chanelleblan/SumobotSkripsie/Tests/Edge detection test/No_brake_Run3.jpeg

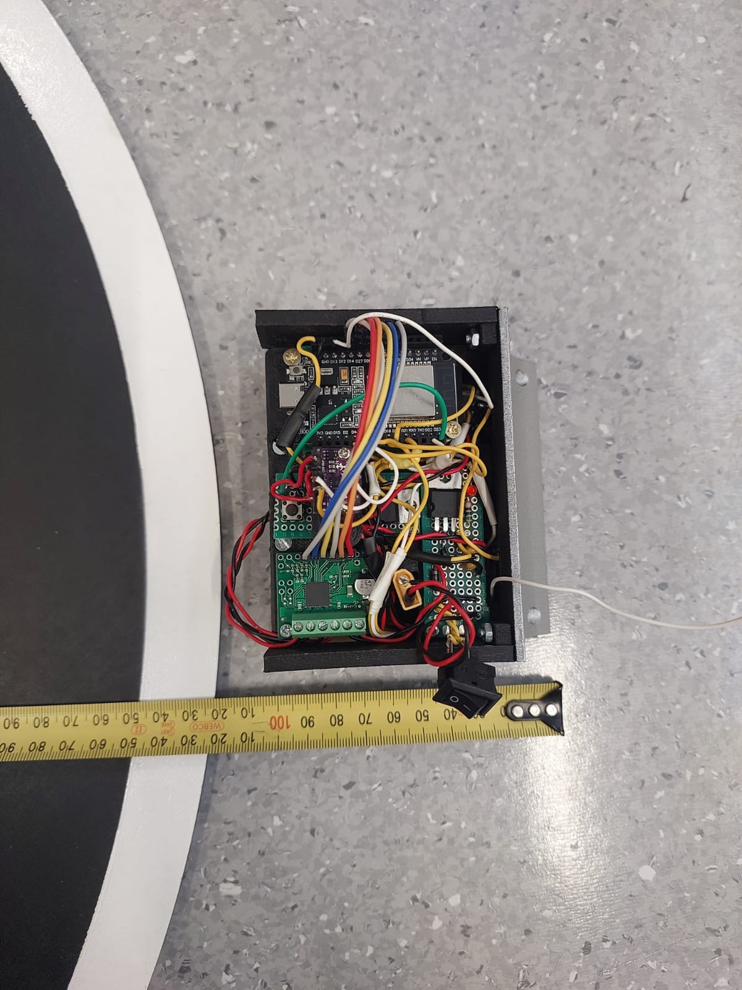
Tests/Edge detection test/No_brake_Run3.jpeg
