chanelleblan/SumobotSkripsie/KiCAD/report.txt

Plotted to 'C:\Users\chane\OneDrive\Documents\Uni files\4th year\Skripsie\sumobot\sumobot.pdf'.

Info: Done.
Info: Done.
