chanelleblan/SumobotSkripsie/FEA/Wedge.ipt Stress Analysis Report 2026_10_19.html

Image Width (pixels):

# Stress Analysis Report

Analyzed File: | Wedge.ipt
Autodesk Inventor Version: | 2026.2 (Build 302298000, 298)
Creation Date: | 2026/10/19, 21:41
Study Author: | CHANELLE BLANCHè
Summary:

## Static Analysis:1

General objective and settings:

Design Objective | Single Point
Study Type | Static Analysis
Last Modification Date | 2026/10/19, 19:17
Model State | [Primary]
Detect and Eliminate Rigid Body Modes | No

### iProperties

#### Summary

Title | side panel v41
Author | AdminForWorker

#### Project

Part Number | side panel
Designer | AdminForWorker
Estimated Cost | R0,00
Creation Date | 2026/10/14

#### Status

Design State | WorkInProgress

#### Physical

Material | Generic
Density | 1 g/cm^3
Mass | 0,0205233 kg
Area | 16021,5 mm^2
Volume | 20523,3 mm^3
Center of Gravity | x=37,5145 mm y=50,9986 mm z=26,8545 mm

Note: Physical values could be different from Physical values used by FEA reported below.

Mesh settings:

Avg. Element Size (fraction of model diameter) | 0.1
Min. Element Size (fraction of avg. size) | 0.2
Grading Factor | 1.5
Max. Turn Angle | 60 deg
Create Curved Mesh Elements | Yes

### Material(s)

Name | PC/ABS Plastic
General | Mass Density | 1,1 g/cm^3
| Yield Strength | 54,4 MPa
| Ultimate Tensile Strength | 54,4 MPa
Stress | Young's Modulus | 2,78 GPa
| Poisson's Ratio | 0,4 ul
| Shear Modulus | 0,992857 GPa
Part Name(s) | Wedge.ipt

### Operating conditions

#### Force:1

Load Type | Force
Magnitude | 5,000 N
Vector X | 0,000 N
Vector Y | -5,000 N
Vector Z | 0,000 N

##### Selected Face(s)

#### Fixed Constraint:2

Constraint Type | Fixed Constraint

##### Selected Face(s)

#### Fixed Constraint:1

Constraint Type | Fixed Constraint

##### Selected Face(s)

### Results

#### Reaction Force and Moment on Constraints

Constraint Name | Reaction Force | | Reaction Moment
| Magnitude | Component (X,Y,Z) | Magnitude | Component (X,Y,Z)
Fixed Constraint:2 | 4,11963 N | 3,51413 N | 0,0198766 N m | 0 N m
| | 0 N | | 0,0198746 N m
| | -2,14994 N | | 0,000278104 N m
Fixed Constraint:1 | 4,16256 N | 0,976093 N | 0,020159 N m | 0 N m
| | 0 N | | -0,020159 N m
| | 4,0465 N | | 0 N m

#### Result Summary

Name | Minimum | Maximum
Volume | 20530,3 mm^3
Mass | 0,0225833 kg
Von Mises Stress | 0,000803823 MPa | 0,859331 MPa
1st Principal Stress | -0,357025 MPa | 0,981189 MPa
3rd Principal Stress | -1,10224 MPa | 0,118242 MPa
Displacement | 0 mm | 0,00662632 mm
Safety Factor | 15 ul | 15 ul
Stress XX | -0,853356 MPa | 0,41657 MPa
Stress XY | -0,171282 MPa | 0,195491 MPa
Stress XZ | -0,159535 MPa | 0,392589 MPa
Stress YY | -0,568904 MPa | 0,206678 MPa
Stress YZ | -0,0829777 MPa | 0,0870701 MPa
Stress ZZ | -0,568904 MPa | 0,80384 MPa
X Displacement | -0,00582415 mm | 0,000840057 mm
Y Displacement | -0,00127097 mm | 0,00127517 mm
Z Displacement | -0,00329077 mm | 0,00118159 mm
Equivalent Strain | 0,000000275279 ul | 0,000291659 ul
1st Principal Strain | -0,000000308708 ul | 0,000312628 ul
3rd Principal Strain | -0,000278707 ul | -0,000000143047 ul
Strain XX | -0,00022606 ul | 0,000065817 ul
Strain XY | -0,0000862569 ul | 0,0000984489 ul
Strain XZ | -0,0000803412 ul | 0,000197707 ul
Strain YY | -0,000160855 ul | 0,0000867544 ul
Strain YZ | -0,0000417873 ul | 0,0000438483 ul
Strain ZZ | -0,0000261425 ul | 0,000223316 ul

#### Figures

##### Von Mises Stress

##### 1st Principal Stress

##### 3rd Principal Stress

##### Displacement

##### Safety Factor

##### Stress XX

##### Stress XY

##### Stress XZ

##### Stress YY

##### Stress YZ

##### Stress ZZ

##### X Displacement

##### Y Displacement

##### Z Displacement

##### Equivalent Strain

##### 1st Principal Strain

##### 3rd Principal Strain

##### Strain XX

##### Strain XY

##### Strain XZ

##### Strain YY

##### Strain YZ

##### Strain ZZ

C:\Users\chane\OneDrive\Documents\Uni files\4th year\Skripsie\Final Drawings\Wedge.ipt

Image Width (pixels):
