chanelleblan/SumobotSkripsie/Planning/SPECS AND TPMS.docx

Table 1: Functional Requirements for the Sumo Robot

FR ID | Description | Primary / Derived
FR_01 | The robot must detect the opponent/ opposing robot. | Primary
FR_02 | The robot must detect the edge of the dohyo. | Primary
FR_03 | The robot must move within the dohyo. | Primary
FR_04 | The robot must apply sufficient force to push the opponent out of the dohyo. | Derived
FR_05 | The robot must respond in real-time to the opponent. | Derived
FR_06 | The robot must operate autonomously. | Primary
FR_07 | The robot should remain within the size and weight limits on the competition class. | Primary
FR_08 | The robot must be self-contained. | Primary
FR_09 | The robot must avoid the dohyo edge and prioritise avoiding the dohyo edge over attacking the opponent. | Derived
FR_10 | The robot must begin operation only after the required competition start delay. | Primary
FR_11 | The robot must not damage the dohyo, the opponent robot or itself during normal operation. | Primary

Table 2: Technical Performance Measures

TPM ID | Related FR | Description | Target | Range
TPM_01 | FR_06 | Start time after initial power-on. | 5 s | 3 – 10 s
TPM_02 | FR_01 | Detection of opponent. | 50 ms | 0 – 100 ms
TPM_03 | FR_07 | Size constraints. | 10 cm x 10 cm | -
TPM_04 | FR_07 | Weight constraint. | 500 g | < 500 g
TPM_05 | FR_07 | Height. | 4 cm | < 10 cm
TPM_06 | FR_02 | Edge sensor response. | - | 0 – 100 ms
TPM_07 | FR_03 | Forward movement speed of the robot. | 0.3 m/s | 0.1 m/s – 0.77 m/s
TPM_08 | FR_04 | Pushing force of the robot. | 1.5 kg | 0.5 – 1.5 kg
TPM_09 | FR_08 | Power supply | 6 V | 3 – 12 V
TPM_10 | FR_05 | Sensor response time. | - | 0 – 100 ms
TPM_11 | FR_05 | Robot response time. | - | 0 – 200 ms
TPM_12 | FR_03 | Turning radius (tank turn) | 5 cm | -
TPM_13 | FR_01 | Accurate opponent detection range. | - | 0 – 77 mm
TPM_14 | FR_01 | Opponent detection angle. | ≥ 60° | 40 – 180°
TPM_15 | FR_02 | Edge detection distance from dohyo boundary | - | 0 – 5 mm
TPM_16 | FR_02 | Edge avoidance reaction time | < 100 ms | 0 – 200 ms
TPM_17 | FR_03 | Acceleration time to operating speed | < 1 s | 0.5 – 2 s
TPM_18 | FR_04 | Wheel traction / ability to avoid wheel slip | No slip during push | -
TPM_19 | FR_04 | Push duration before motor stall | ≥ 5 s | 2 – 10 s
TPM_20 | FR_05 | Decision-making/control loop update rate | ≥ 20 Hz | 10 – 100 Hz
TPM_21 | FR_06 | Number of successful autonomous runs. | ≥ 8/10 runs | -
TPM_22 | FR_08 | Battery voltage under load | ≥ 5 V | 4.8 – 6 V
TPM_23 | FR_08 | Battery operating time under active driving | ≥ 12 min | 3 – 24 min
