chanelleblan/SumobotSkripsie/Presentations/Final_present.pptx

## SUMO ROBOT CHANELLE BLANCHE

Photo by Stefan Els

## Introduction

- What is a Sumo Robot?

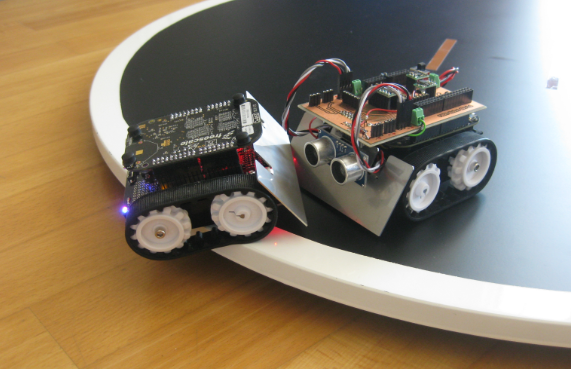
[picture p3: figure]
Mini Sumo Robot Competition running with FRDM-KL25Z | MCU on Eclipse

(Erich Styger, 2013)

- Detects and engages an opponent
- Pushes the opponent outside the circular arena
- Operates without human intervention once the match begins
- Fully autonomous robot

## Competition Rules & Constraints

- Mini Autonomous Sumobot Class

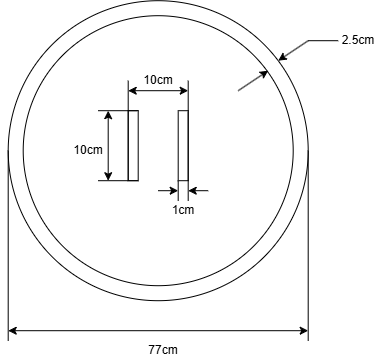
[picture p4: figure]

Constraint | Value
Size | 100 mm x 100 mm
Weight | 500 g
Arena | 770 mm diameter

## Main Strategy

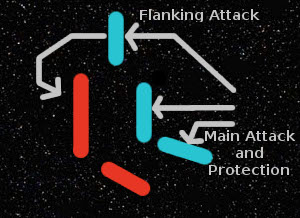
[picture p5: figure]
Master of Tactics' and Making Strategy Games More Strategic | GamingOnLinux

(GamingOnLinux, 2026)

- Most Sumobot hobbyists utilize a DIP switch
- Heavily depends on decision made beforehand
- Fully autonomous
- Gather opponent data
- Focus on out-manoeuvring

## Concept Design

- Overview

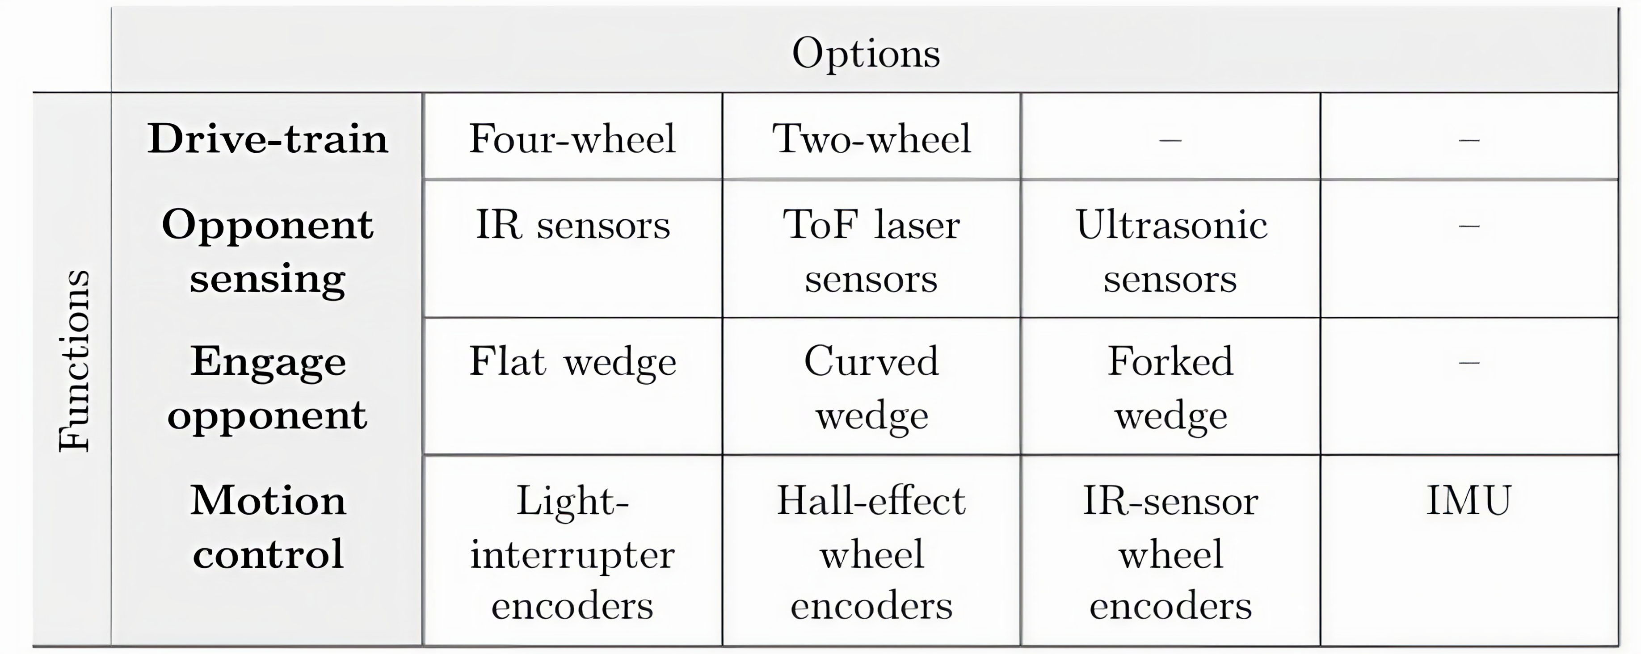
[picture p6: figure]

## Concept Design

- Two-wheel Drive

- Differential drive
- Manoeuvrability
- Space

VL53L0x ToF

- Odd geometry
- Less interference
- Reliable

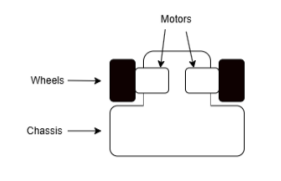
[picture p7: figure]
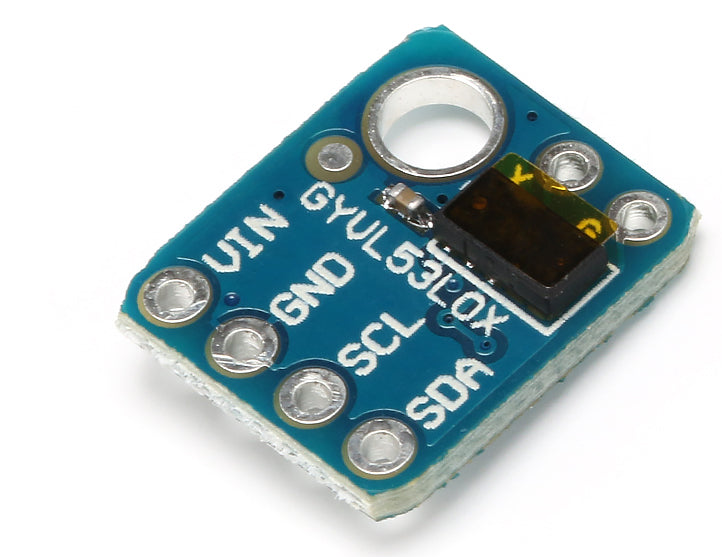
[picture p8: figure]
VL53L0X Time of Flight Sensor (2m Precision Distance Measurements ) – Future Electronics Egypt

(Microrobotics, 2026)

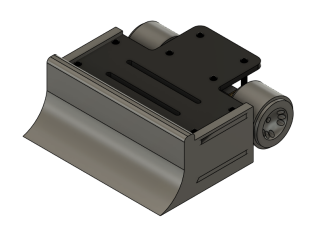
[picture p9: figure]

Curved wedge

- Divert opponent
- Protect sensors

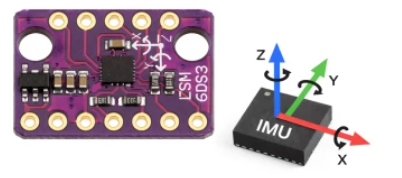
[picture p10: figure]

(Microrobotics, 2026)

LSM6DS3 IMU

- PID and heading control
- Traction control

## Design Refinement

- Opponent Detection Sensors

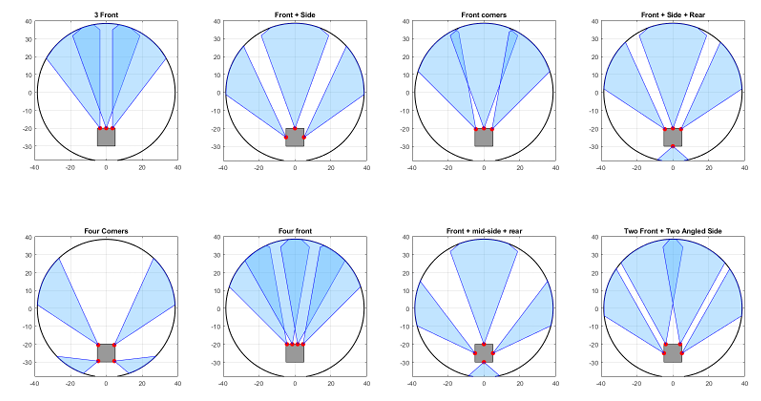
[picture p11: figure]

- Tested to determine placement
- 20 – 30 degrees FOV
- Two front, two angled side chosen

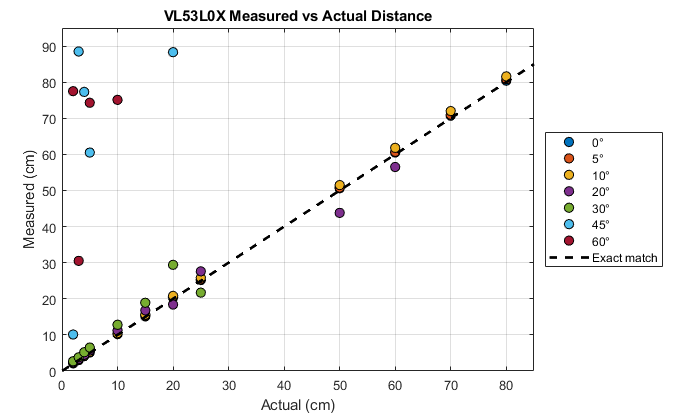
[picture p12: figure]

## Slide 8

Design Refinement

- Main body

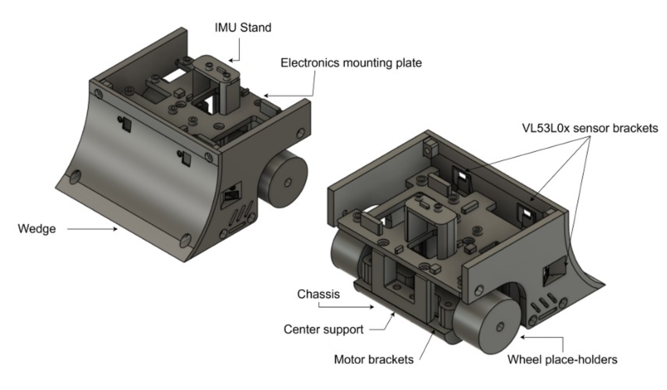
[picture p13: figure]

- PETG
- 300 RPM N20 motors
- 12 V LiPo
- Linear voltage regulators
- QRE1113 IR edge detection
- IMU on driveline
- Casing for extra weights
- ESP32 used to control the system

## Design Refinement

- Wheels

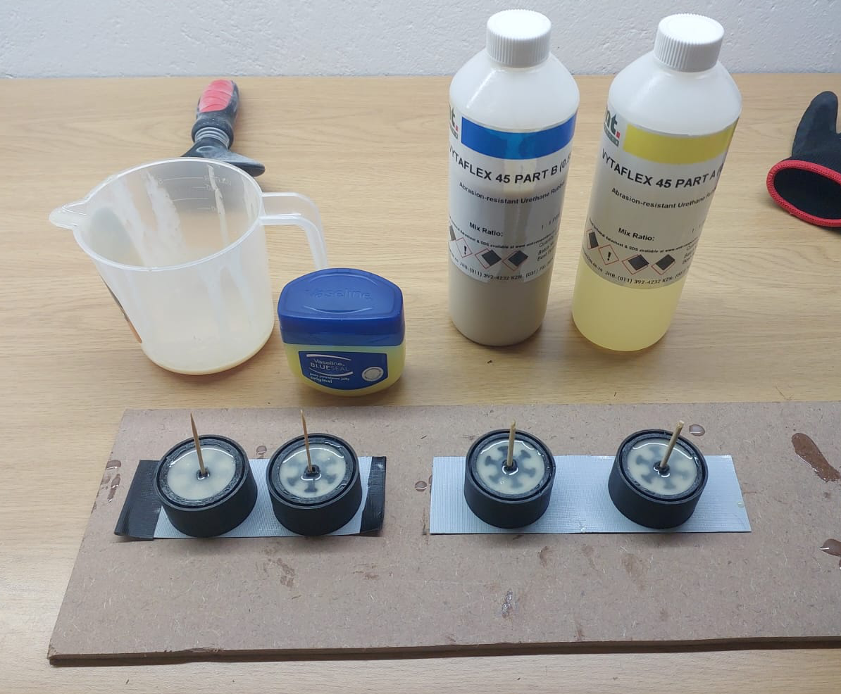
[picture p14: figure]

- Custom-cast polyurethane (VytaFlex) wheels
- High coefficient of friction for increased traction
- Roughly 2.48 compared to 0.36
- Cast directly onto 3D-printed hubs

## Finite State Machine

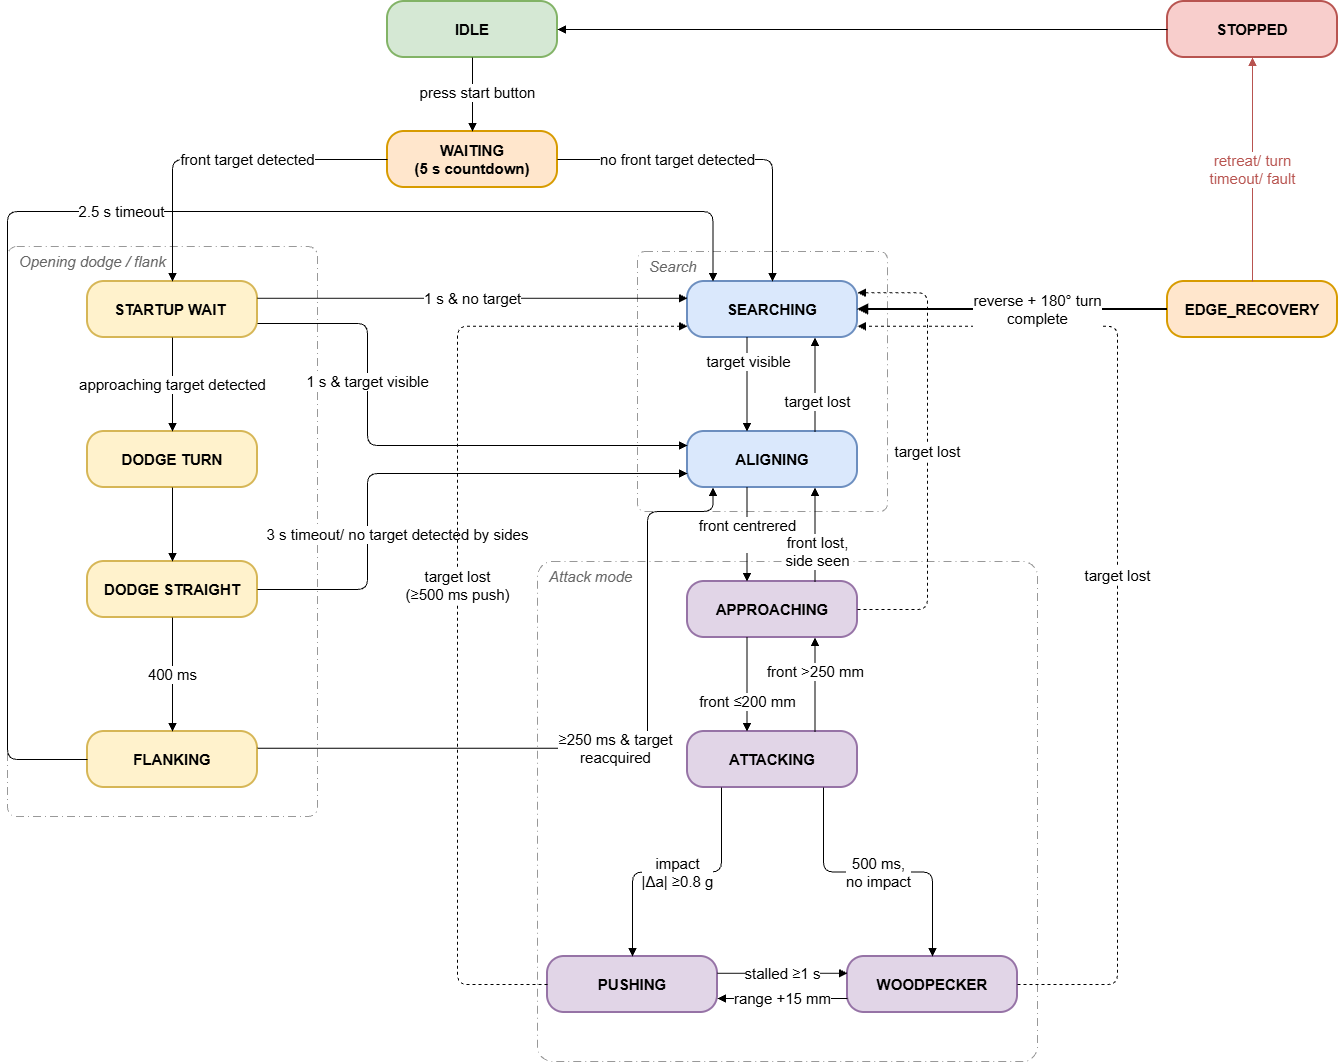
[picture p15: figure]

- Idle state system checks
- Press button
- Searching either detects or waits
- Fast approaching
- Dodge
- Align between front sensors
- Approach starts slow, increases speed
- Engage, override PID, push
- Woodpecker if push lasts for too long
- Edge recovery overrides all states

## Control System

- LSM6DS3 feedback

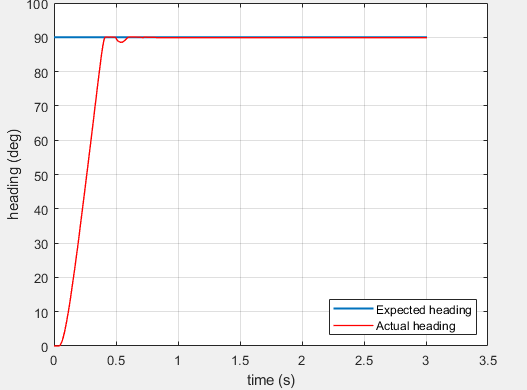
[picture p16: figure]
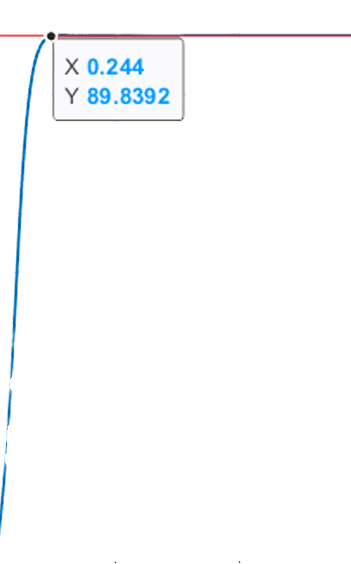
[picture p17: figure]

- PD control
- Similar to simulated response
- Built-in MATLAB functions for differential drive
- I caused sluggish reactions

- Gyroscope and accelerometer
- Used in drones and balancing bots
- PID control
- Impact detection

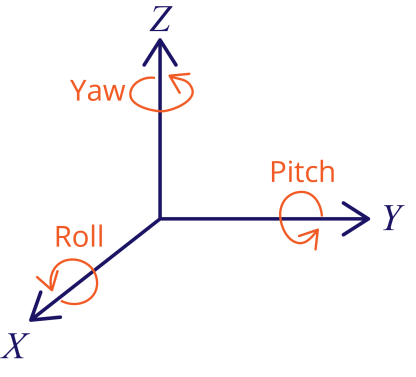
[picture p18: figure]
Arduino Guide for MPU-6050 Accelerometer and Gyroscope | Random Nerd Tutorials

(Sara Santos , 2021)

## Final System Tests

- Speed and edge detection

Opponent detection

- Sensors met TPM for opponent detection distance
- Readings outside of arena
- Threshold implemented
- Speed of search adjusted to allow readings

Autonomous runs

- Edge detection overrides other states
- Braking and edge pivot prevents sliding over the edge
- Speed increases as approaches

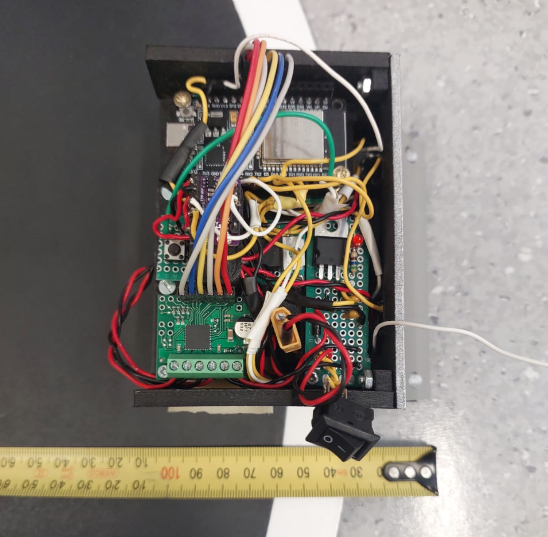
[picture p19: figure]
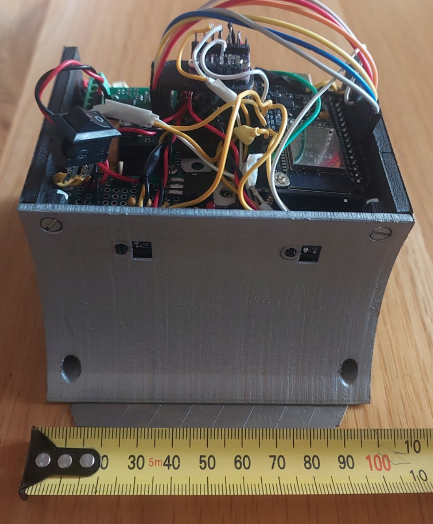
[picture p20: figure]

- 450 g, 10 cm x 10 cm
- Multiple successful runs using stationary weights
- Won 2/3 opponents

## Safety and Risk Mitigation

Risk | Mitigation
Motor stall | Back-off, nFAULT pin
Power supply protection | Linear regulators
Reverse voltage protection | Diodes
Current protection | Fuses
LiPo battery damage | Consistently monitor voltage levels and charge/ handle safely
Component availability low | Back-ups/ alternatives planned
Overall system safety | Modular design, idle state, system stop

## Budget

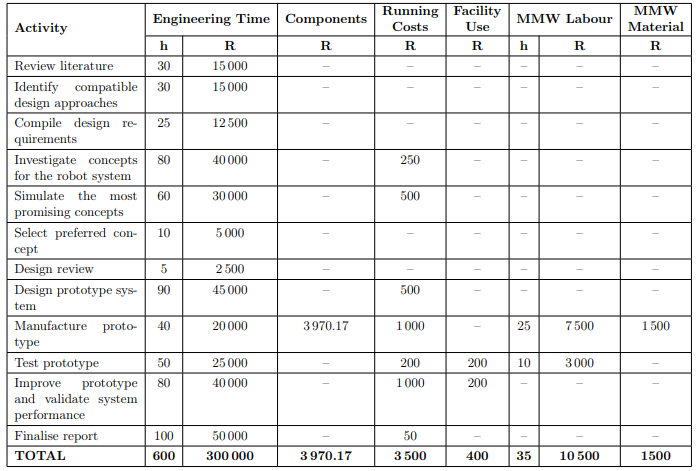
[picture p21: figure]

- Under budget regarding component procurement
- Over the initial planned budget due to prototyping and reprints

## Project Plan

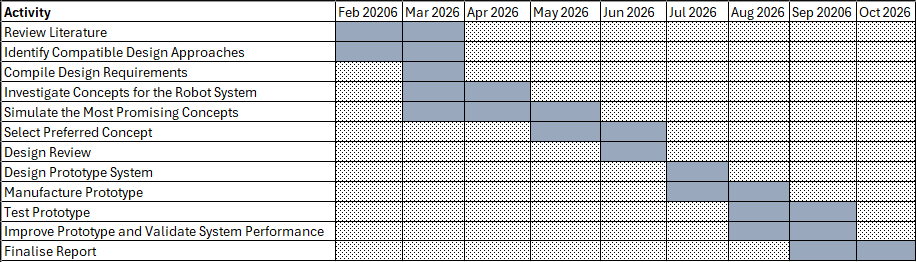
[picture p22: figure]

- Initial plan excluded some categories
- Plan revised in July 2026
- More activities in parallel
- Remained on schedule after revised plan

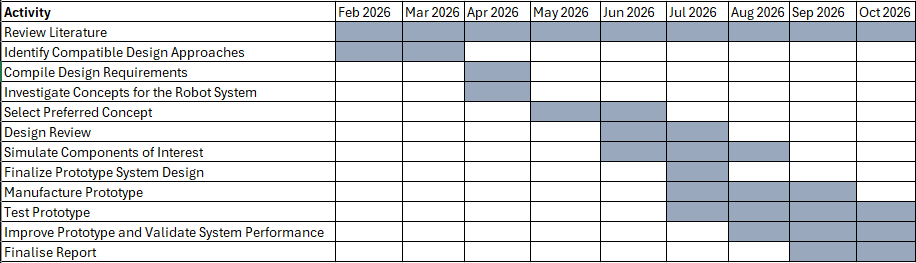
[picture p23: figure]

## Future Work

- Successful sensor array and autonomous runs
- Base framework set in place
- Brushless motors
- Additional states added to FSM
- PCB to organize and optimize electronics
- Manufactured parts

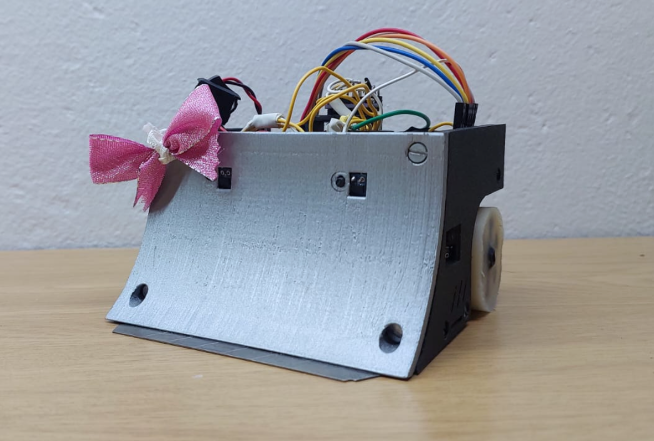
[picture p24: figure]

## Slide 17

Thank you
Enkosi
Dankie

Photo by Stefan Els

## Microcontroller

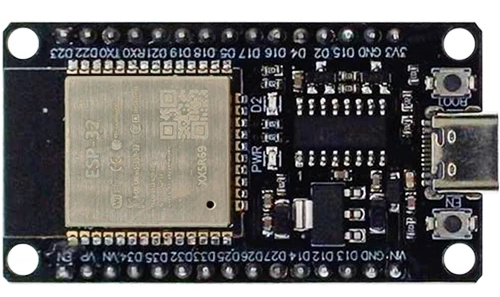
[picture p25: figure]

(Microrobotics, 2026)

- ESP32 DEVKit V1
- Noisy ADCs
- Considered STM32 Black Pill
- 3.3V Logic
- Higher clock speed, more flash

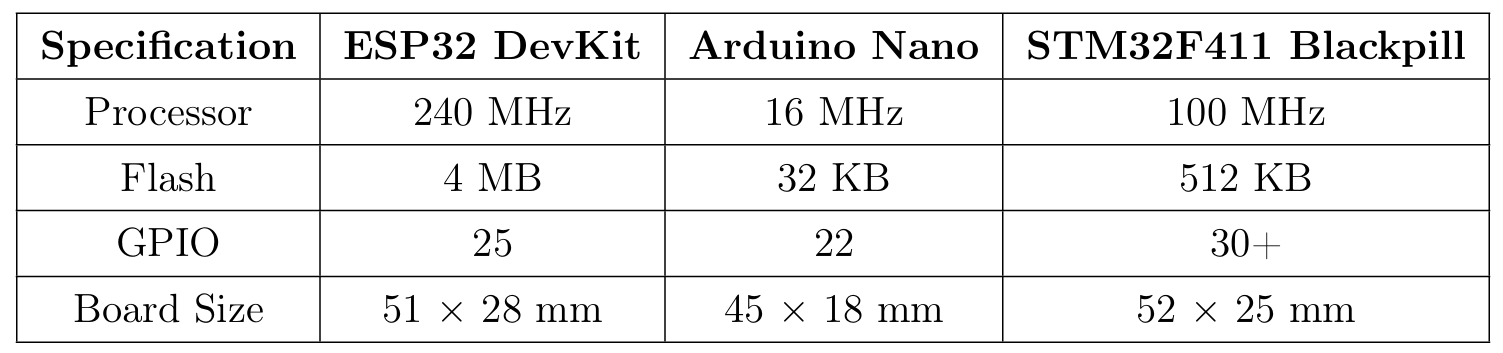
[picture p26: figure]

## Slide 19

VL53L0X Testing

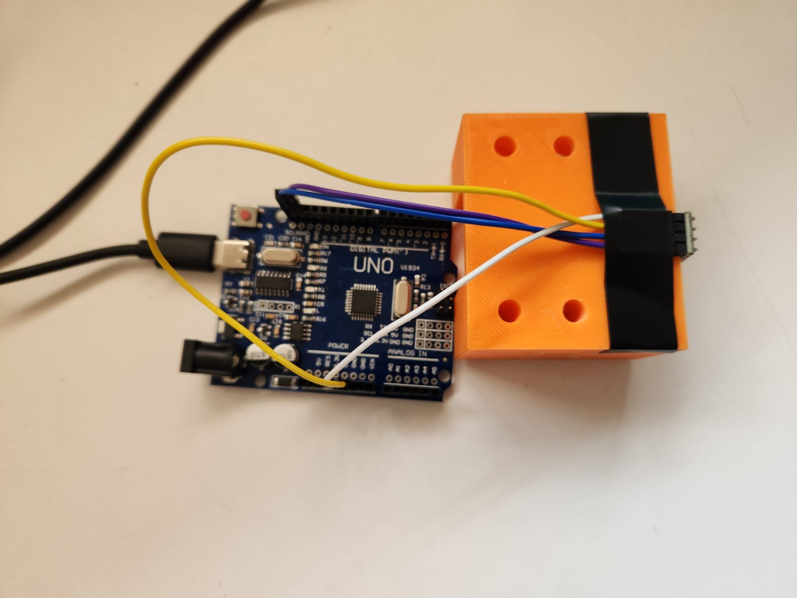
[picture p27: figure]
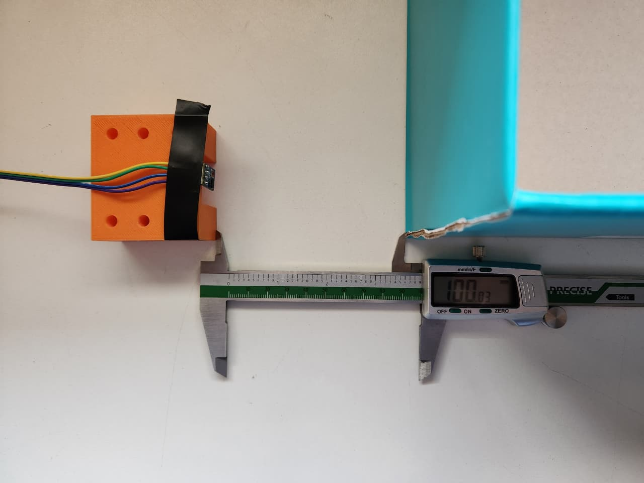
[picture p28: figure]
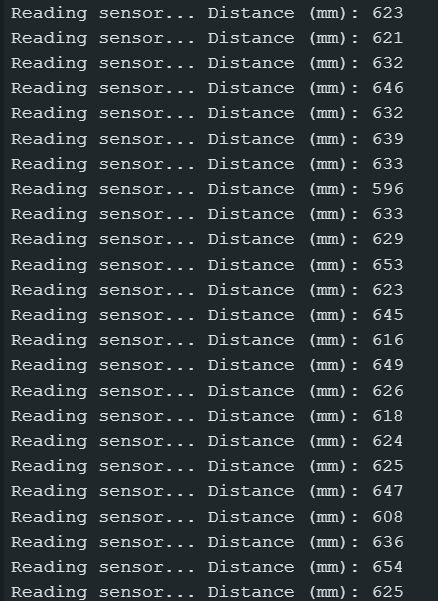
[picture p29: figure]
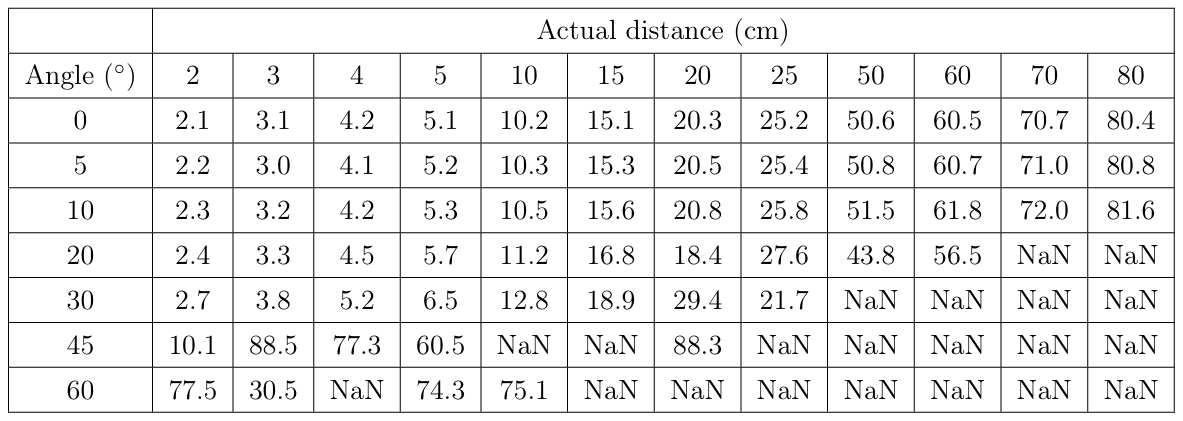
[picture p30: figure]

## Slide 20

Electrical Summary

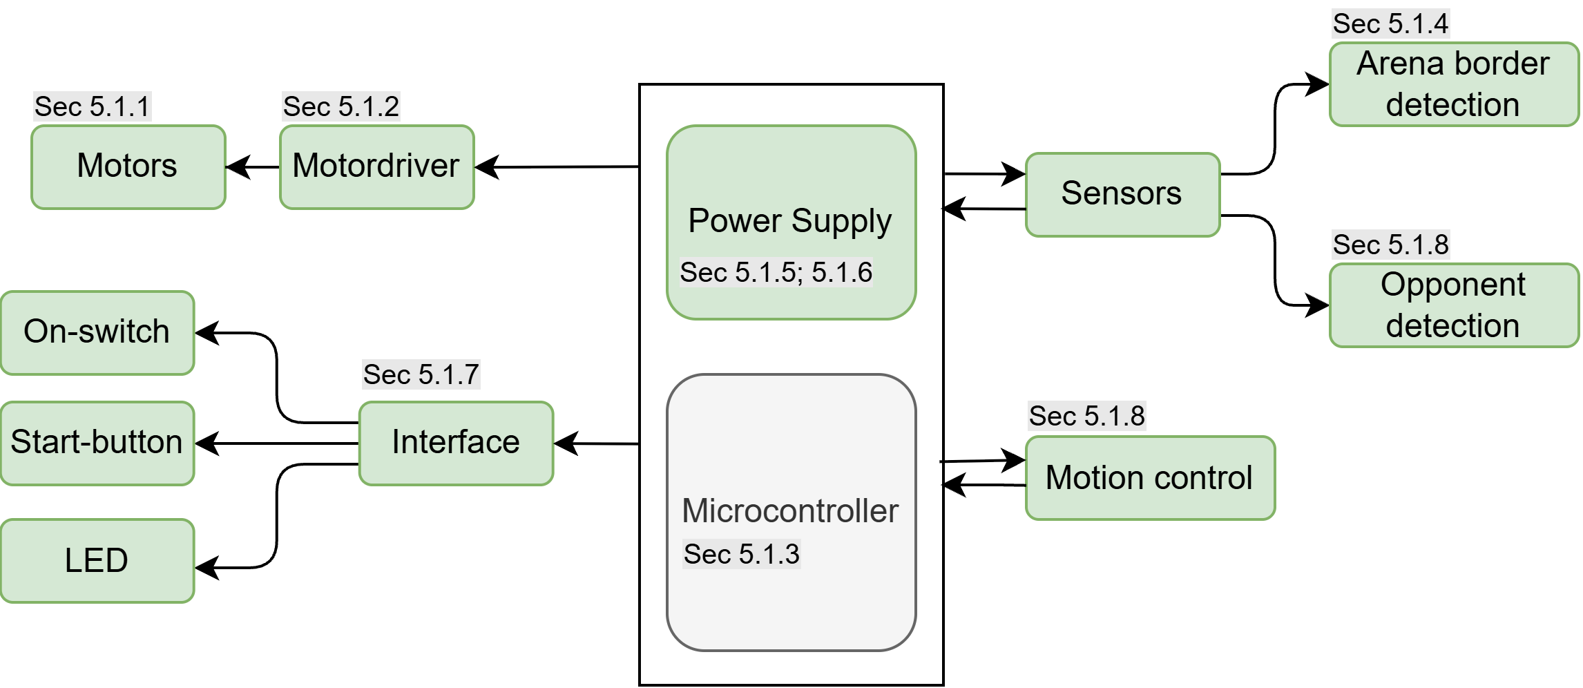
[picture p31: figure]

## Slide 21

Wheel Design

- 2 degree draft angle, lowered from original 5 degree
- Mold release agent
- Molded directly to hub

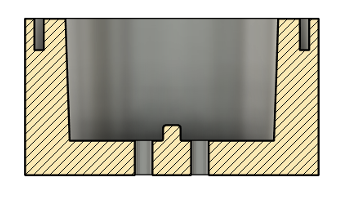
[picture p32: figure]
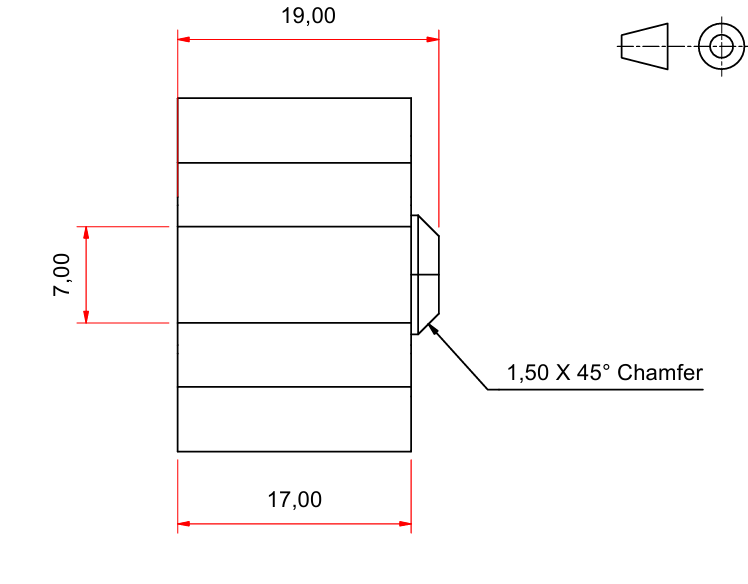
[picture p33: figure]

- Release on round edge of D-slot
- Slides onto D-shaft
- Brackets for extra grip onto polyurethane

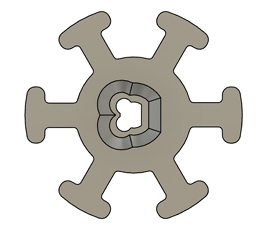
[picture p34: figure]

## Slide 22

PETG Safety Test

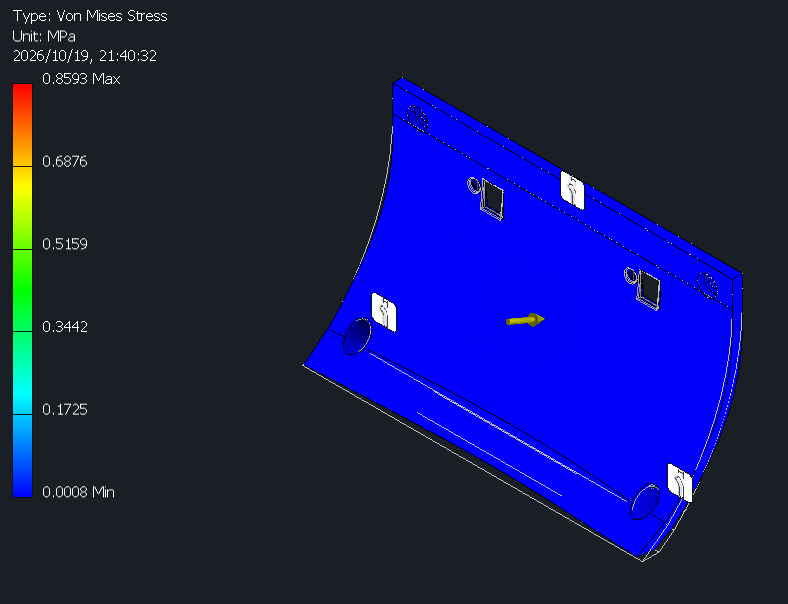
[picture p35: figure]

- Estimated force based on own design
- Doubled the force to account for stronger motors
- SF of 15
- Displacement along the lower front edge, no displacement near sensors

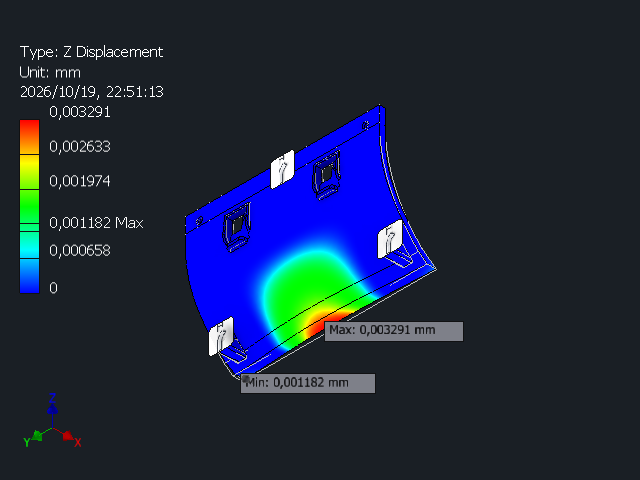
[picture p36: figure]

## Full Schematic Plan

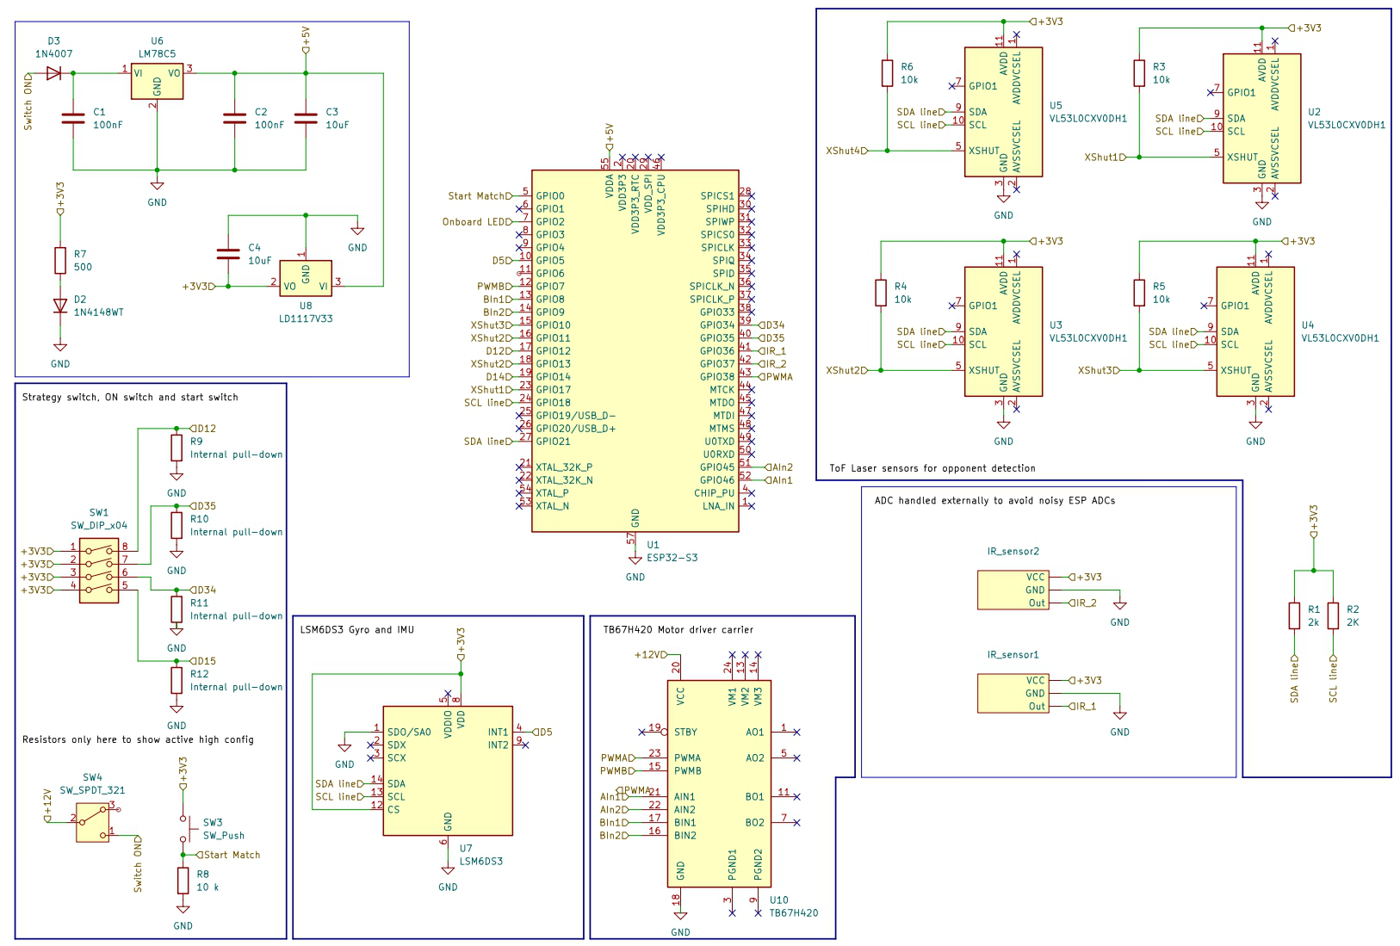
[picture p37: figure]

## System Model

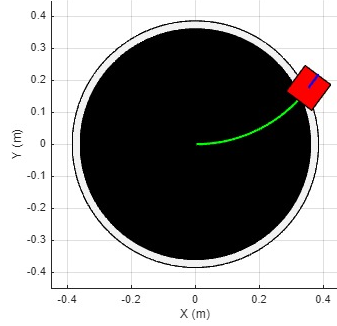
[picture p38: figure]
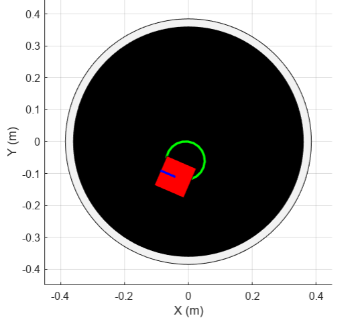
[picture p39: figure]
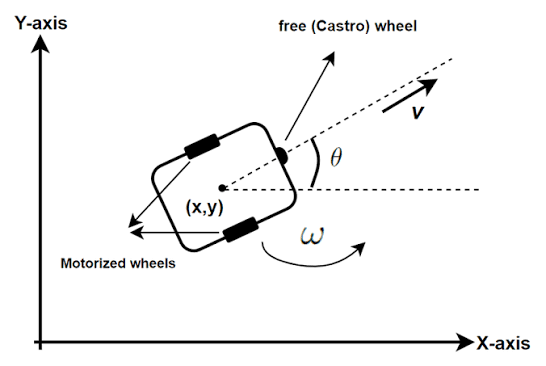
[picture p40: figure]
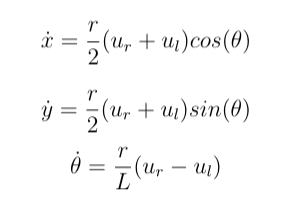
[picture p41: figure]

## Battery

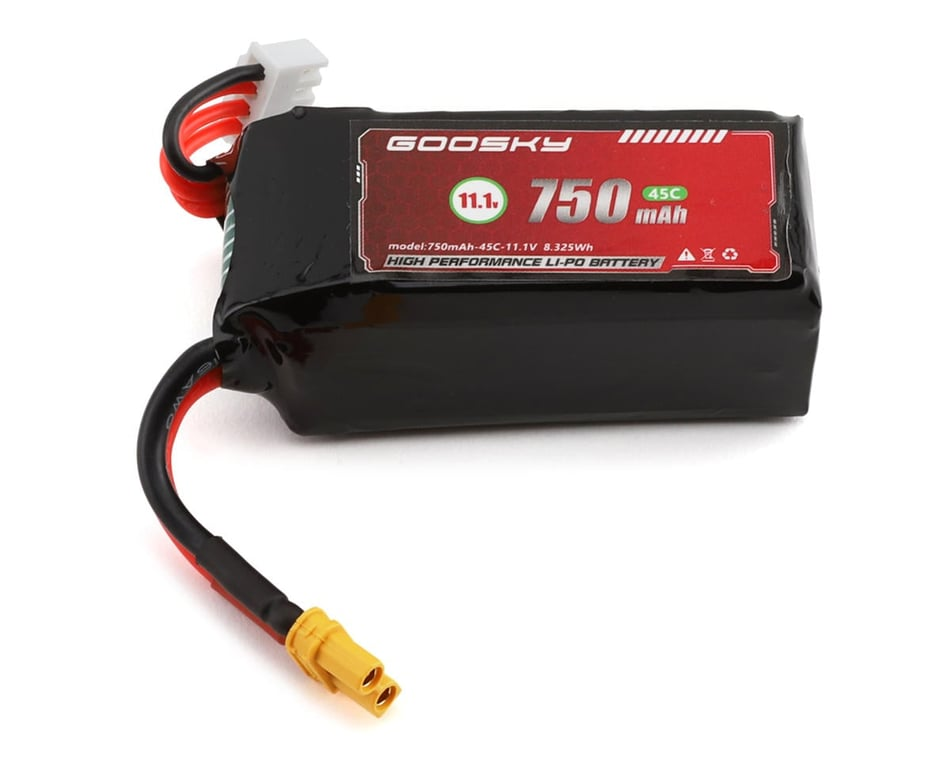
[picture p42: figure]
GooSky S2 RTF Micro Electric Helicopter Combo (Pink) [GSK-BAF000018] - AMain Hobbies

(Goblin Hobbies, 2026)

- 3S 11.1V LiPo Battery
- 45C, 750mAh, 8.125Wh 33A
- 68g
