chanelleblan/SumobotSkripsie/Minutes/Chanelle_AGENDA 12 Oct.docx

Chanelle AGENDA – 12 Oct

- Lit review, move comparison charts?
- PID, software to testing method
- Tensile test
