chanelleblan/SumobotSkripsie/Minutes/Chanelle_AGENDA 14 APR.docx

14 April Agenda – Chanelle Blanchè

- Setting requirements for the pushing force, torque, speed etc
- Simulation advice – MATLAB, Simulink, python
