chanelleblan/SumobotSkripsie/Minutes/Chanelle_AGENDA 17 FEB.docx

AGENDA 17 FEB

- What should be uploaded to the drive (everything or just what we want the supervisor to see)
- Jetson, Arduino uno
- Past skripsies that might help
