chanelleblan/SumobotSkripsie/Minutes/Chanelle_AGENDA 19 Oct.docx

Chanelle_AGENDA 19 Oct

- PID testing flow confirm -> sim, heading PID, turn PID
- Were enough tests discussed? (smaller tests like sensors left out)
- Tuning discussed with tests
- Project file handin after project report handin?
- Safety report: fine to just include risk assessment save space
- Testing steps needed/ photos?
- Include wheel making photos/ process?
- Include friction test in material discussion or in testing section?
