chanelleblan/SumobotSkripsie/Planning/List of Documents.docx

List of Documents:

Admin:

- Part printing tracker
- Parts list
- Price of consumables
- Full budget (consumables and work hours)
- Gannt chart

Reports:

- Project proposal
- Progress report
- Draft report
- Final report
- Summary of how each GA is met

Presentations:

- Progress presentation
- Final presentation (?)

Videos:

- LED test with VL53L0x sensors
- Initial motor test (only motors)
- Initial motor test (bot behaviour)
- Sensor test (follow object)
- Edge test (driving over edge)
- Edge test (slight reverse added to break motors – stops earlier)
- PID step response test (near perfect response)
- PID step response test (visible oscillations)
- Opponent reaction/push test (overshoots reaction)
- Opponent reaction/push test (connects with opponent)
- Searching arena, reacting once opponent is placed inside

Tests:

- VL53L0x angle (view range)
- VL53L0x detection range
- Implemented VL53L0x response time
- IR edge response time
- PID tuning
- PID step response
- Maximum robot speed
- Pushing force
- Autonomous behaviour

Drawings:

- Drawing Tree Excel sheet
- All part drawings
- All sub-assembly drawings (4)
- Full assembly drawing

Schematics:

- Full KiCAD schematic
- LTSpice power supply schematic

Code:

- ESP code (vscode)
- Matlab PID graphs (differential drive)
- Matlab sensor plots
- Matlab sensor layout plan
