chanelleblan/SumobotSkripsie/Presentations/Progress_present.pptx

## SUMO ROBOT CHANELLE BLANCHE

Photo by Stefan Els

## Introduction

- What is a Sumo Robot?

Mini Sumo Robot Competition running with FRDM-KL25Z | MCU on Eclipse

(Erich Styger, 2013)

- Detects and engages an opponent
- Pushes the opponent outside the circular arena
- Operates without human intervention once the match begins
- Fully autonomous robot

## Competition Rules & Constraints

- Mini Autonomous Sumobot Class


Constraint | Value
Size | 100 mm x 100 mm
Weight | 500 g
Arena | 770 mm diameter

## Main Strategy

Master of Tactics' and Making Strategy Games More Strategic | GamingOnLinux

(GamingOnLinux, 2026)

- Most Sumobot hobbyists utilize a DIP switch
- Fully autonomous
- Gather opponent data
- Focus on out-manoeuvring

## Electrical

Electrical Design
Opponent detection sensors
Dohyo edge-detection sensors
Motor driver
Controller
Power supply
Feedback

- Overview

## Electrical

- Opponent Detection Sensors


- VL53L0X ToF
- Detect odd geometry
- I2C Communication – save space
- Effective range of 2m
- Effective angle of 25°
- Tested to determine placement

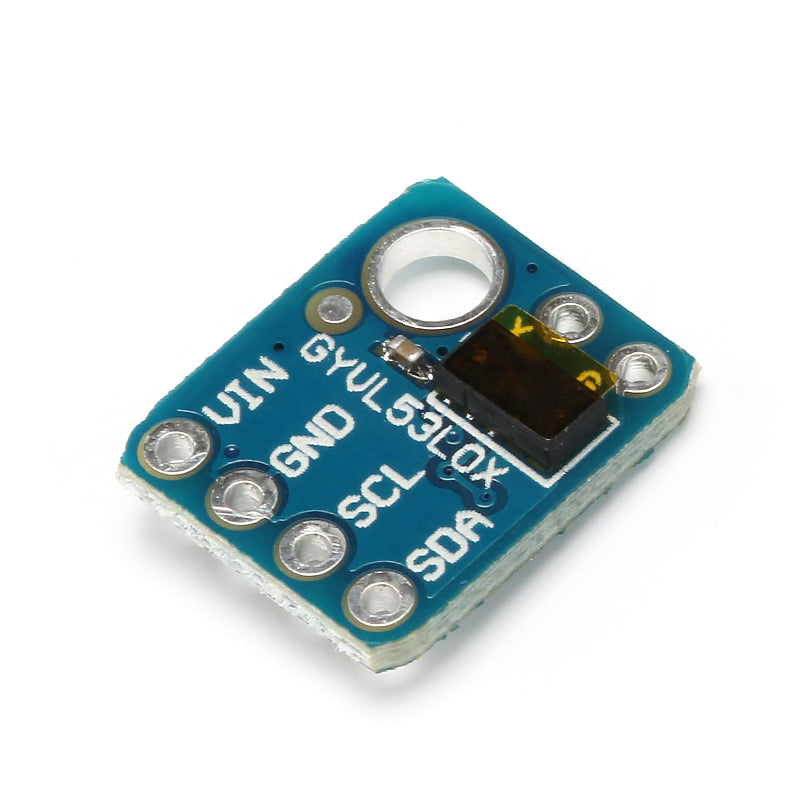
[picture p43: figure]
VL53L0X Time of Flight Sensor (2m Precision Distance Measurements ) – Future Electronics Egypt

(Microrobotics, 2026)

## Electrical

- Dohyo Border Detection Sensors

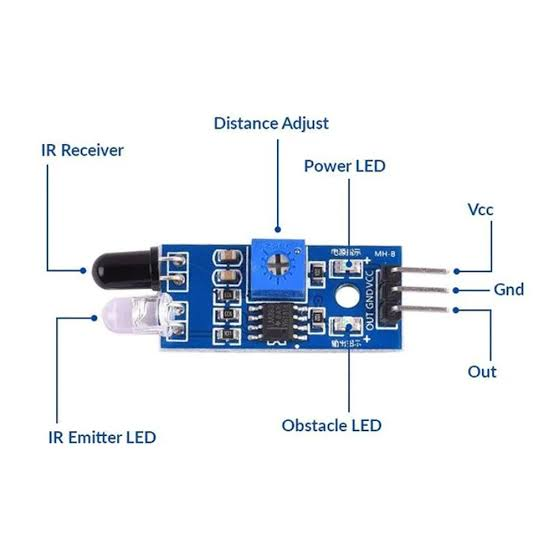
[picture p44: figure]
IR Sensor Digital Single Array Line Sensor | AM Electronics

(Microrobotics, 2026)

- IR Obstacle Detection Sensors
- White vs Black
- On-board potentiometer – Adjustable sensitivity

## Electrical

- Microcontroller

- STM32F411CEU6 Black Pill
- I2C, SPI, ADC, DAC, USART, 11 timers, PWM
- Had enough pins to support all peripherals
- 3.3V Logic
- Flash 512KB, SRAM 128KB, 100 MHz
- Fairly inexpensive

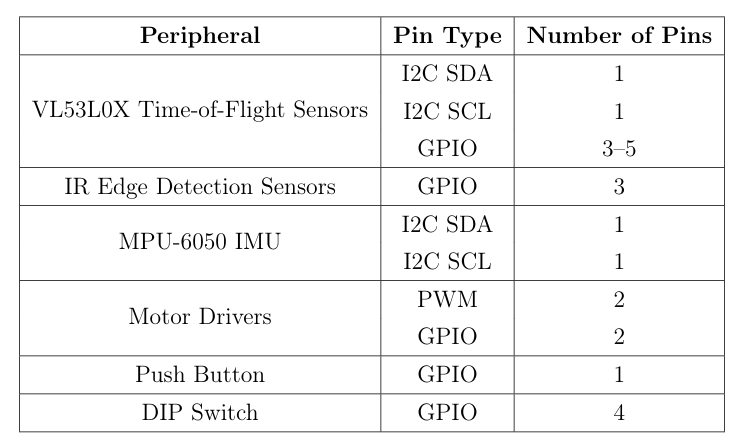
[picture p45: figure]
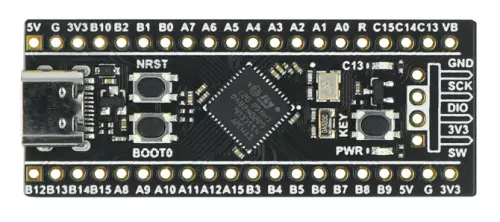
[picture p46: figure]

(Microrobotics, 2026)

## Electrical

- Power supply

GooSky S2 RTF Micro Electric Helicopter Combo (Pink) [GSK-BAF000018] - AMain Hobbies

(Goblin Hobbies, 2026)

- 3S 11.1V LiPo Battery
- 45C, 750mAh, 8.125Wh 33A
- 68g

## Mechanical

- Overview

Mechanical Design
Chassis
Drive train
Wedge
Supporting frame

## Mechanical

- Drive-train

- Differential drive
- Approximately 0 cm turning radius
- 12V N20 500rpm motors
- 30 mm wheels
- Motor driver TB67H420FTG carrier
- Steering is achieved by varying the wheel speeds

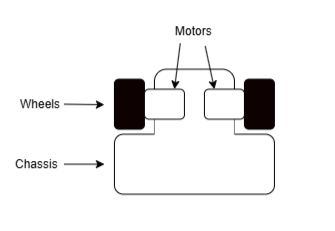
[picture p47: figure]

## Mechanical

- Wheels

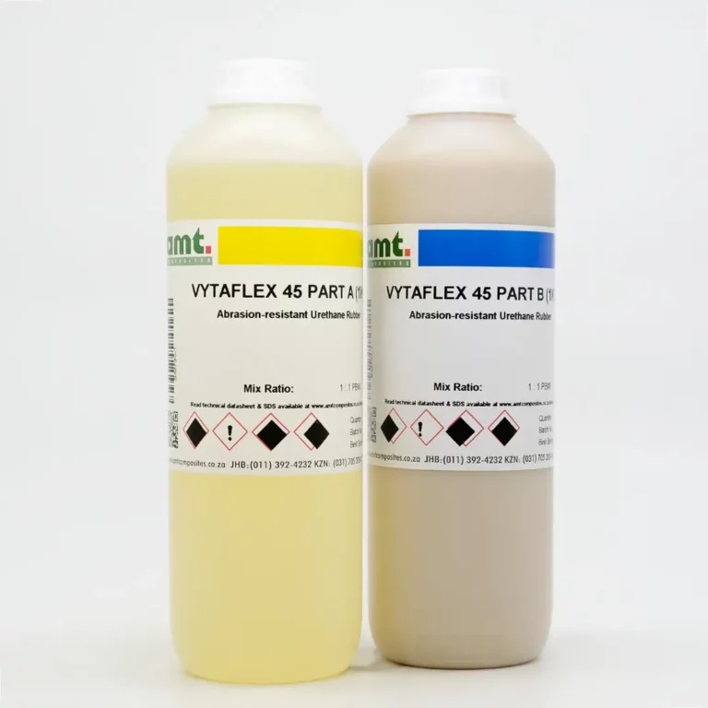
[picture p48: figure]

(AMT Composites, 2026)

- Custom-cast polyurethane (VytaFlex 45) wheels
- High coefficient of friction for increased traction
- Shore 45A hardness balances grip and durability
- Cast directly onto 3D-printed hubs

## Mechanical

- Main body

- 3D printed using PETG
- Higher impact resistance than PLA
- Better heat resistance near motors and electronics
- Good balance between strength, weight and ease of printing
- Curved wedge provides progressive lifting
- Improves engagement with varying opponent heights
- Reduces impact loading during collisions

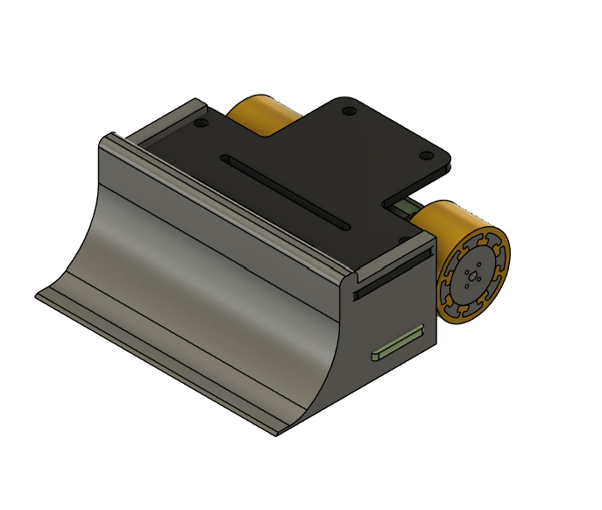
[picture p49: figure]

## Control System

- MPU6050 Feedback

Arduino Guide for MPU-6050 Accelerometer and Gyroscope | Random Nerd Tutorials

- Gyroscope and accelerometer
- Used in drones and balancing bots
- Yaw, X- and Y-acceleration
- PID control
- Impact detection

(Sara Santos , 2021)

## Risks and Risk Mitigation

Risk | Mitigation
Motor stall | Back-off, nFAULT pin
Electrical failure or incorrect readings | Extensive testing, Calibration, Compare readings
Voltage protection | Buck converter
Current protection | Fuses
LiPo battery damage | Consistently monitor voltage levels and charge/ handle safely
Component availability low | Back-ups/ alternatives planned
Overall system safety | Modular design

## Progress to Date

## Budget

## Planned Work

AUG
Test components
- Sensors
- Driver and motors
- Refine Frame
SEPT
Code strategy
Implement PID
Tune based on performance
OCT
Clean up project
Modify parts if needed
Final report
NOV
Final presentation

## Slide 19

Thank you
Enkosi
Dankie

Photo by Stefan Els

## VL53L0X Testing

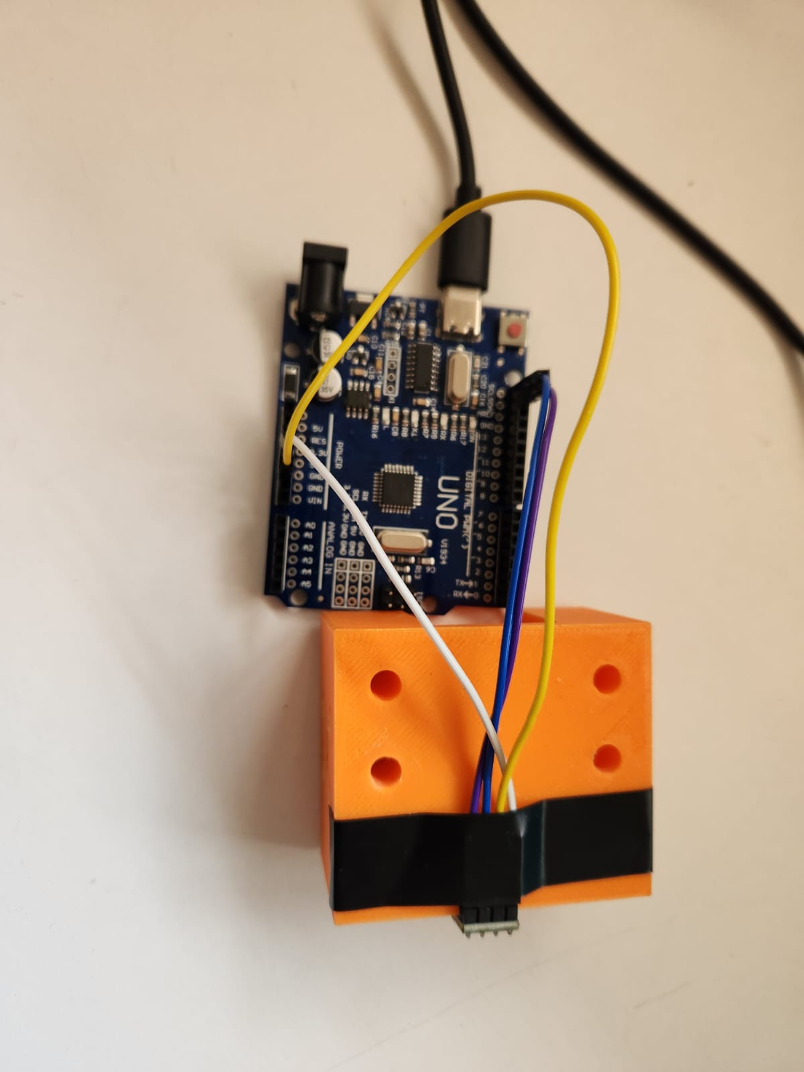
[picture p50: figure]
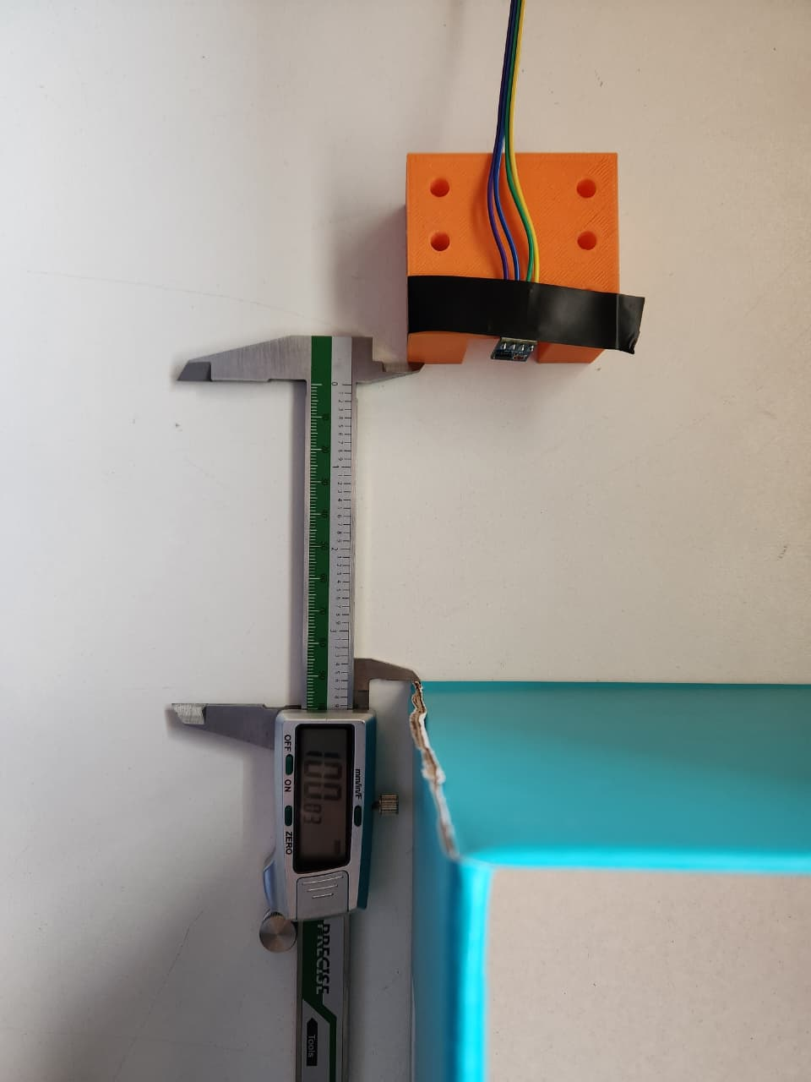
[picture p51: figure]

## VL53L0X Simulation

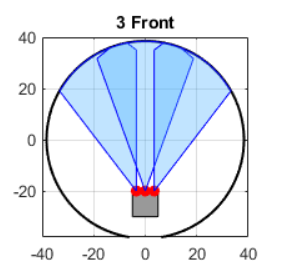
[picture p52: figure]
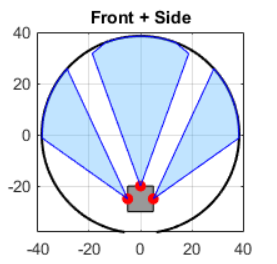
[picture p53: figure]
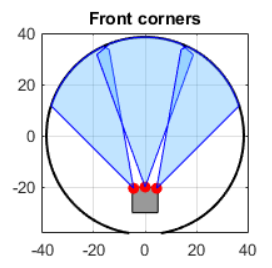
[picture p54: figure]
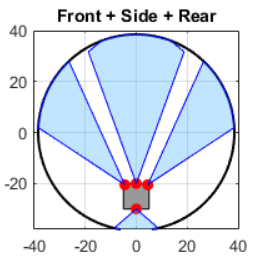
[picture p55: figure]
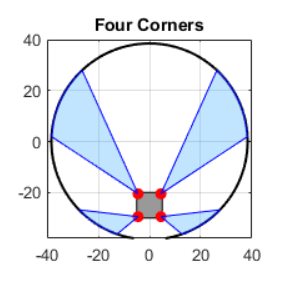
[picture p56: figure]
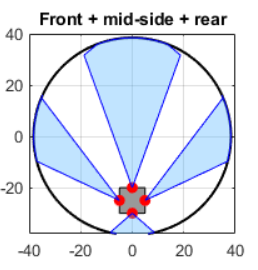
[picture p57: figure]

## Full Schematic Plan

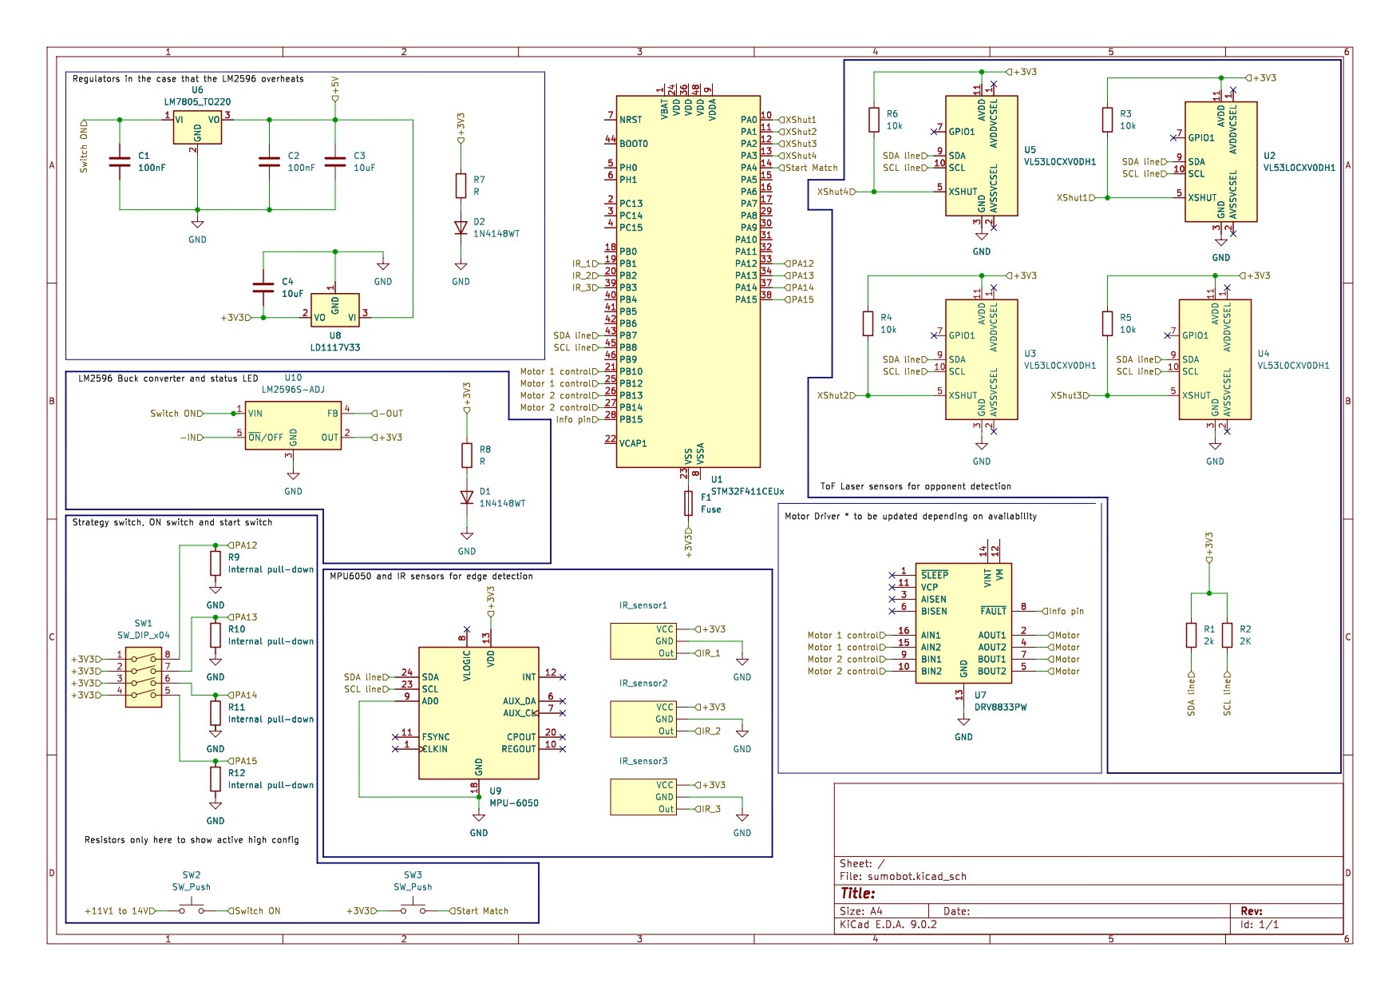
[picture p58: figure]

## Buck Regulator

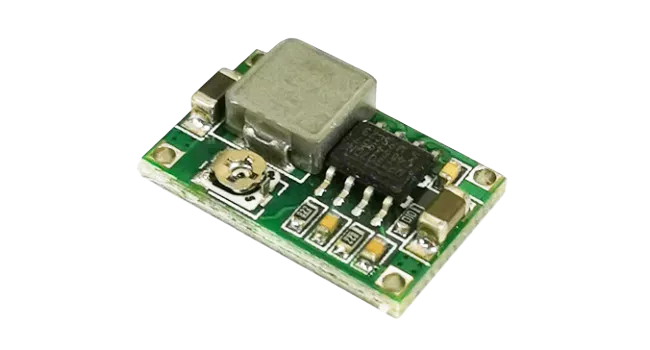
[picture p59: figure]

(Microrobotics, 2026)

- LM2596 Mini Buck Regulator 2A
- VIN 5-18V
- VOUT 1-17V
- Switching frequency 340 kHz
- Conversion Efficiency 93%
- Maximum difference of 15V

## Main Simulation


## Slide 25

- Torque and Motors

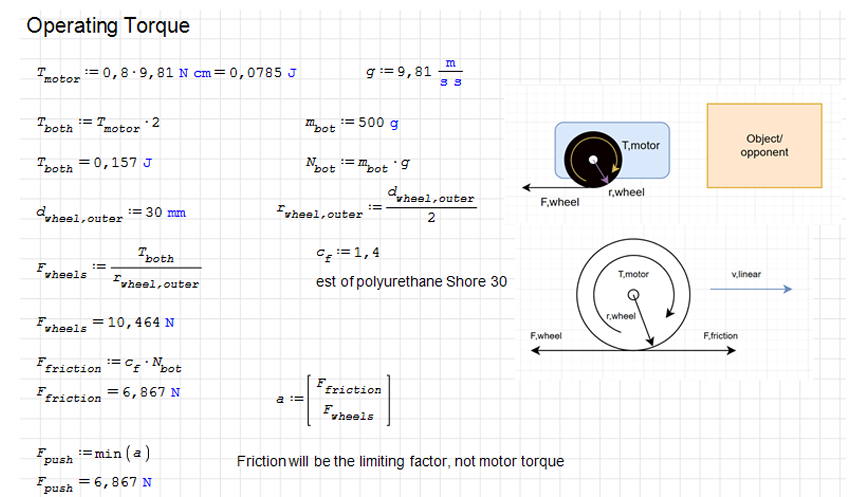
[picture p60: figure]
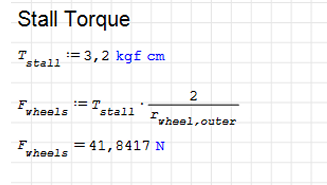
[picture p61: figure]
