chanelleblan/SumobotSkripsie/Planning/Budget_07_03.pdf

ITEM | Description | QTY | COST | TOTAL
ToF | Communica | 5 | R73.91 | R369.55
IR | Communica | 2 | R11.30 | R22.60
Interrupter modules | Microrobotics | 0 | R62.00 | R0.00
Shipping+VAT | | | R208.32 | R208.32
| | | Sub-total | R600.47
STM411 black pill | Microrobotics | 1 | R158.00 | R158.00
Shipping | In-person pickup
| | | Sub-total | R158.00
N20 DC motors | *Double check Yebo electronics | 4 | R200.00 | R800
DC motor driver | Max cost, usually cheaper | 2 | R200.00 | R400.00
3S LiPo battery | Max cost, usually cheaper | 1 | R600.00 | R600.00
Shipping | | | R200.00 | R200.00
| | | Sub-total | R2 000.00
Prototyping board | In person pick-up | R200 | R200
DIP switch | In person pick-up | R10 | R10
3D printing frame parts | | R600 | R600
Power switch | | R10 | R10
Wheels | Home-made wheels (conservative est) | R200 | R200
Passive components | | R200 | R200
| | Sub-total | R1 220.00
TOTAL | | | R3 978.47
After | R1 021.53

Sensors

Microcontroller

Power system

Misc
