chanelleblan/SumobotSkripsie/Planning/calcs.pdf

s s

m

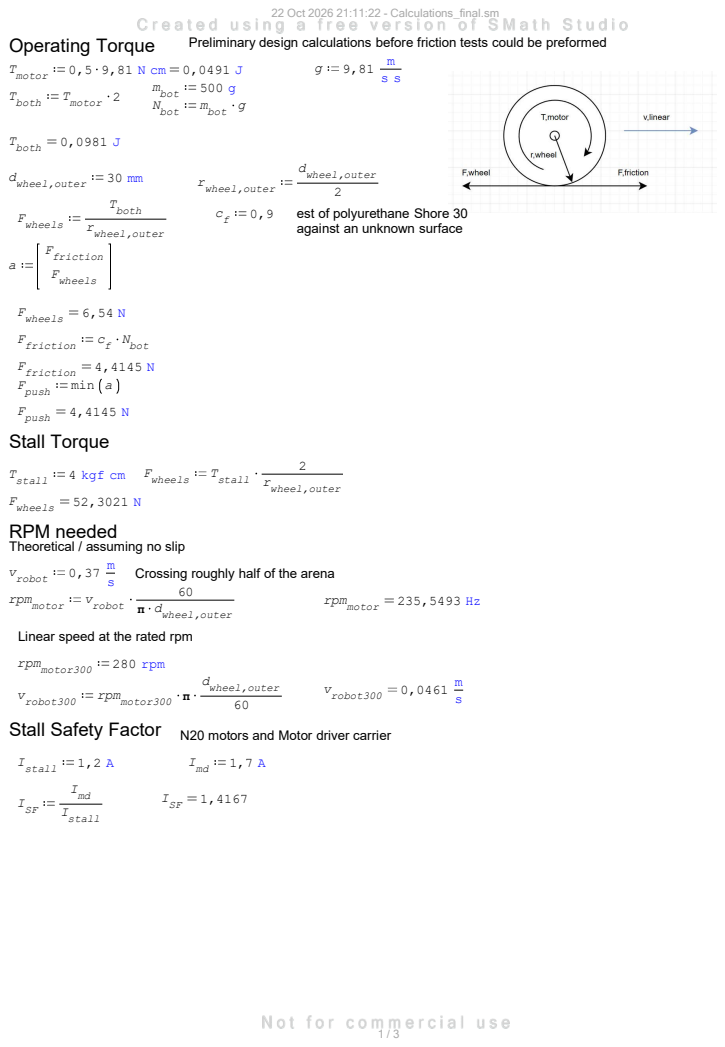
[picture p116: page 1]
Operating Torque; Preliminary design calculations before friction tests could be preformed; 9,81 motor; 500 g bot T; 2 motor T; both; bot N bot; T 0,0981 J both; d wheel,outer; rwheel,outer; 30 mm wheel,outer; T both; Fwheels; est of polyurethane Shore 30; F wheels; F friction; F 6,54 N wheels; bot c f; F friction F 4,4145 N friction F min a push F 4,4145 N push Stall Torque; r wheel,outer; Tstall Fwheels T; 4 kgf cm stall; 0,37 robot; Crossing roughly half of the arena; d wheel,outer π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

against an unknown surface

F 52,3021 N wheels
RPM needed
Theoretical / assuming no slip

Linear speed at the rated rpm

Stall Safety Factor N20 motors and Motor driver carrier

# Battery Voltage

### V 12,6 V max

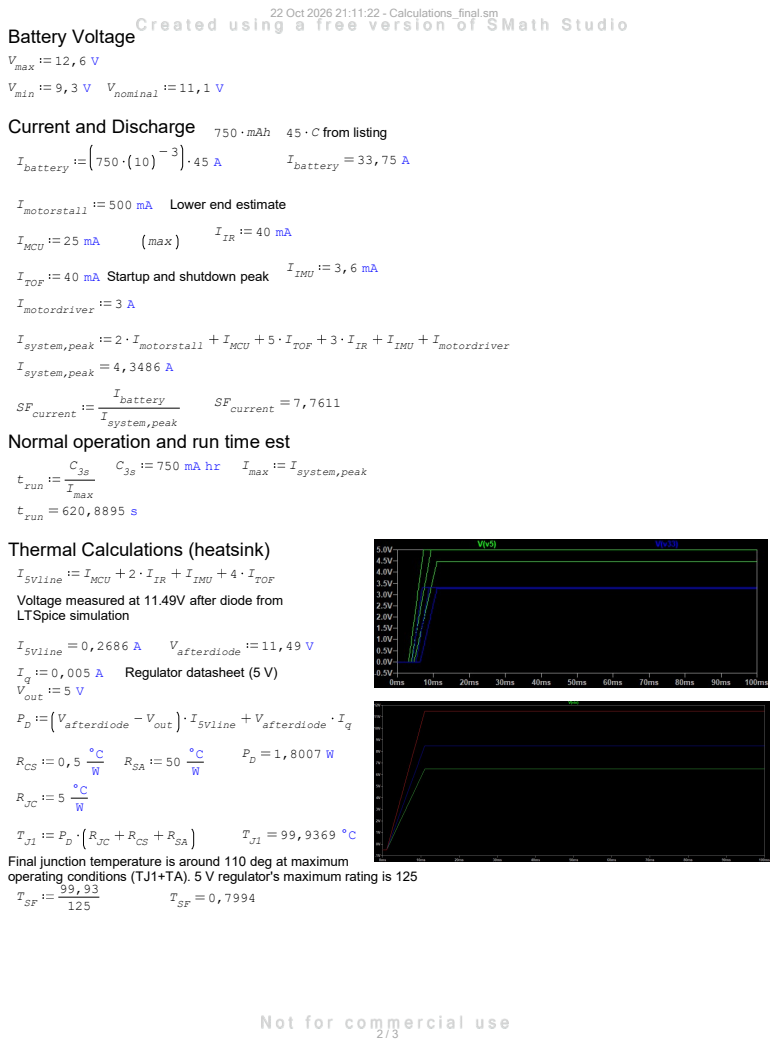
[picture p117: page 2]
9,3 V min; 11,1 V nominal; I 750 10 battery; I 33,75 A battery; 500 mA motorstall; Lower end estimate; 25 mA MCU; max; 3,6 mA IMU I; 40 mA TOF; Startup and shutdown peak; I 3 A motordriver; motordriver I; IMU I; 3 TOF I; 5 MCU I; motorstall I; 2 system,peak; I 4,3486 A system,peak; Isystem,peak; I battery; 7,7611 current; Imax; trun; system,peak I max; 620,8895 s run; TOF I; 4 IMU I; 2 MCU I; 0,2686 A 5Vline; 11,49 V afterdiode; Regulator datasheet (5 V); V 5 V out; afterdiode I; 5Vline V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

Current and Discharge 750 mAh 45 C from listing

SFcurrent
Normal operation and run time est

Thermal Calculations (heatsink)

5Vline
Voltage measured at 11.49V after diode from
LTSpice simulation

Final junction temperature is around 110 deg at maximum
operating conditions (TJ1+TA). 5 V regulator's maximum rating is 125

# Real friction coefficient

θ | 15 deg sebs

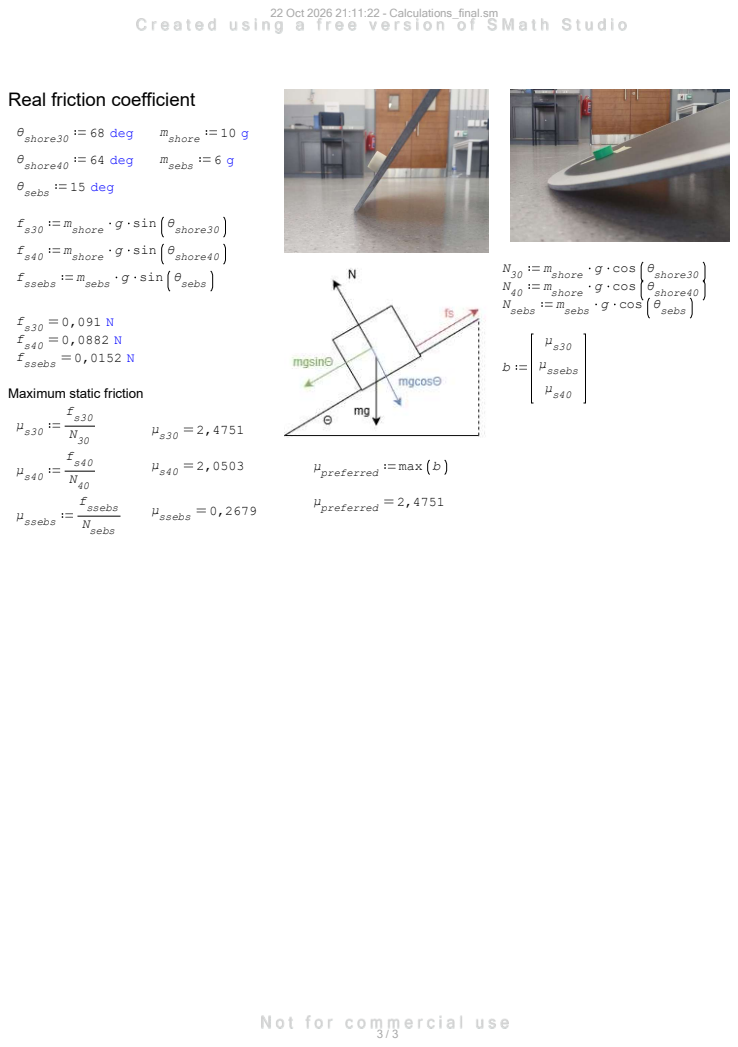
[picture p118: page 3]
68 deg shore30; 10 g shore; 64 deg shore40; 6 g sebs; sin θ; shore30 m; shore f s30; shore40 m; shore f s40; cos θ; shore N; sebs m; sebs f; ssebs; shore N 40; sebs N sebs; μ ssebs; 0,0152 N ssebs; max b; preferred; Nsebs; f ssebs; μssebs; 2,4751 preferred μ; 0,2679 ssebs

Maximum static friction
