chanelleblan/SumobotSkripsie/Minutes/Chanelle_AGENDA 21 SEP.docx

21 September Agenda – Chanelle

- Sal punt nommer 1 reflective tape insluit? Van wat ek kon vind word dit as ‘n vorm van jamming gesien in mederheid van die ander sumo kompetisies.
- Hoe ver moet ons wees vir die draft report? Is dit reg as daar ‘n paar onvolledige afdelings is/ net ‘n rowwe opsomming van wat daar bespreek sal word.
