chanelleblan/SumobotSkripsie/Minutes/Chanelle_AGENDA 3 AUG.docx

3 August Agenda – Chanelle Blanchè

- Figured it out, ignore the question that was here
