chanelleblan/SumobotSkripsie/Minutes/Chanelle_AGENDA 3 MAR.pdf

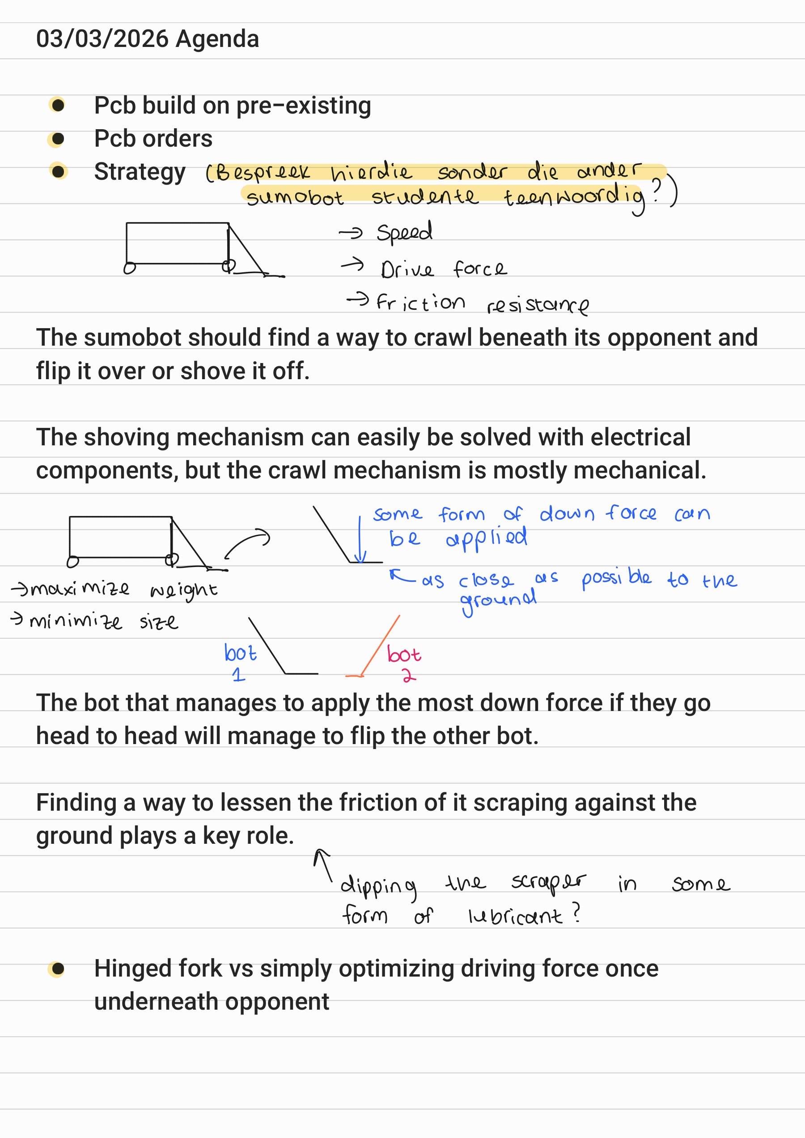
[picture p119: page 1]
