chanelleblan/SumobotSkripsie/Diagrams/4-wheel drive.png

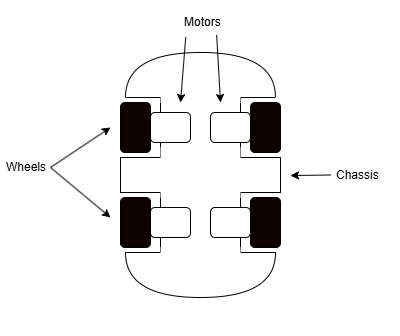
Diagrams/4-wheel drive.png
