chanelleblan/SumobotSkripsie/Diagrams/Architec.png

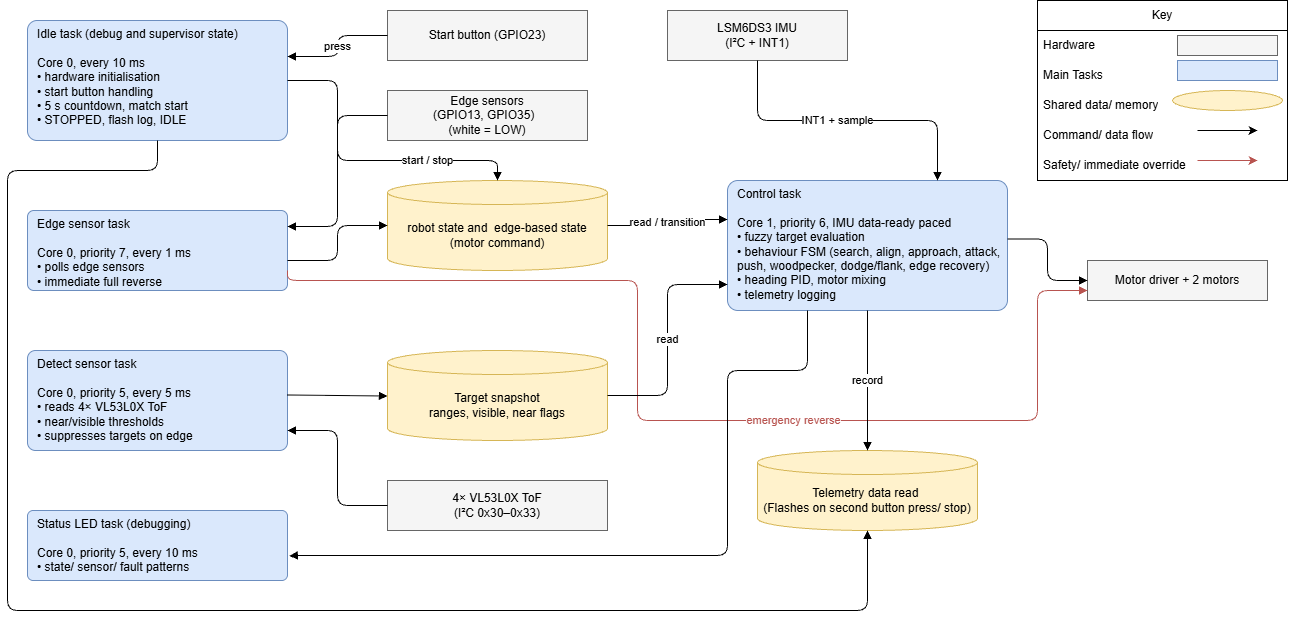
Diagrams/Architec.png
