chanelleblan/SumobotSkripsie/Diagrams/Fuzzylogic.drawio.png

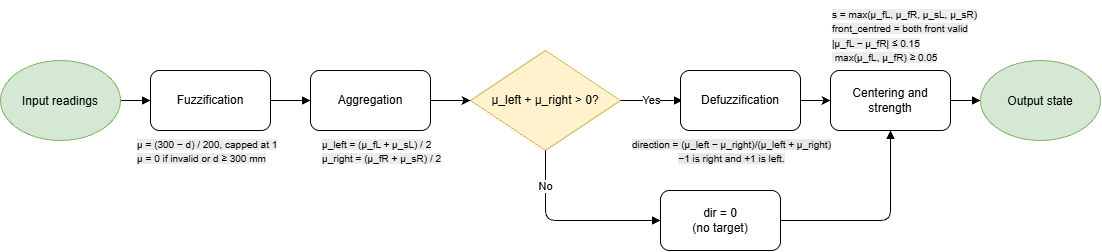
Diagrams/Fuzzylogic.drawio.png
