chanelleblan/SumobotSkripsie/Diagrams/Init.png

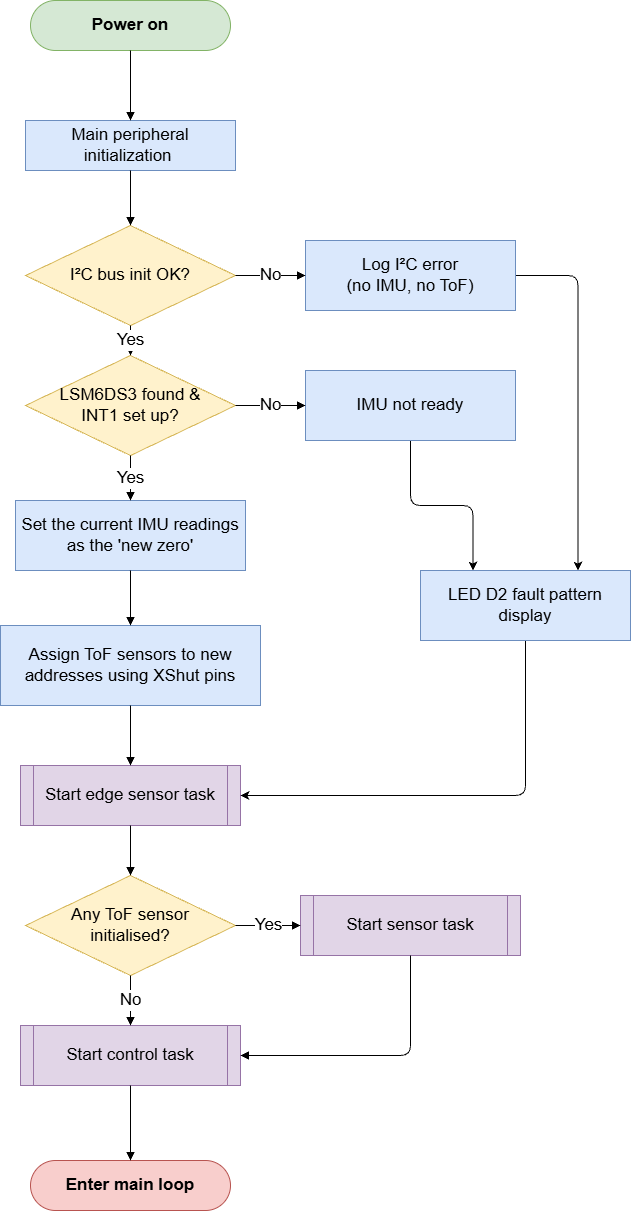
Diagrams/Init.png
