chanelleblan/SumobotSkripsie/Diagrams/Init_less space.png

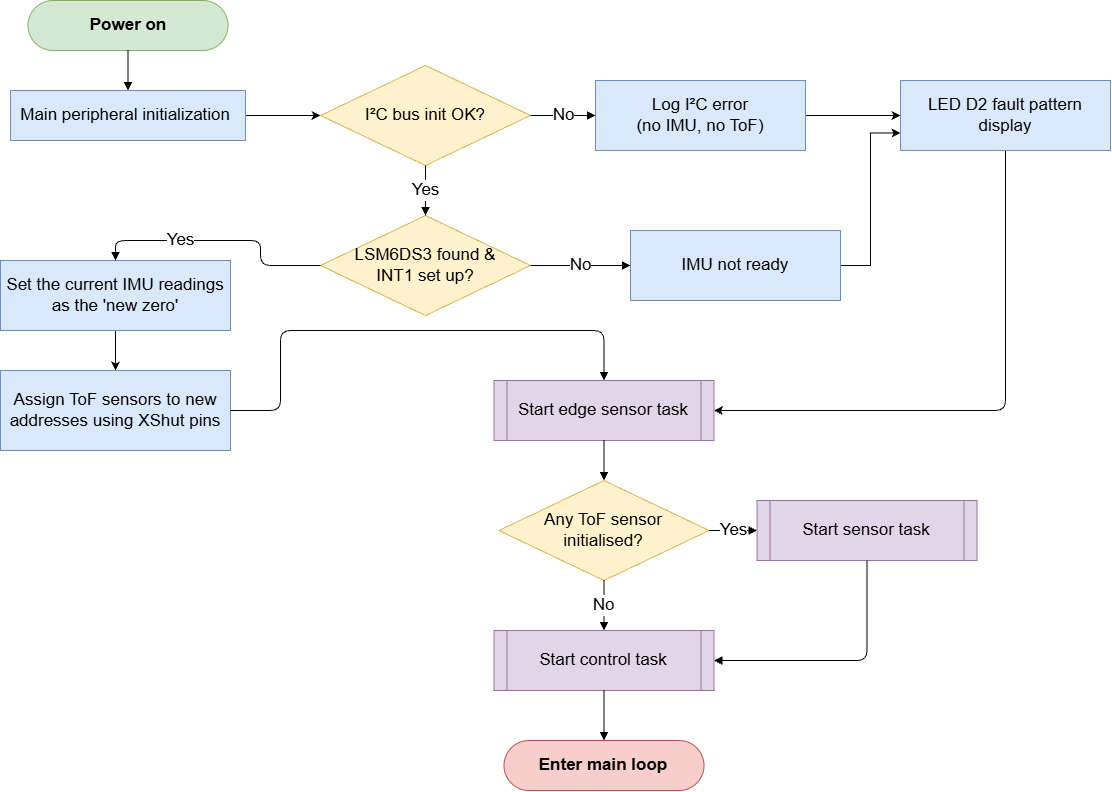
Diagrams/Init_less space.png
