chanelleblan/SumobotSkripsie/Planning/Skripsie_overview.png

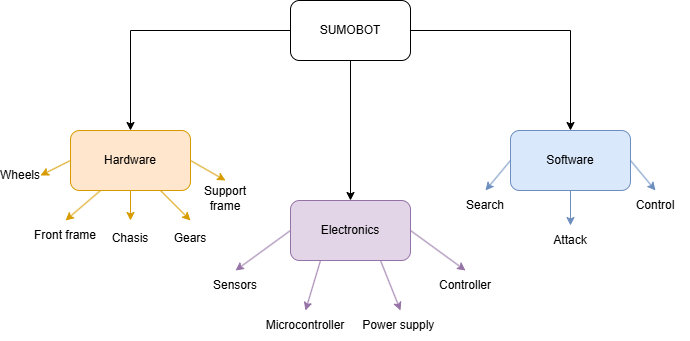
Planning/Skripsie_overview.png
