chanelleblan/SumobotSkripsie/Wheel moulding/WhatsApp Image 2026-10-22 at 21.15.32.jpeg

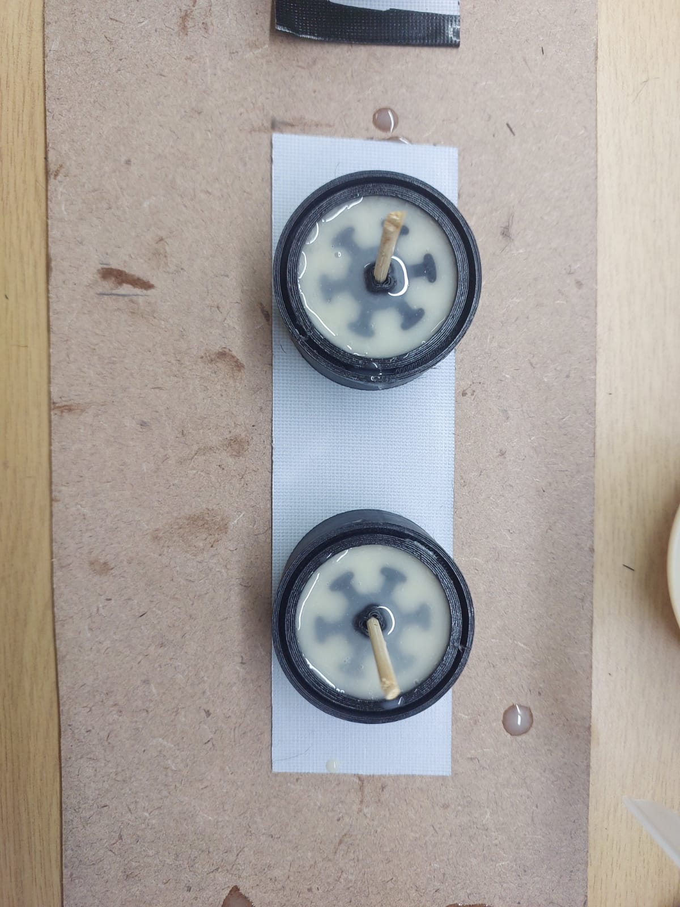
Wheel moulding/WhatsApp Image 2026-10-22 at 21.15.32.jpeg
