chanelleblan/SumobotSkripsie/Wheel moulding/WhatsApp Image 2026-11-06 at 16.44.52.jpeg

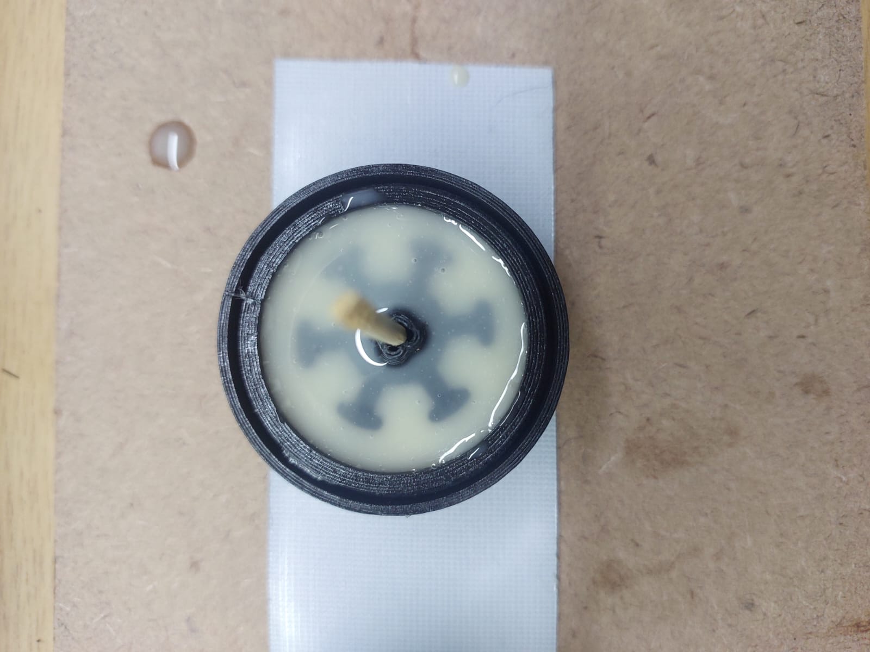
Wheel moulding/WhatsApp Image 2026-11-06 at 16.44.52.jpeg
