chanelleblan/SumobotSkripsie/Drawing Pack/Drawing Tree.xlsx

Sheet: Drawing Tree
Mini Sumobot (Jeremy) S91-00-00 | Drive-train | Motor brackets S91-01-01 | TRUE
 | S91-01-00 | Wheel rim S91-01-02 | TRUE | FALSE
 |  | Wheel mold S91-01-03 | TRUE
 | Chassis | Battery bracket S91-02-01 | TRUE | FALSE
 | S91-02-00 | Weight lid S91-02-02 | TRUE
 |  | Center support S91-02-03 | TRUE
 |  | Edge sensor mounts S91-02-04 | TRUE
 | Cover | Side panel left S91-03-01 | TRUE | FALSE
 |  | Side panel right S91-03-02 | TRUE
 | S91-03-00 | Wedge S91-03-03 | TRUE
 | Electronics | Electronics layer mount S91-04-01 | TRUE | FALSE
 | S91-04-00 | LSM mount S91-04-02 | TRUE

Sheet: Printing cost
Parts list |  |  |  |  | Filament cost/m
Part | QTY | Filament [m] | Filament total [m] | Actual: | R 1.50
Motor bracket | 2 | 0.6 | 1.2 | University Rate | R 15
Wheel rim | 2 | 2 | 4
Wheel Mold | 2 | 3 | 6
Battery bracket | 1 | 16 | 16
Weight lid | 1 | 0.5 | 0.5
Center support | 2 | 1.2 | 2.4
Edge sensor mounts | 2 | 0.8 | 1.6
Side panel | 2 | 14 | 28
Wedge | 1 | 20 | 20
Electronics layer mount | 1 | 9 | 9
LSM mount | 1 | 5.2 | 5.2
 |  | Total | 93.9
Total printing price(actual): | R 140.85
Total printing price(university): | R 1408.50
