chanelleblan/SumobotSkripsie/Planning/Proj plan_V4.xlsx

Sheet: Gannt
Activity | Feb 20206 | Mar 2026 | Apr 2026 | May 2026 | Jun 2026 | Jul 2026 | Aug 2026 | Sep 20206 | Oct 2026
Review Literature
Identify Compatible Design Approaches
Compile Design Requirements
Investigate Concepts for the Robot System
Simulate the Most Promising Concepts
Select Preferred Concept
Design Review
Design Prototype System
Manufacture Prototype
Test Prototype
Improve Prototype and Validate System Performance
Finalise Report
Activity | Feb 2026 | Mar 2026 | Apr 2026 | May 2026 | Jun 2026 | Jul 2026 | Aug 2026 | Sep 2026 | Oct 2026
Review Literature
Identify Compatible Design Approaches
Compile Design Requirements
Investigate Concepts for the Robot System
Select Preferred Concept
Design Review
Simulate Components of Interest
Finalize Prototype System Design
Manufacture Prototype
Test Prototype
Improve Prototype and Validate System Performance
Finalise Report
Activity | Feb 2026 | Mar 2026 | Apr 2026 | May 2026 | Jun 2026 | Jul 2026 | Aug 2026 | Sep 2026 | Oct 2026
Review Literature
Identify Compatible Design Approaches
Compile Design Requirements |  |  |  |  |  |  |  |  |  | Done
Investigate Concepts for the Robot System |  |  |  |  |  |  |  |  |  | Busy
Select Preferred Concept |  |  |  |  |  |  |  |  |  | To do
Design Review
Simulate Components of Interest
Finalize Prototype System Design
Manufacture Prototype
Test Prototype
Improve Prototype and Validate System Performance
Finalise Report
Demonstrate/Presentation and hand-in

Sheet: Component cost tracker
ITEM | Description | QTY | COST | TOTAL | Found supplier | Email sent | Procured | Received
Sensors
ToF | Communica | 5 | R 73.91 | R 369.55 | TRUE | TRUE | TRUE | TRUE
IR | Communica | 2 | R 50.00 | R 100.00 | TRUE | TRUE | TRUE | TRUE
LSM6 | Microrobotics | 1 | R 86.00 | R 86.00 | TRUE | TRUE | TRUE | TRUE
Shipping+VAT |  |  | R 208.32 | R 208.32
 |  |  | Sub-total | R 763.87
Microcontroller
STM411 black pill | Microrobotics | 3 | R 158.00 | R 474.00 | TRUE | TRUE | TRUE | TRUE
ESP32 |  | 1 | R 99.00 | R 99.00 | FALSE | FALSE | FALSE | FALSE
Shipping | In-person pickup
 |  |  | Sub-total | R 573.00
Power system
DC motor | In person pick-up | 2 | R 35.00 | R 70 | TRUE | TRUE | TRUE | TRUE
DC motor driver | Microrobotics | 1 | R 206.00 | R 206.00 | TRUE | TRUE | TRUE | TRUE
11.1V LiPo battery | Shipping incl | 1 | R 619.00 | R 619.00 | TRUE | TRUE | TRUE | TRUE | https://goblinhobbies.co.za/s1-lipo-battery-7-4v-300mah-60c-gt030039.html
Shipping |  |  | R 0.00 | R 0.00
 |  |  | Sub-total | R 895.00
Misc
Prototyping board | In person pick-up |  | R 200 | R 200 | TRUE | TRUE | TRUE | TRUE
DIP switch | In person pick-up |  | R 10 | R 10 | TRUE | TRUE | TRUE | TRUE
3D printing frame parts |  |  | R 150 | R 150 | TRUE | TRUE | TRUE | TRUE
Power switch |  |  | R 10 | R 10 | TRUE | TRUE | TRUE | TRUE
Vytaflex 30 |  |  | R 484.15 | R 484.15 | FALSE | FALSE | FALSE | FALSE
Vytaflex 40 | Wheels (Inc shipping) |  | R 484.15 | R 484.15 | TRUE | TRUE | TRUE | TRUE
Passive components |  |  | R 400 | R 400 | TRUE | TRUE | TRUE | TRUE
 |  |  | Sub-total | R 1738.30
TOTAL |  |  |  | R 3970.17
After | R 2029.83

Sheet: Cost
Activity | Engineering Time |  | Running Costs | Facility Use | Capital Costs | MMW |  | MMW | TOTAL
 |  |  |  |  |  | Labour |  | Material
 | hr | R | R | R | R | hr | R | R | R
Review Literature | 25 | 12500 |  |  |  |  |  |  | 12500
Identify Compatible Design Approaches | 30 | 15000 |  |  |  |  |  |  | 15000
Compile Design Requirements | 20 | 10000 |  |  |  |  |  |  | 10000
Investigate Concepts for the Robot System | 80 | 40000 | 250 |  |  |  |  |  | 40250
Simulate the Most Promising Concepts | 70 | 35000 | 500 |  |  |  |  |  | 35500
Select Preferred Concept | 10 | 5000 |  |  |  |  |  |  | 5000
Design Review | 5 | 2500 |  |  |  |  |  |  | 2500
Design Prototype System | 80 | 40000 | 500 |  |  |  |  |  | 40500
Manufacture Prototype | 20 | 10000 | 1000 |  |  | 25 | 7500 | 500 | 19000
Test Prototype | 30 | 15000 | 200 | 200 | 500 | 10 | 3000 |  | 18900
Improve Prototype and Validate System Performance | 50 | 25000 | 1000 | 200 |  |  |  |  | 26200
Finalise Report | 100 | 50000 | 50 |  |  |  |  |  | 50050
TOTAL | 520 | 260000 | 3500 | 400 | 500 | 35 | 10500 | 500 | 275400
Activity | Engineering Time |  | Running Costs | Facility Use | Capital Costs | MMW |  | MMW | TOTAL
 |  |  |  |  |  | Labour |  | Material
 | hr | R | R | R | R | hr | R | R | R
Review Literature | 25 | 0 |  |  |  |  |  |  | 0
Identify Compatible Design Approaches | 30 | 0 |  |  |  |  |  |  | 0
Compile Design Requirements | 20 | 0 |  |  |  |  |  |  | 0
Investigate Concepts for the Robot System | 80 | 0 | 0 |  |  |  |  |  | 0
Simulate the Most Promising Concepts | 70 | 0 | 100 |  |  |  |  |  | 100
Select Preferred Concept | 10 | 0 |  |  |  |  |  |  | 0
Design Review | 5 | 0 |  |  |  |  |  |  | 0
Design Prototype System | 80 | 0 | 250 |  |  |  |  |  | 250
Manufacture Prototype | 20 | 0 | 500 |  |  | 2 | 500 | 500 | 1500
Test Prototype | 30 | 0 | 200 | 200 | 500 | 0 | 0 |  | 900
Improve Prototype and Validate System Performance | 50 | 0 | 250 | 200 |  |  |  |  | 450
Finalise Report | 100 | 0 | 50 |  |  |  |  |  | 50
TOTAL | 520 | 0 | 1350 | 400 | 500 | 2 | 500 | 500 | 3250
