chanelleblan/SumobotSkripsie/Technical_Drawings/Drawings/2x_van_hierdie_rims.stl

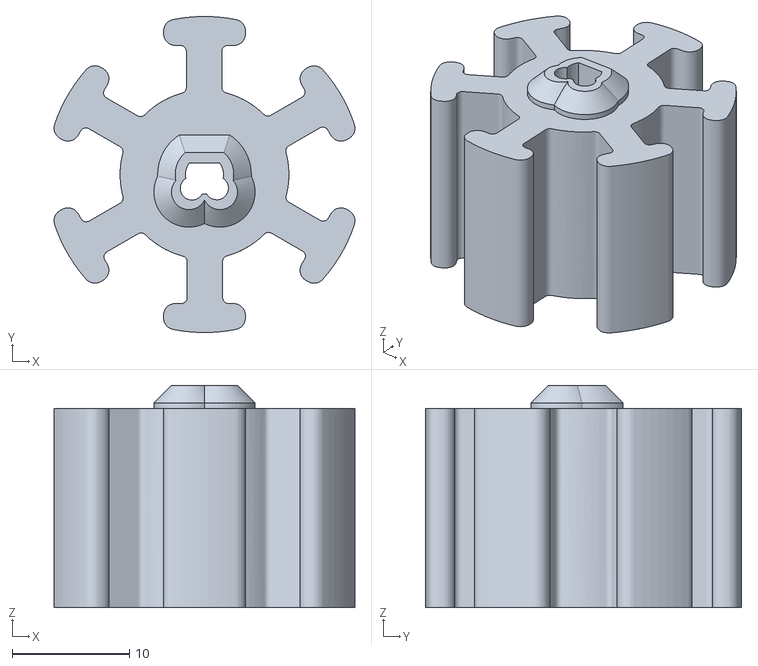
[picture p130: CAD file, 2026-10-27]
Technical_Drawings/Drawings/2x_van_hierdie_rims.stl
25.7 x 27.0 x 19.0
