chanelleblan/SumobotSkripsie/(list of files, cad)

Other CAD files:
Drawing Pack/Drawings/Battery_bracket.ipt
Drawing Pack/Drawings/Center_support.ipt
Drawing Pack/Drawings/Center_support_S91-02-03.idw
Drawing Pack/Drawings/Edge_sensor_bracket.ipt
Drawing Pack/Drawings/Edge_sensor_mount_S91-02-04.idw
Drawing Pack/Drawings/Electronics_layer_mount_S91-04-01.idw
Drawing Pack/Drawings/Electronics_layer_mount_S91-04-01_v2.idw
Drawing Pack/Drawings/Motor_bracket_S91-01-01.idw
Drawing Pack/Drawings/Side_panel.ipt
Drawing Pack/Drawings/Side_panel_left_S91-03-01.idw
Drawing Pack/Drawings/Side_panel_right_S91-03-02.idw
Drawing Pack/Drawings/Template.idw
Drawing Pack/Drawings/Wheel_mold_S91-01-03.idw
Drawing Pack/Drawings/Wheel_rim.ipt
Drawing Pack/Drawings/Wheel_rim_S91-01-02.idw
Drawing Pack/OldVersions/Template.0001.idw
Drawing Pack/OldVersions/Wedge.0001.ipt
Technical_Drawings/Drawings/Battery_bracket_S91-02-01.idw
Technical_Drawings/Drawings/Bennie.ipt
Technical_Drawings/Drawings/Electronics_layer_mount.ipt
Technical_Drawings/Drawings/LSM_sensor_mount_S91-04-02.idw
Technical_Drawings/Drawings/Motor_bracket.ipt
Technical_Drawings/Drawings/Side_panel_left.ipt
Technical_Drawings/Drawings/Wedge.ipt
Technical_Drawings/Drawings/Wedge_S91-03-04.idw
Technical_Drawings/Drawings/Weight_lid)S92-02-02.idw
Technical_Drawings/Drawings/Weight_lid.ipt
Technical_Drawings/Drawings/Wheel_mold.ipt
