chanelleblan/SumobotSkripsie/Tests/Final built system layout/Wiring_inside_side_panel_2.jpeg

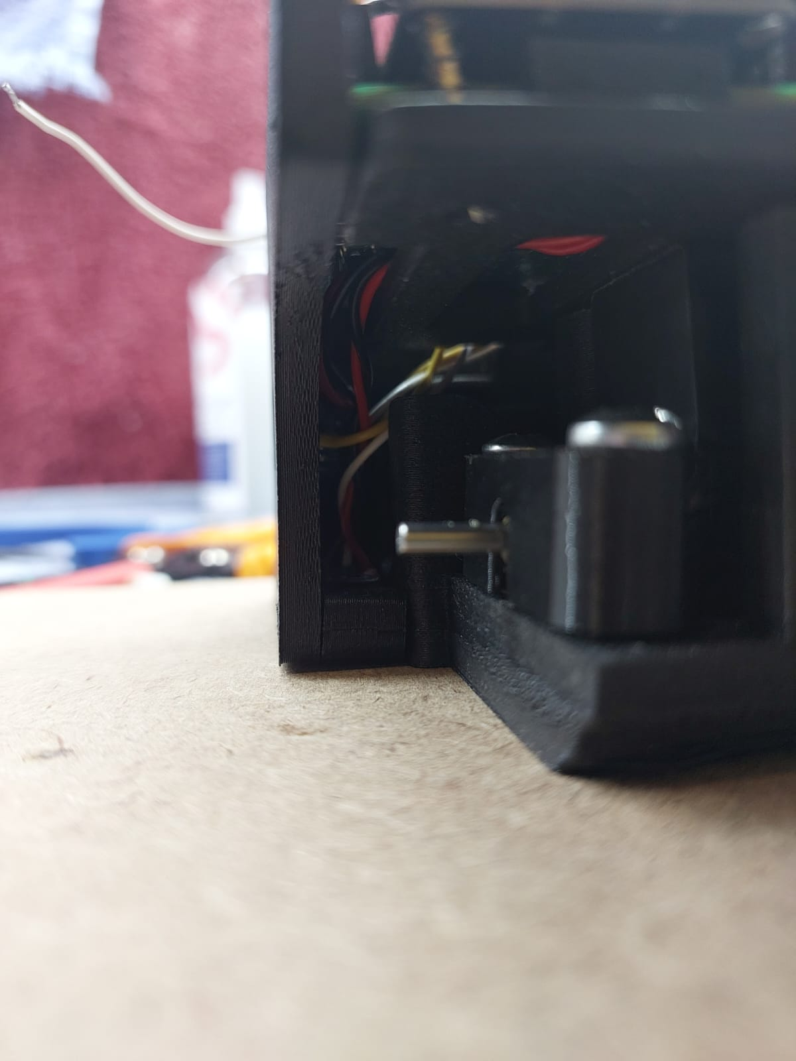
Tests/Final built system layout/Wiring_inside_side_panel_2.jpeg
