chanelleblan/SumobotSkripsie/Tests/Edge detection test/Edge_test.xlsx

Run | No brake | 100 DC | 200 DC | 255 DC
1 | 133 | 70 | 60 | 29
2 | 156 | 72 | 56 | 25
3 | 137 | 69 | 55 | 20
AVG [mm] | 142 | 70.33333333 | 57 | 24.66666667
