chanelleblan/SumobotSkripsie/Tests/Friction/Friciton_test.xlsx

Run 1 |  | Run 2 |  | Run 3 |  | Run 4 |  | Run 5
Material | Slip [deg] | Material | Slip [deg] | Material | Slip [deg] | Material | Slip [deg] | Material | Slip [deg]
Shore 30 | 90 | Shore 30 | 92 | Shore 30 | 90 | Shore 30 | 90 | Shore 30 | 90
Shore 40 | 80 | Shore 40 | 80 | Shore 40 | 82 | Shore 40 | 80 | Shore 40 | 80
Plastic | 45 | Plastic | 30 | Plastic | 45 | Plastic | 45 | Plastic | 40
Avg |  | Mode
Material | Slip [deg] | Material | Slip [deg]
Shore 30 | 90.4 | Shore 30 | 90
Shore 40 | 80.4 | Shore 40 | 80
Plastic | 41 | Plastic | 45
