chanelleblan/SumobotSkripsie/Tests/Speed and startup test/Max_speed_test.xlsx

Run | Distance (m) | Time (s) | Speed (m/s)
1 | 0.67 | 1.54
2 | 0.67 | 1.68
3 | 0.67 | 1.72
4 | 0.67 | 1.66
5 | 0.67 | 1.72
Mean
