chanelleblan/SumobotSkripsie/Tests/PID tests/PID_Run01_Kp0_Ki0_Kd0.xlsx

Sheet: Data
sample | time_s | desired_heading_deg | actual_heading_deg | error_deg | P | I | D | PID_sum | motor_A_duty | motor_B_duty | forward_accel_g | contact
0 | 0 | 0 | 0 | 0 | 0 | 0 | 0 | 0 | 200 | -200 | 0 | 0
1 | 0.012 | 0 | 0 | 0 | 0 | 0 | 0 | 0 | 200 | -200 | -0.011 | 1
2 | 0.024 | 0 | 0 | 0 | 0 | 0 | 0 | 0 | 200 | -200 | 0.078 | 1
3 | 0.036 | 0 | 0.2 | -0.2 | 0 | 0 | 0 | 0 | 200 | -200 | -0.026 | 1
4 | 0.048 | 0 | 0.3 | -0.3 | 0 | 0 | 0 | 0 | 200 | -200 | 0.045 | 0
5 | 0.06 | 0 | 1.8 | -1.8 | 0 | 0 | 0 | 0 | 200 | -200 | -0.008 | 0
6 | 0.072 | 0 | 5.2 | -5.2 | 0 | 0 | 0 | 0 | 200 | -200 | 0.098 | 0
7 | 0.084 | 0 | 8.4 | -8.4 | 0 | 0 | 0 | 0 | 200 | -200 | 0.187 | 0
8 | 0.096 | 0 | 10 | -10 | 0 | 0 | 0 | 0 | 200 | -200 | -0.094 | 0
9 | 0.108 | 0 | 9.9 | -9.9 | 0 | 0 | 0 | 0 | 200 | -200 | 0.196 | 0
10 | 0.12 | 0 | 9.6 | -9.6 | 0 | 0 | 0 | 0 | 200 | -200 | 0.07 | 0
11 | 0.132 | 0 | 9.1 | -9.1 | 0 | 0 | 0 | 0 | 200 | -200 | -0.028 | 0
12 | 0.144 | 0 | 8.6 | -8.6 | 0 | 0 | 0 | 0 | 200 | -200 | 0.134 | 0
13 | 0.156 | 0 | 8 | -8 | 0 | 0 | 0 | 0 | 200 | -200 | 0.085 | 0
14 | 0.168 | 0 | 7.5 | -7.5 | 0 | 0 | 0 | 0 | 200 | -200 | 0.23 | 0
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
