chanelleblan/SumobotSkripsie/Tests/PID tests/PID_Run02_Kp1_Ki0_Kd0.xlsx

Sheet: Data
sample | time_s | desired_heading_deg | actual_heading_deg | error_deg | P | I | D | PID_sum | motor_A_duty | motor_B_duty | forward_accel_g | contact
0 | 0 | 0 | 0 | 0 | 0 | 0 | 0 | 0 | 200 | -200 | 0 | 0
1 | 0.009 | 0 | 0 | 0 | 0 | 0 | 0 | 0 | 200 | -200 | 0.198 | 0
2 | 0.018 | 0 | 0.1 | -0.1 | -0.1 | 0 | 0 | -0.1 | 200.1 | -199.9 | 0.003 | 0
3 | 0.028 | 0 | 0.1 | -0.1 | -0.1 | 0 | 0 | -0.1 | 200.1 | -199.9 | 0.056 | 0
4 | 0.037 | 0 | 0.2 | -0.2 | -0.2 | 0 | 0 | -0.2 | 200.2 | -199.8 | 0.184 | 0
5 | 0.046 | 0 | 0.2 | -0.2 | -0.2 | 0 | 0 | -0.2 | 200.2 | -199.8 | -0.028 | 0
6 | 0.055 | 0 | 0.2 | -0.2 | -0.2 | 0 | 0 | -0.2 | 200.2 | -199.8 | 0.036 | 0
7 | 0.065 | 0 | 0.2 | -0.2 | -0.2 | 0 | 0 | -0.2 | 200.2 | -199.8 | -0.31 | 0
8 | 0.074 | 0 | 0.3 | -0.3 | -0.3 | 0 | 0 | -0.3 | 200.3 | -199.7 | 0.051 | 0
9 | 0.083 | 0 | 0.3 | -0.3 | -0.3 | 0 | 0 | -0.3 | 200.3 | -199.7 | -0.086 | 0
10 | 0.092 | 0 | 0.4 | -0.4 | -0.4 | 0 | 0 | -0.4 | 200.4 | -199.6 | -0.203 | 0
11 | 0.101 | 0 | 0.3 | -0.3 | -0.3 | 0 | 0 | -0.3 | 200.3 | -199.7 | -0.053 | 0
12 | 0.111 | 0 | 0.4 | -0.4 | -0.4 | 0 | 0 | -0.4 | 200.4 | -199.6 | -0.09 | 0
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
