chanelleblan/SumobotSkripsie/Tests/PID tests/PID_Run03_Kp5_Ki0_Kd0.xlsx

Sheet: Data
sample | time_s | desired_heading_deg | actual_heading_deg | error_deg | P | I | D | PID_sum | motor_A_duty | motor_B_duty | forward_accel_g | contact
0 | 0 | 0 | 0 | 0 | 0 | 0 | 0 | 0 | 200 | -200 | 0 | 0
1 | 0.012 | 0 | -0.1 | 0.1 | 0.5 | 0 | 0 | 0.5 | 199.5 | -200.5 | -0.112 | 0
2 | 0.024 | 0 | -0.2 | 0.2 | 1 | 0 | 0 | 1 | 199 | -201 | -0.093 | 0
3 | 0.036 | 0 | -0.2 | 0.2 | 1 | 0 | 0 | 1 | 199 | -201 | 0.08 | 0
4 | 0.048 | 0 | -0.3 | 0.3 | 1.5 | 0 | 0 | 1.5 | 198.5 | -201.5 | 0.132 | 0
5 | 0.06 | 0 | -0.2 | 0.2 | 1 | 0 | 0 | 1 | 199 | -201 | 0.089 | 0
6 | 0.072 | 0 | 0 | 0 | 0 | 0 | 0 | 0 | 200 | -200 | -0.07 | 0
7 | 0.084 | 0 | 0.5 | -0.5 | -2.5 | 0 | 0 | -2.5 | 202.5 | -197.5 | -0.048 | 0
8 | 0.096 | 0 | 0.8 | -0.8 | -4 | 0 | 0 | -4 | 204 | -196 | 0.082 | 0
9 | 0.108 | 0 | 1 | -1 | -5 | 0 | 0 | -5 | 205 | -195 | 0.045 | 0
10 | 0.12 | 0 | 1.1 | -1.1 | -5.5 | 0 | 0 | -5.5 | 205.5 | -194.5 | -0.178 | 0
11 | 0.132 | 0 | 1.1 | -1.1 | -5.5 | 0 | 0 | -5.5 | 205.5 | -194.5 | -0.1 | 0
12 | 0.144 | 0 | 1 | -1 | -5 | 0 | 0 | -5 | 205 | -195 | 0.07 | 0
13 | 0.156 | 0 | 1 | -1 | -5 | 0 | 0 | -5 | 205 | -195 | 0.124 | 1
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
