chanelleblan/SumobotSkripsie/Tests/PID tests/PID_Run04_Kp10_Ki0_Kd0.xlsx

Sheet: Data
sample | time_s | desired_heading_deg | actual_heading_deg | error_deg | P | I | D | PID_sum | motor_A_duty | motor_B_duty | forward_accel_g | contact
0 | 0 | 0 | 0 | 0 | 0 | 0 | 0 | 0 | 200 | -200 | 0 | 0
1 | 0.012 | 0 | 0 | 0 | 0 | 0 | 0 | 0 | 200 | -200 | 0.04 | 0
2 | 0.024 | 0 | 0.1 | -0.1 | -1 | 0 | 0 | -1 | 201 | -199 | 0.039 | 0
3 | 0.036 | 0 | 0.1 | -0.1 | -1 | 0 | 0 | -1 | 201 | -199 | -0.131 | 1
4 | 0.048 | 0 | 0.2 | -0.2 | -2 | 0 | 0 | -2 | 202 | -198 | -0.149 | 1
5 | 0.06 | 0 | 0.2 | -0.2 | -2 | 0 | 0 | -2 | 202 | -198 | 0.098 | 0
6 | 0.072 | 0 | 0.3 | -0.3 | -3 | 0 | 0 | -3 | 203 | -197 | 0.084 | 0
7 | 0.084 | 0 | 0.2 | -0.2 | -2 | 0 | 0 | -2 | 202 | -198 | 0.112 | 0
8 | 0.096 | 0 | 0.3 | -0.3 | -3 | 0 | 0 | -3 | 203 | -197 | 0.245 | 0
9 | 0.108 | 0 | 0.3 | -0.3 | -3 | 0 | 0 | -3 | 203 | -197 | 0.329 | 0
10 | 0.12 | 0 | 0.3 | -0.3 | -3 | 0 | 0 | -3 | 203 | -197 | 0.153 | 0
11 | 0.132 | 0 | 0.4 | -0.4 | -4 | 0 | 0 | -4 | 204 | -196 | -0.035 | 0
12 | 0.144 | 0 | 0.4 | -0.4 | -4 | 0 | 0 | -4 | 204 | -196 | 0.016 | 0
13 | 0.156 | 0 | 0.4 | -0.4 | -4 | 0 | 0 | -4 | 204 | -196 | 0.218 | 0
14 | 0.168 | 0 | 0.3 | -0.3 | -3 | 0 | 0 | -3 | 203 | -197 | -0.041 | 0
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
