chanelleblan/SumobotSkripsie/Tests/PID tests/PID_Run05_Kp15_Ki0_Kd0.xlsx

Sheet: Data
sample | time_s | desired_heading_deg | actual_heading_deg | error_deg | P | I | D | PID_sum | motor_A_duty | motor_B_duty | forward_accel_g | contact
0 | 0 | 0 | 0 | 0 | 0 | 0 | 0 | 0 | 200 | -200 | 0 | 0
1 | 0.009 | 0 | 0 | 0 | 0 | 0 | 0 | 0 | 200 | -200 | 0.071 | 0
2 | 0.018 | 0 | 0 | 0 | 0 | 0 | 0 | 0 | 200 | -200 | -0.006 | 0
3 | 0.028 | 0 | 0.1 | -0.1 | -1.5 | 0 | 0 | -1.5 | 201.5 | -198.5 | -0.096 | 0
4 | 0.037 | 0 | 0.1 | -0.1 | -1.5 | 0 | 0 | -1.5 | 201.5 | -198.5 | 0.025 | 0
5 | 0.046 | 0 | 0.3 | -0.3 | -4.5 | 0 | 0 | -4.5 | 204.5 | -195.5 | 0.173 | 0
6 | 0.055 | 0 | 0.5 | -0.5 | -7.5 | 0 | 0 | -7.5 | 207.5 | -192.5 | -0.07 | 0
7 | 0.065 | 0 | 0.9 | -0.9 | -13.5 | 0 | 0 | -13.5 | 213.5 | -186.5 | -0.113 | 0
8 | 0.074 | 0 | 1.6 | -1.6 | -24 | 0 | 0 | -24 | 224 | -176 | -0.095 | 0
9 | 0.083 | 0 | 2.5 | -2.5 | -37.5 | 0 | 0 | -37.5 | 237.5 | -162.5 | 0.258 | 0
10 | 0.092 | 0 | 3.4 | -3.4 | -51 | 0 | 0 | -51 | 251 | -149 | 0.214 | 0
11 | 0.102 | 0 | 4.4 | -4.4 | -66 | 0 | 0 | -66 | 255 | -134 | 0.068 | 0
12 | 0.111 | 0 | 5.4 | -5.4 | -81 | 0 | 0 | -81 | 255 | -119 | 0.062 | 0
13 | 0.12 | 0 | 6.3 | -6.3 | -94.5 | 0 | 0 | -94.5 | 255 | -105.5 | -0.173 | 0
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
