chanelleblan/SumobotSkripsie/Tests/PID tests/PID_Run06_Kp20_Ki0_Kd0.xlsx

Sheet: Data
sample | time_s | desired_heading_deg | actual_heading_deg | error_deg | P | I | D | PID_sum | motor_A_duty | motor_B_duty | forward_accel_g | contact
0 | 0 | 0 | 0 | 0 | 0 | 0 | 0 | 0 | 200 | -200 | 0 | 0
1 | 0.012 | 0 | 0 | 0 | 0 | 0 | 0 | 0 | 200 | -200 | -0.039 | 0
2 | 0.024 | 0 | 0 | 0 | 0 | 0 | 0 | 0 | 200 | -200 | -0.154 | 0
3 | 0.036 | 0 | 0 | 0 | 0 | 0 | 0 | 0 | 200 | -200 | -0.173 | 1
4 | 0.048 | 0 | 0.1 | -0.1 | -2 | 0 | 0 | -2 | 202 | -198 | 0.111 | 1
5 | 0.06 | 0 | 0.2 | -0.2 | -4 | 0 | 0 | -4 | 204 | -196 | 0.104 | 1
6 | 0.072 | 0 | 0.3 | -0.3 | -6 | 0 | 0 | -6 | 206 | -194 | -0.111 | 0
7 | 0.084 | 0 | 0.4 | -0.4 | -8 | 0 | 0 | -8 | 208 | -192 | -0.004 | 0
8 | 0.096 | 0 | 0.6 | -0.6 | -12 | 0 | 0 | -12 | 212 | -188 | 0.049 | 0
9 | 0.108 | 0 | 0.7 | -0.7 | -14 | 0 | 0 | -14 | 214 | -186 | 0.047 | 0
10 | 0.12 | 0 | 0.7 | -0.7 | -14 | 0 | 0 | -14 | 214 | -186 | -0.011 | 0
11 | 0.132 | 0 | 0.7 | -0.7 | -14 | 0 | 0 | -14 | 214 | -186 | -0.088 | 0
12 | 0.144 | 0 | 0.5 | -0.5 | -10 | 0 | 0 | -10 | 210 | -190 | -0.002 | 0
13 | 0.156 | 0 | 0.2 | -0.2 | -4 | 0 | 0 | -4 | 204 | -196 | -0.1 | 0
14 | 0.168 | 0 | 0 | 0 | 0 | 0 | 0 | 0 | 200 | -200 | 0.051 | 0
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
