chanelleblan/SumobotSkripsie/Tests/PID tests/PID_Run07_Kp40_Ki0_Kd0.xlsx

Sheet: Data
sample | time_s | desired_heading_deg | actual_heading_deg | error_deg | P | I | D | PID_sum | motor_A_duty | motor_B_duty | forward_accel_g | contact
0 | 0 | 0 | 0 | 0 | 0 | 0 | 0 | 0 | 200 | -200 | 0 | 0
1 | 0.009 | 0 | 0 | 0 | 0 | 0 | 0 | 0 | 200 | -200 | 0 | 0
2 | 0.018 | 0 | 0.2 | -0.2 | -8 | 0 | 0 | -8 | 208 | -192 | 0.107 | 0
3 | 0.028 | 0 | 0.4 | -0.4 | -16 | 0 | 0 | -16 | 216 | -184 | -0.036 | 0
4 | 0.037 | 0 | 0.6 | -0.6 | -24 | 0 | 0 | -24 | 224 | -176 | 0.047 | 0
5 | 0.046 | 0 | 0.8 | -0.8 | -32 | 0 | 0 | -32 | 232 | -168 | 0.171 | 0
6 | 0.055 | 0 | 0.9 | -0.9 | -36 | 0 | 0 | -36 | 236 | -164 | 0.061 | 0
7 | 0.065 | 0 | 1.1 | -1.1 | -44 | 0 | 0 | -44 | 244 | -156 | 0.014 | 0
8 | 0.074 | 0 | 1 | -1 | -40 | 0 | 0 | -40 | 240 | -160 | -0.035 | 0
9 | 0.083 | 0 | 0.8 | -0.8 | -32 | 0 | 0 | -32 | 232 | -168 | 0.085 | 0
10 | 0.092 | 0 | 0.4 | -0.4 | -16 | 0 | 0 | -16 | 216 | -184 | 0.054 | 0
11 | 0.102 | 0 | -0.1 | 0.1 | 4 | 0 | 0 | 4 | 196 | -204 | -0.025 | 0
12 | 0.111 | 0 | -0.7 | 0.7 | 28 | 0 | 0 | 28 | 172 | -228 | -0.08 | 0
13 | 0.12 | 0 | -1.3 | 1.3 | 52 | 0 | 0 | 52 | 148 | -252 | -0.036 | 0
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
