chanelleblan/SumobotSkripsie/Tests/PID tests/PID_Run08_Kp16_Ki0_Kd0.xlsx

Sheet: Data
sample | time_s | desired_heading_deg | actual_heading_deg | error_deg | P | I | D | PID_sum | motor_A_duty | motor_B_duty | forward_accel_g | contact
0 | 0 | 0 | 0 | 0 | 0 | 0 | 0 | 0 | 200 | -200 | 0 | 0
1 | 0.009 | 0 | 0 | 0 | 0 | 0 | 0 | 0 | 200 | -200 | -0.088 | 0
2 | 0.018 | 0 | 0 | 0 | 0 | 0 | 0 | 0 | 200 | -200 | 0.029 | 0
3 | 0.028 | 0 | 0 | 0 | 0 | 0 | 0 | 0 | 200 | -200 | 0.178 | 0
4 | 0.037 | 0 | 0 | 0 | 0 | 0 | 0 | 0 | 200 | -200 | 0.33 | 0
5 | 0.046 | 0 | 0 | 0 | 0 | 0 | 0 | 0 | 200 | -200 | -0.31 | 0
6 | 0.055 | 0 | 0 | 0 | 0 | 0 | 0 | 0 | 200 | -200 | 0.295 | 0
7 | 0.065 | 0 | 0.4 | -0.4 | -6.4 | 0 | 0 | -6.4 | 206.4 | -193.6 | 0.25 | 0
8 | 0.074 | 0 | 0.9 | -0.9 | -14.4 | 0 | 0 | -14.4 | 214.4 | -185.6 | 0.182 | 0
9 | 0.083 | 0 | 1.7 | -1.7 | -27.2 | 0 | 0 | -27.2 | 227.2 | -172.8 | 0.216 | 0
10 | 0.092 | 0 | 2.5 | -2.5 | -40 | 0 | 0 | -40 | 240 | -160 | 0.246 | 0
11 | 0.101 | 0 | 3.6 | -3.6 | -57.6 | 0 | 0 | -57.6 | 255 | -142.4 | -0.067 | 0
12 | 0.111 | 0 | 4.6 | -4.6 | -73.6 | 0 | 0 | -73.6 | 255 | -126.4 | 0.145 | 0
13 | 0.12 | 0 | 5.6 | -5.6 | -89.6 | 0 | 0 | -89.6 | 255 | -110.4 | 0.098 | 0
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
