chanelleblan/SumobotSkripsie/Tests/PID tests/PID_Run09_Kp16_Ki0_Kd0.2.xlsx

Sheet: Data
sample | time_s | desired_heading_deg | actual_heading_deg | error_deg | P | I | D | PID_sum | motor_A_duty | motor_B_duty | forward_accel_g | contact
0 | 0 | 0 | 0 | 0 | 0 | 0 | 0 | 0 | 200 | -200 | 0 | 0
1 | 0.012 | 0 | 0 | 0 | 0 | 0 | 0 | 0 | 200 | -200 | 0.085 | 0
2 | 0.024 | 0 | 0.1 | -0.1 | -1.6 | 0 | -0.583 | -2.183 | 202.183 | -197.817 | 0.118 | 0
3 | 0.036 | 0 | 0 | 0 | 0 | 0 | 0.204 | 0.204 | 199.796 | -200.204 | 0.099 | 0
4 | 0.048 | 0 | 0 | 0 | 0 | 0 | 0.133 | 0.133 | 199.867 | -200.133 | -0.04 | 0
5 | 0.06 | 0 | 0 | 0 | 0 | 0 | 0.086 | 0.086 | 199.914 | -200.086 | -0.012 | 0
6 | 0.072 | 0 | 0 | 0 | 0 | 0 | 0.056 | 0.056 | 199.944 | -200.056 | -0.113 | 0
7 | 0.084 | 0 | 0 | 0 | 0 | 0 | 0.036 | 0.036 | 199.964 | -200.036 | -0.068 | 0
8 | 0.096 | 0 | 0 | 0 | 0 | 0 | 0.024 | 0.024 | 199.976 | -200.024 | -0.118 | 0
9 | 0.108 | 0 | 0.1 | -0.1 | -1.6 | 0 | -0.568 | -2.168 | 202.168 | -197.832 | 0.047 | 0
10 | 0.12 | 0 | 0.1 | -0.1 | -1.6 | 0 | -0.369 | -1.969 | 201.969 | -198.031 | 0.122 | 0
11 | 0.132 | 0 | 0.1 | -0.1 | -1.6 | 0 | -0.24 | -1.84 | 201.84 | -198.16 | 0.158 | 0
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
