chanelleblan/SumobotSkripsie/Tests/PID tests/PID_Run10_Kp16_Ki0_Kd0.3.xlsx

Sheet: Data
sample | time_s | desired_heading_deg | actual_heading_deg | error_deg | P | I | D | PID_sum | motor_A_duty | motor_B_duty | forward_accel_g | contact
0 | 0 | 0 | 0 | 0 | 0 | 0 | 0 | 0 | 200 | -200 | 0 | 0
1 | 0.012 | 0 | 0 | 0 | 0 | 0 | 0 | 0 | 200 | -200 | -0.02 | 0
2 | 0.024 | 0 | 0 | 0 | 0 | 0 | 0 | 0 | 200 | -200 | -0.072 | 0
3 | 0.036 | 0 | 0 | 0 | 0 | 0 | 0 | 0 | 200 | -200 | 0.061 | 0
4 | 0.048 | 0 | 0 | 0 | 0 | 0 | 0 | 0 | 200 | -200 | -0.063 | 0
5 | 0.06 | 0 | -0.6 | 0.6 | 9.6 | 0 | 5.247 | 14.847 | 185.153 | -214.847 | -0.059 | 0
6 | 0.072 | 0 | -2.2 | 2.2 | 35.2 | 0 | 17.402 | 52.602 | 147.398 | -252.602 | 0.039 | 0
7 | 0.084 | 0 | -4.1 | 4.1 | 65.6 | 0 | 27.926 | 93.526 | 106.474 | -255 | -0.003 | 0
8 | 0.096 | 0 | -5.4 | 5.4 | 86.4 | 0 | 29.52 | 115.92 | 84.08 | -255 | -0.132 | 0
9 | 0.108 | 0 | -5.5 | 5.5 | 88 | 0 | 20.063 | 108.063 | 91.937 | -255 | -0.123 | 0
10 | 0.12 | 0 | -5 | 5 | 80 | 0 | 8.668 | 88.668 | 111.332 | -255 | 0.015 | 0
11 | 0.132 | 0 | -4.3 | 4.3 | 68.8 | 0 | -0.487 | 68.313 | 131.687 | -255 | 0.011 | 0
12 | 0.144 | 0 | -3.4 | 3.4 | 54.4 | 0 | -8.187 | 46.213 | 153.787 | -246.213 | -0.141 | 0
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
