chanelleblan/SumobotSkripsie/Tests/PID tests/PID_Run11_Kp16_Ki0_Kd0.5.xlsx

Sheet: Data
sample | time_s | desired_heading_deg | actual_heading_deg | error_deg | P | I | D | PID_sum | motor_A_duty | motor_B_duty | forward_accel_g | contact
0 | 0 | 0 | 0 | 0 | 0 | 0 | 0 | 0 | 200 | -200 | 0 | 0
1 | 0.012 | 0 | 0.1 | -0.1 | -1.6 | 0 | -1.455 | -3.055 | 203.055 | -196.945 | -0.114 | 0
2 | 0.024 | 0 | 0.2 | -0.2 | -3.2 | 0 | -2.4 | -5.6 | 205.6 | -194.4 | 0.11 | 0
3 | 0.036 | 0 | 0.3 | -0.3 | -4.8 | 0 | -3.015 | -7.815 | 207.815 | -192.185 | -0.028 | 0
4 | 0.048 | 0 | 0.3 | -0.3 | -4.8 | 0 | -1.96 | -6.76 | 206.76 | -193.24 | 0.036 | 0
5 | 0.06 | 0 | 0.4 | -0.4 | -6.4 | 0 | -2.729 | -9.129 | 209.129 | -190.871 | -0.031 | 0
6 | 0.072 | 0 | 0.5 | -0.5 | -8 | 0 | -3.228 | -11.228 | 211.228 | -188.772 | 0.029 | 0
7 | 0.084 | 0 | 0.7 | -0.7 | -11.2 | 0 | -5.008 | -16.208 | 216.208 | -183.792 | 0.086 | 1
8 | 0.096 | 0 | 0.7 | -0.7 | -11.2 | 0 | -3.255 | -14.455 | 214.455 | -185.545 | -0.006 | 1
9 | 0.108 | 0 | 0.8 | -0.8 | -12.8 | 0 | -3.571 | -16.371 | 216.371 | -183.629 | -0.071 | 1
10 | 0.12 | 0 | 0.8 | -0.8 | -12.8 | 0 | -2.321 | -15.121 | 215.121 | -184.879 | 0.042 | 1
11 | 0.132 | 0 | 0.9 | -0.9 | -14.4 | 0 | -2.963 | -17.363 | 217.363 | -182.637 | -0.007 | 1
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
