chanelleblan/SumobotSkripsie/Tests/PID tests/PID_Run12_Kp14_Ki0_Kd0.5.xlsx

Sheet: Data
sample | time_s | desired_heading_deg | actual_heading_deg | error_deg | P | I | D | PID_sum | motor_A_duty | motor_B_duty | forward_accel_g | contact
0 | 0 | 0 | 0 | 0 | 0 | 0 | 0 | 0 | 200 | -200 | 0 | 0
1 | 0.012 | 0 | 0 | 0 | 0 | 0 | 0 | 0 | 200 | -200 | 0.092 | 0
2 | 0.024 | 0 | 0 | 0 | 0 | 0 | 0 | 0 | 200 | -200 | 0.168 | 0
3 | 0.036 | 0 | 0 | 0 | 0 | 0 | 0 | 0 | 200 | -200 | 0.177 | 1
4 | 0.048 | 0 | 0 | 0 | 0 | 0 | 0 | 0 | 200 | -200 | -0.015 | 1
5 | 0.06 | 0 | 1.1 | -1.1 | -15.4 | 0 | -16.033 | -31.433 | 231.433 | -168.567 | 0.162 | 1
6 | 0.072 | 0 | 3.4 | -3.4 | -47.6 | 0 | -43.944 | -91.544 | 255 | -108.456 | 0.011 | 1
7 | 0.084 | 0 | 5.7 | -5.7 | -79.8 | 0 | -62.086 | -141.886 | 255 | -58.114 | 0.142 | 1
8 | 0.096 | 0 | 6.6 | -6.6 | -92.4 | 0 | -53.473 | -145.873 | 255 | -54.127 | 0.239 | 1
9 | 0.108 | 0 | 5.5 | -5.5 | -77 | 0 | -18.725 | -95.725 | 255 | -104.275 | 0.35 | 1
10 | 0.12 | 0 | 3.5 | -3.5 | -49 | 0 | 16.979 | -32.021 | 232.021 | -167.979 | 0.127 | 1
11 | 0.132 | 0 | 1.7 | -1.7 | -23.8 | 0 | 37.271 | 13.471 | 186.529 | -213.471 | -0.013 | 1
12 | 0.144 | 0 | 1 | -1 | -14 | 0 | 34.429 | 20.429 | 179.571 | -220.429 | -0.073 | 1
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
