chanelleblan/SumobotSkripsie/Tests/PID tests/PID_Run13_Kp10_Ki0_Kd0.5.xlsx

Sheet: Data
sample | time_s | desired_heading_deg | actual_heading_deg | error_deg | P | I | D | PID_sum | motor_A_duty | motor_B_duty | forward_accel_g | contact
0 | 0 | 0 | 0 | 0 | 0 | 0 | 0 | 0 | 200 | -200 | 0 | 0
1 | 0.012 | 0 | -0.4 | 0.4 | 4 | 0 | 5.838 | 9.838 | 190.162 | -209.838 | 0.011 | 0
2 | 0.024 | 0 | -0.9 | 0.9 | 9 | 0 | 11.093 | 20.093 | 179.907 | -220.093 | 0.107 | 0
3 | 0.036 | 0 | -1.3 | 1.3 | 13 | 0 | 13.049 | 26.049 | 173.951 | -226.049 | -0.009 | 0
4 | 0.048 | 0 | -1.5 | 1.5 | 15 | 0 | 11.401 | 26.401 | 173.599 | -226.401 | -0.189 | 0
5 | 0.06 | 0 | -1.3 | 1.3 | 13 | 0 | 4.491 | 17.491 | 182.509 | -217.491 | -0.088 | 0
6 | 0.072 | 0 | -0.9 | 0.9 | 9 | 0 | -2.919 | 6.081 | 193.919 | -206.081 | 0.07 | 0
7 | 0.084 | 0 | -0.4 | 0.4 | 4 | 0 | -9.195 | -5.195 | 205.195 | -194.805 | 0.054 | 0
8 | 0.096 | 0 | -0.1 | 0.1 | 1 | 0 | -10.356 | -9.356 | 209.356 | -190.644 | -0.176 | 0
9 | 0.108 | 0 | -0.2 | 0.2 | 2 | 0 | -5.272 | -3.272 | 203.272 | -196.728 | -0.072 | 0
10 | 0.12 | 0 | -0.5 | 0.5 | 5 | 0 | 0.952 | 5.952 | 194.048 | -205.952 | -0.222 | 0
11 | 0.132 | 0 | -1 | 1 | 10 | 0 | 7.917 | 17.917 | 182.083 | -217.917 | -0.039 | 0
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
