chanelleblan/SumobotSkripsie/Tests/PID tests/PID_Run14_Kp15_Ki0_Kd0.5.xlsx

Sheet: Data
sample | time_s | desired_heading_deg | actual_heading_deg | error_deg | P | I | D | PID_sum | motor_A_duty | motor_B_duty | forward_accel_g | contact
0 | 0 | 0 | 0 | 0 | 0 | 0 | 0 | 0 | 200 | -200 | 0 | 0
1 | 0.012 | 0 | 0 | 0 | 0 | 0 | 0 | 0 | 200 | -200 | 0.085 | 0
2 | 0.024 | 0 | 0 | 0 | 0 | 0 | 0 | 0 | 200 | -200 | 0.105 | 0
3 | 0.036 | 0 | 0 | 0 | 0 | 0 | 0 | 0 | 200 | -200 | -0.004 | 0
4 | 0.048 | 0 | 0 | 0 | 0 | 0 | 0 | 0 | 200 | -200 | -0.045 | 0
5 | 0.06 | 0 | -0.1 | 0.1 | 1.5 | 0 | 1.456 | 2.956 | 197.044 | -202.956 | -0.036 | 0
6 | 0.072 | 0 | -0.3 | 0.3 | 4.5 | 0 | 3.858 | 8.358 | 191.642 | -208.358 | 0.022 | 0
7 | 0.084 | 0 | -0.7 | 0.7 | 10.5 | 0 | 8.332 | 18.832 | 181.168 | -218.832 | 0.158 | 0
8 | 0.096 | 0 | -1 | 1 | 15 | 0 | 9.784 | 24.784 | 175.216 | -224.784 | 0.206 | 0
9 | 0.108 | 0 | -1.2 | 1.2 | 18 | 0 | 9.271 | 27.271 | 172.729 | -227.271 | 0.098 | 0
10 | 0.12 | 0 | -0.9 | 0.9 | 13.5 | 0 | 1.658 | 15.158 | 184.842 | -215.158 | 0.092 | 0
11 | 0.132 | 0 | -0.3 | 0.3 | 4.5 | 0 | -7.658 | -3.158 | 203.158 | -196.842 | -0.002 | 0
12 | 0.144 | 0 | 0.2 | -0.2 | -3 | 0 | -12.258 | -15.258 | 215.258 | -184.742 | 0.084 | 0
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
