chanelleblan/SumobotSkripsie/Tests/PID tests/PID_Run15_Kp15_Ki0_Kd0.6.xlsx

Sheet: Data
sample | time_s | desired_heading_deg | actual_heading_deg | error_deg | P | I | D | PID_sum | motor_A_duty | motor_B_duty | forward_accel_g | contact
0 | 0 | 0 | 0 | 0 | 0 | 0 | 0 | 0 | 200 | -200 | 0 | 0
1 | 0.012 | 0 | 0.1 | -0.1 | -1.5 | 0 | -1.747 | -3.247 | 203.247 | -196.753 | -0.208 | 0
2 | 0.024 | 0 | 0.2 | -0.2 | -3 | 0 | -2.882 | -5.882 | 205.882 | -194.118 | -0.001 | 0
3 | 0.036 | 0 | 0.4 | -0.4 | -6 | 0 | -5.368 | -11.368 | 211.368 | -188.632 | -0.193 | 0
4 | 0.048 | 0 | 0.6 | -0.6 | -9 | 0 | -6.983 | -15.983 | 215.983 | -184.017 | -0.077 | 0
5 | 0.06 | 0 | 0.7 | -0.7 | -10.5 | 0 | -6.286 | -16.786 | 216.786 | -183.214 | -0.285 | 0
6 | 0.072 | 0 | 0.8 | -0.8 | -12 | 0 | -5.833 | -17.833 | 217.833 | -182.167 | -0.191 | 0
7 | 0.084 | 0 | 1 | -1 | -15 | 0 | -7.285 | -22.285 | 222.285 | -177.715 | -0.043 | 0
8 | 0.096 | 0 | 1.1 | -1.1 | -16.5 | 0 | -6.482 | -22.982 | 222.982 | -177.018 | 0.197 | 0
9 | 0.108 | 0 | 1.2 | -1.2 | -18 | 0 | -5.96 | -23.96 | 223.96 | -176.04 | 0.063 | 0
10 | 0.12 | 0 | 1.2 | -1.2 | -18 | 0 | -3.874 | -21.874 | 221.874 | -178.126 | 0.036 | 0
11 | 0.132 | 0 | 1.3 | -1.3 | -19.5 | 0 | -4.265 | -23.765 | 223.765 | -176.235 | 0.116 | 0
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
