chanelleblan/SumobotSkripsie/Tests/Opponent detection range/Opponent_detection_test.xlsx

Duty cycle | Est Spin rate (LSM) | Opponent detected
100 | too slow | too slow
130 | 260 | Y
150 | 300 | Y
170 | 340 | Y
200 | 400 | N
250 | 500 | N
255 | 510 | N
Duty cycle | Est Spin rate (LSM) | Opponent detected
100 | too slow | too slow
130 | 260 | Y
150 | 300 | Y
170 | 340 | Y
200 | 400 | Y
250 | 500 | N
255 | 510 | N
Duty cycle | Est Spin rate (LSM) | Opponent detected
100 | too slow | too slow
130 | 260 | Y
150 | 300 | Y
170 | 340 | Y
200 | 400 | N
250 | 500 | N
255 | 510 | N
Duty cycle | Est Spin rate (LSM) | Opponent detected
100 | too slow | too slow
130 | 260 | Y
150 | 300 | Y
170 | 340 | Y
200 | 400 | N
250 | 500 | N
255 | 510 | N
Duty cycle | Est Spin rate (LSM) | Opponent detected
100 | too slow | too slow
130 | 260 | Y
150 | 300 | Y
170 | 340 | Y
200 | 400 | Y
250 | 500 | N
255 | 510 | N
Duty cycle | Est Spin rate (LSM) | Opponent detected | *wrong variable name, test faulty
100 | too slow | too slow
130 | 260 | N
150 | 300 | N
170 | 340 | N
200 | 400 | N
250 | 500 | N
255 | 510 | N
