chanelleblan/SumobotSkripsie/Tests/Edge detection test/255_duty_cycle_brake.jpeg

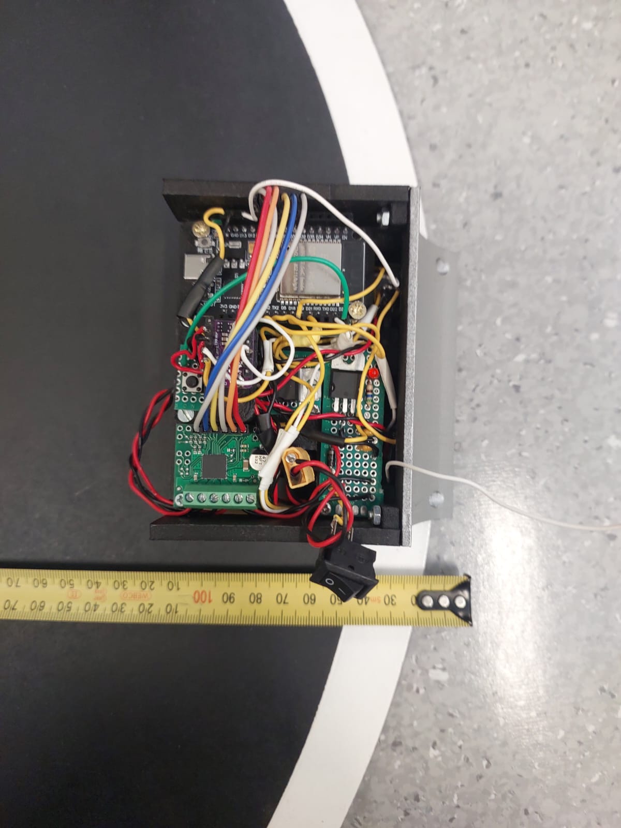
Tests/Edge detection test/255_duty_cycle_brake.jpeg
