chanelleblan/SumobotSkripsie/Tests/Edge detection test/WhatsApp Image 2026-11-06 at 16.47.56.jpeg

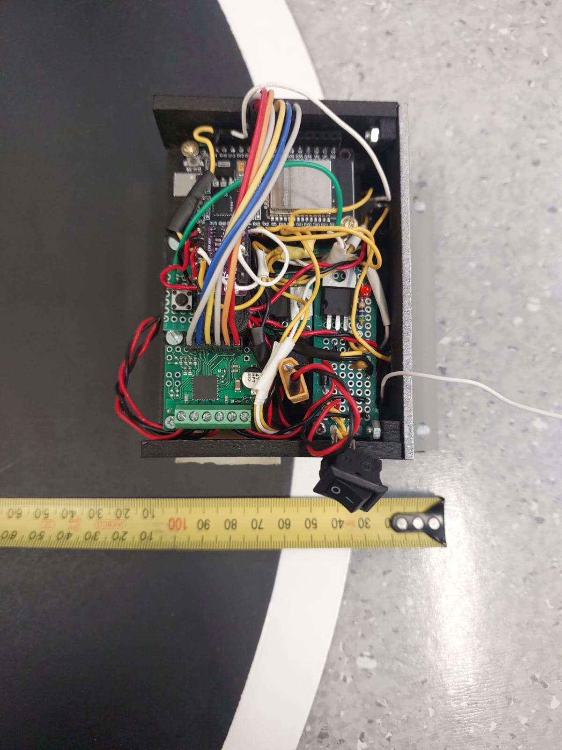
Tests/Edge detection test/WhatsApp Image 2026-11-06 at 16.47.56.jpeg
