chanelleblan/SumobotSkripsie/Tests/Final built system layout/Side_panel.jpeg

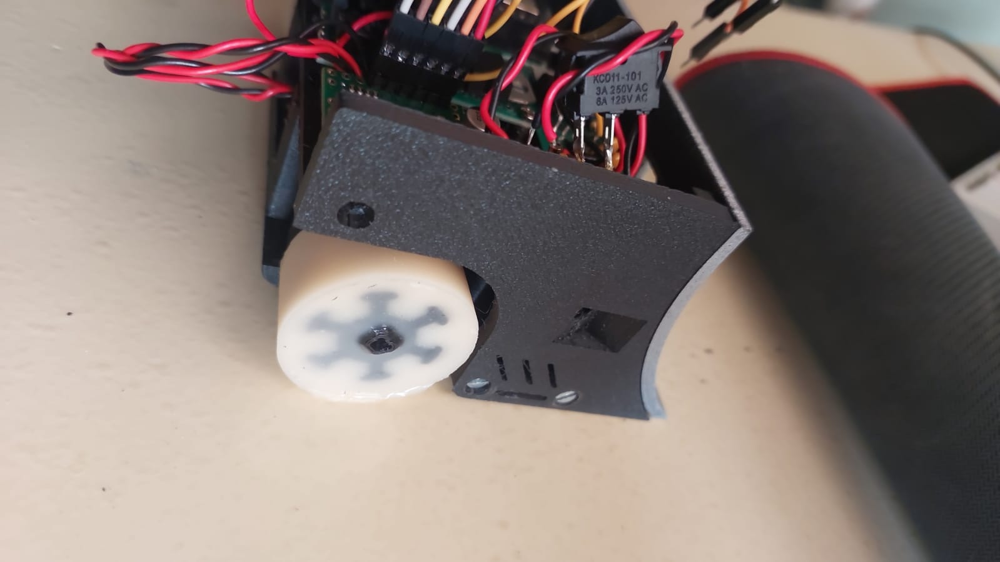
Tests/Final built system layout/Side_panel.jpeg
