chanelleblan/SumobotSkripsie/Tests/Final built system layout/WhatsApp Image 2026-11-06 at 16.44.48.jpeg

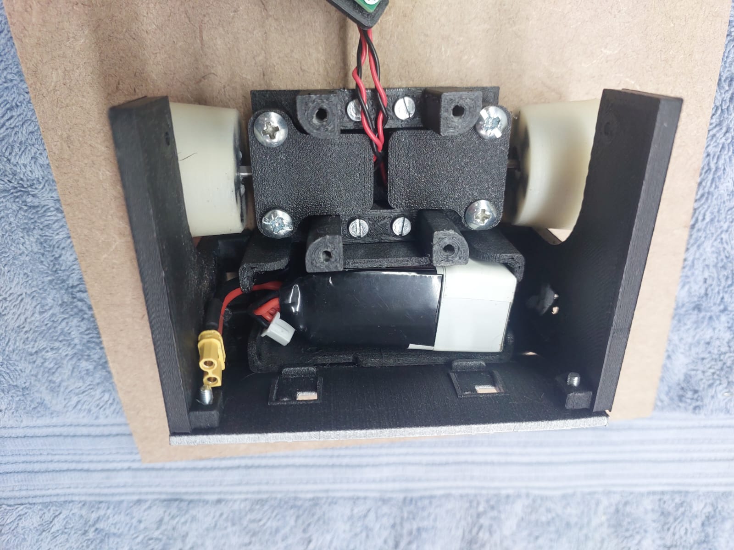
Tests/Final built system layout/WhatsApp Image 2026-11-06 at 16.44.48.jpeg
