chanelleblan/SumobotSkripsie/Tests/Final built system layout/WhatsApp Image 2026-11-06 at 16.47.53.jpeg

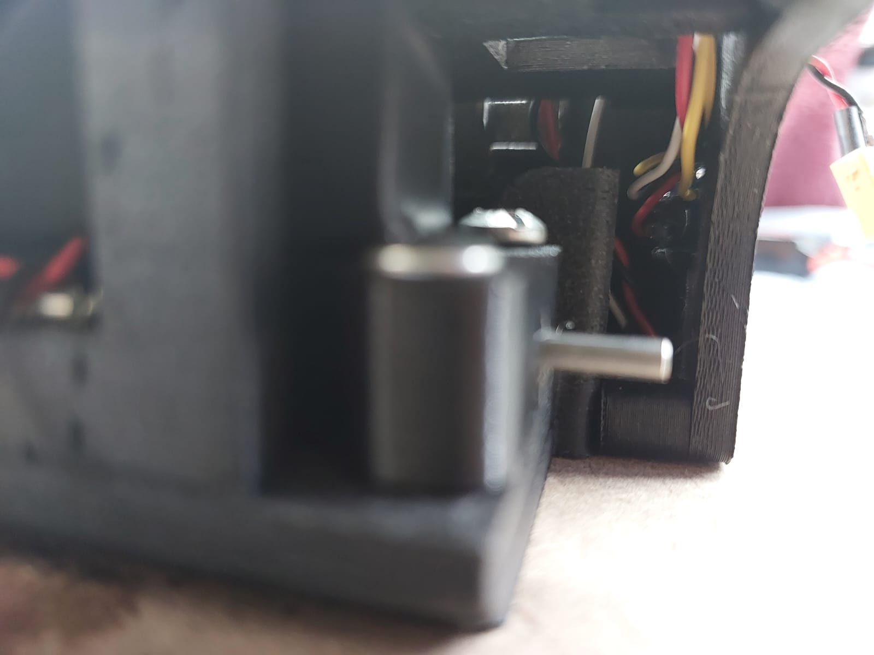
Tests/Final built system layout/WhatsApp Image 2026-11-06 at 16.47.53.jpeg
