chanelleblan/SumobotSkripsie/Tests/Final built system layout/WhatsApp Image 2026-11-06 at 17.12.44.jpeg

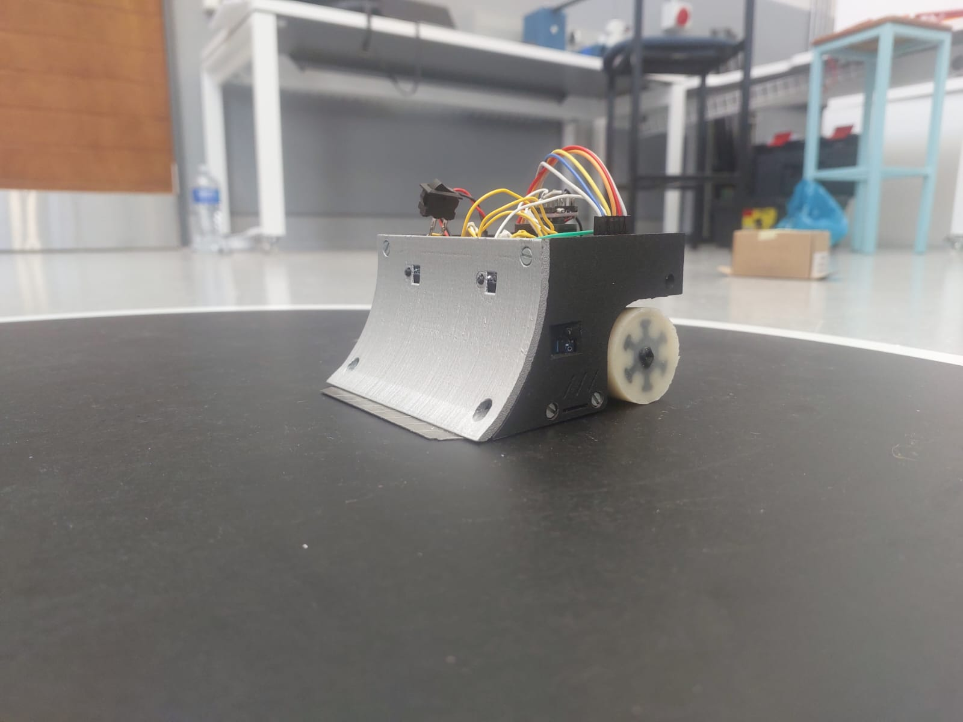
Tests/Final built system layout/WhatsApp Image 2026-11-06 at 17.12.44.jpeg
