chanelleblan/SumobotSkripsie/Tests/Friction/WhatsApp Image 2026-11-06 at 17.08.52.jpeg

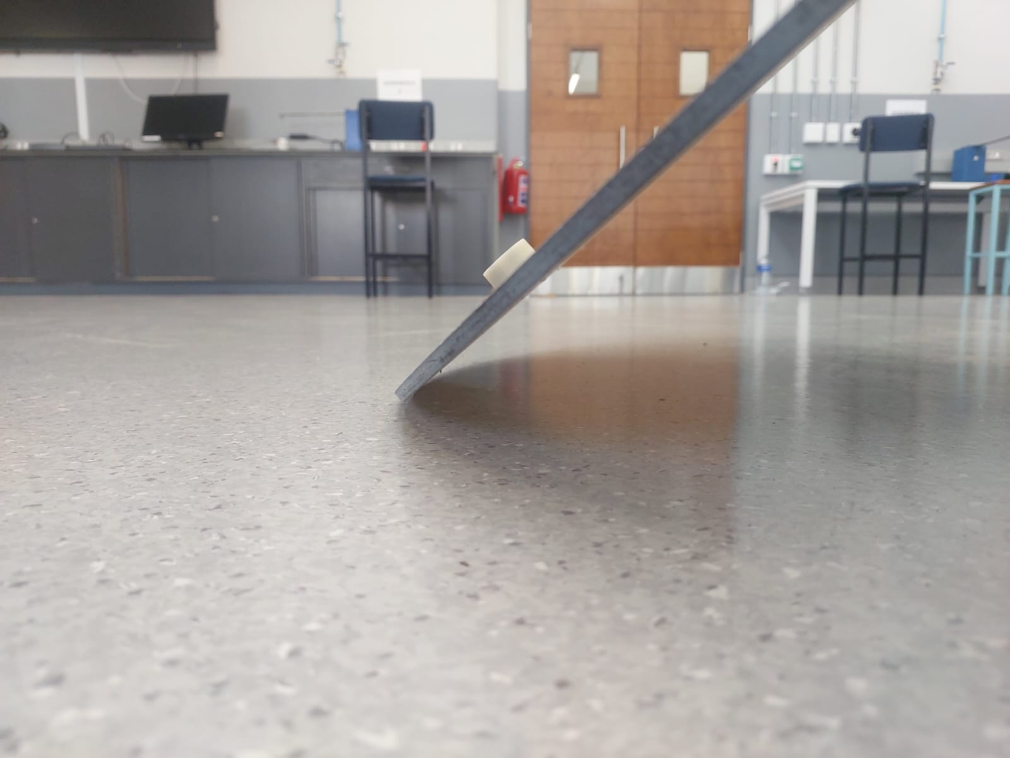
Tests/Friction/WhatsApp Image 2026-11-06 at 17.08.52.jpeg
