chanelleblan/SumobotSkripsie/Tests/Friction/WhatsApp Image 2026-11-06 at 17.12.31.jpeg

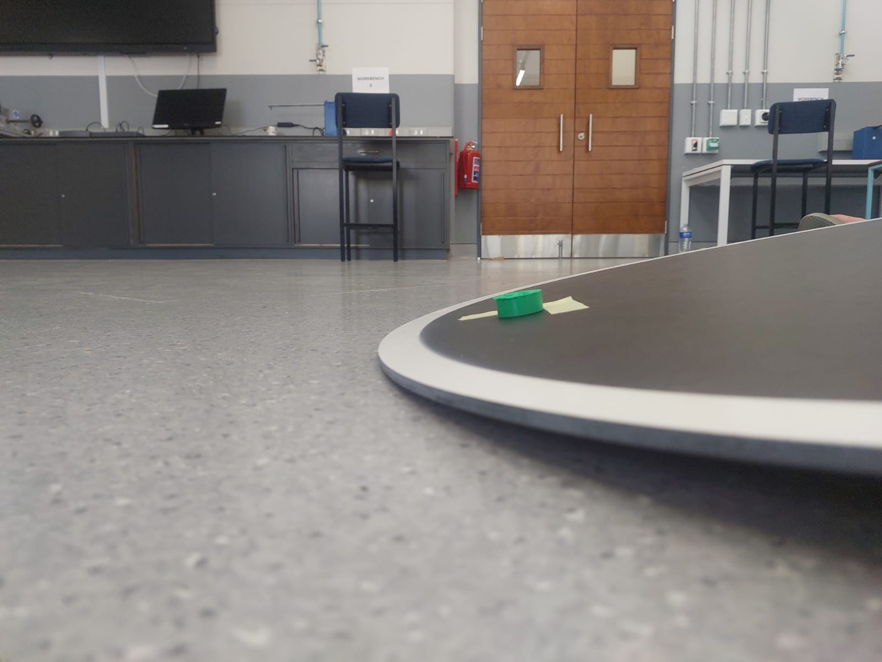
Tests/Friction/WhatsApp Image 2026-11-06 at 17.12.31.jpeg
