chanelleblan/SumobotSkripsie/Tests/Friction/WhatsApp Image 2026-11-06 at 17.12.33.jpeg

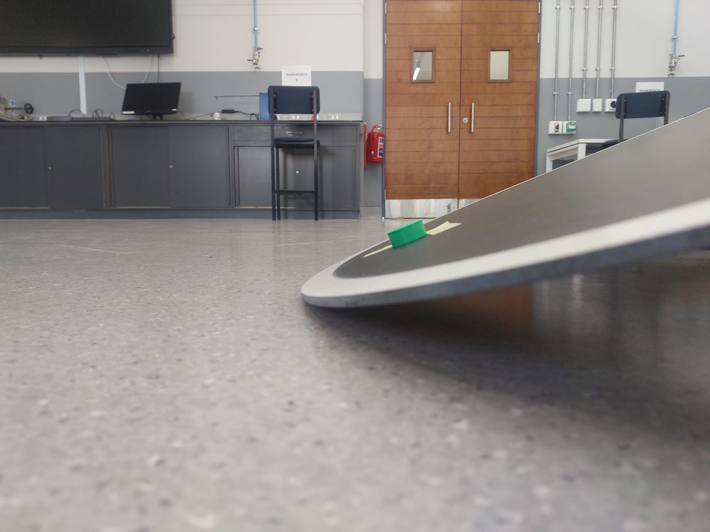
Tests/Friction/WhatsApp Image 2026-11-06 at 17.12.33.jpeg
