chanelleblan/SumobotSkripsie/Tests/Initial system test/WhatsApp Image 2026-11-06 at 16.38.08.jpeg

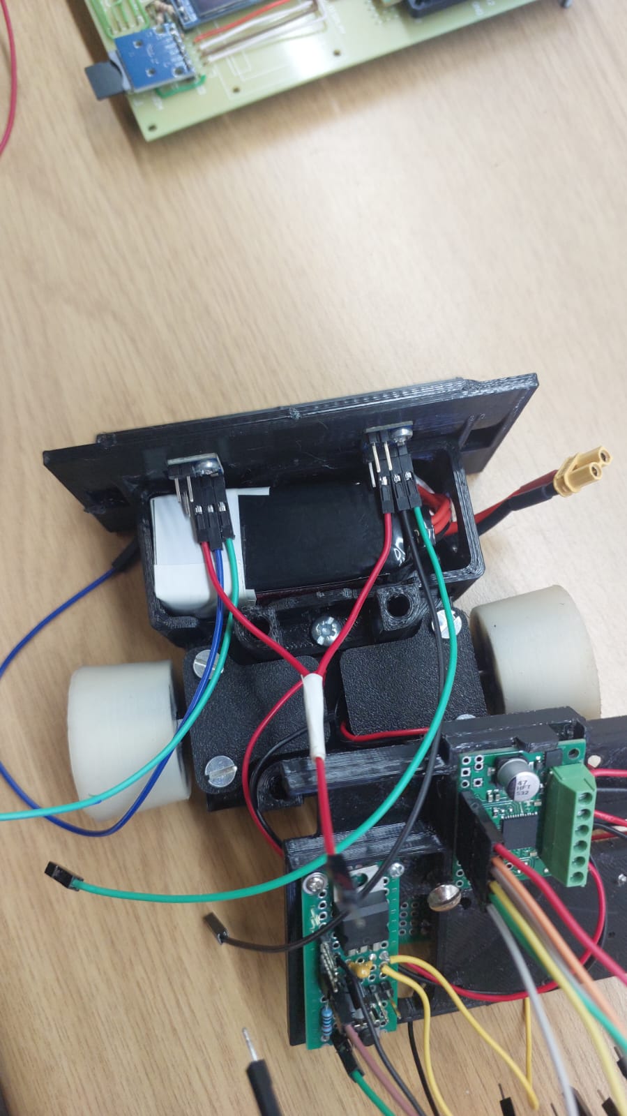
Tests/Initial system test/WhatsApp Image 2026-11-06 at 16.38.08.jpeg
