chanelleblan/SumobotSkripsie/Tests/PID tests/run2.png

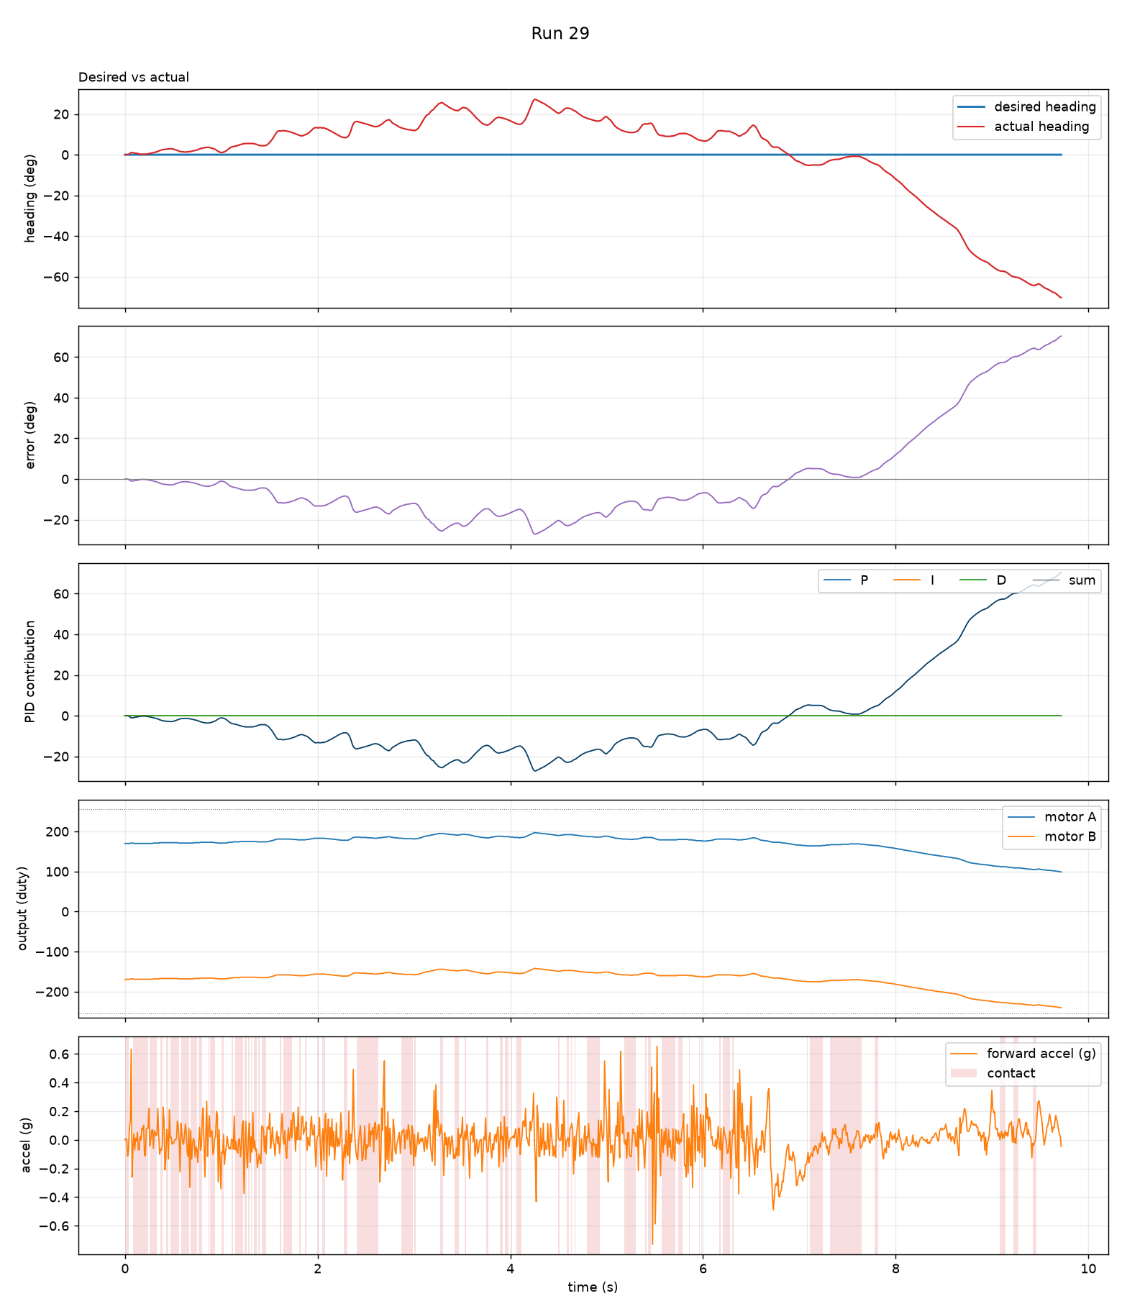
Tests/PID tests/run2.png
