chanelleblan/SumobotSkripsie/Tests/PID tests/run3.png

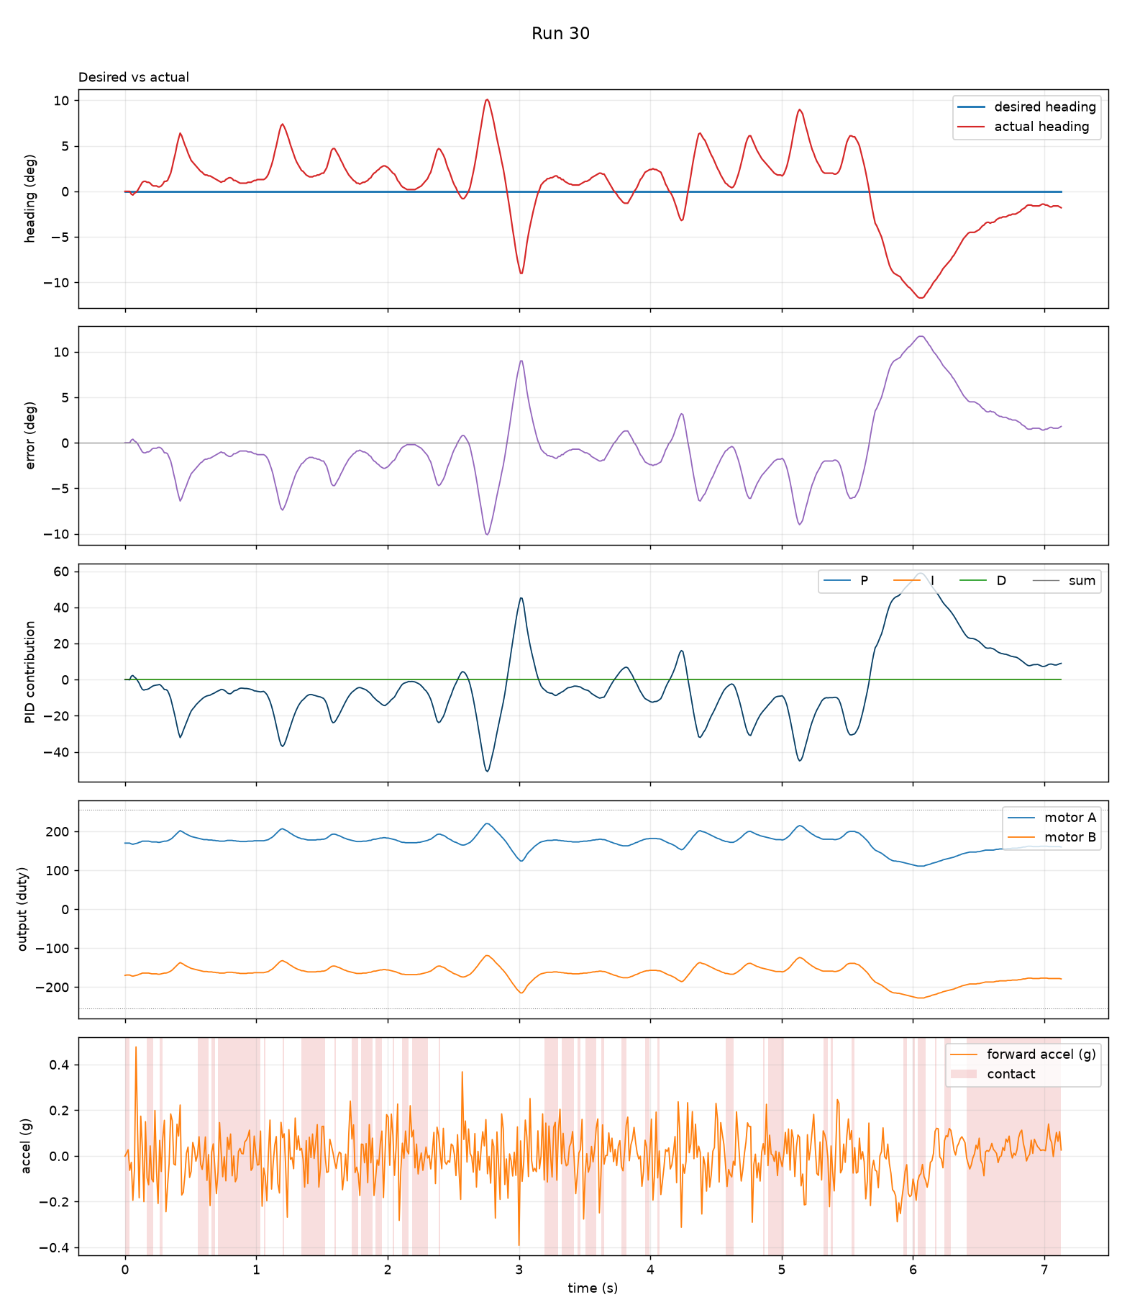
Tests/PID tests/run3.png
