chanelleblan/SumobotSkripsie/Tests/PID tests/run4.png

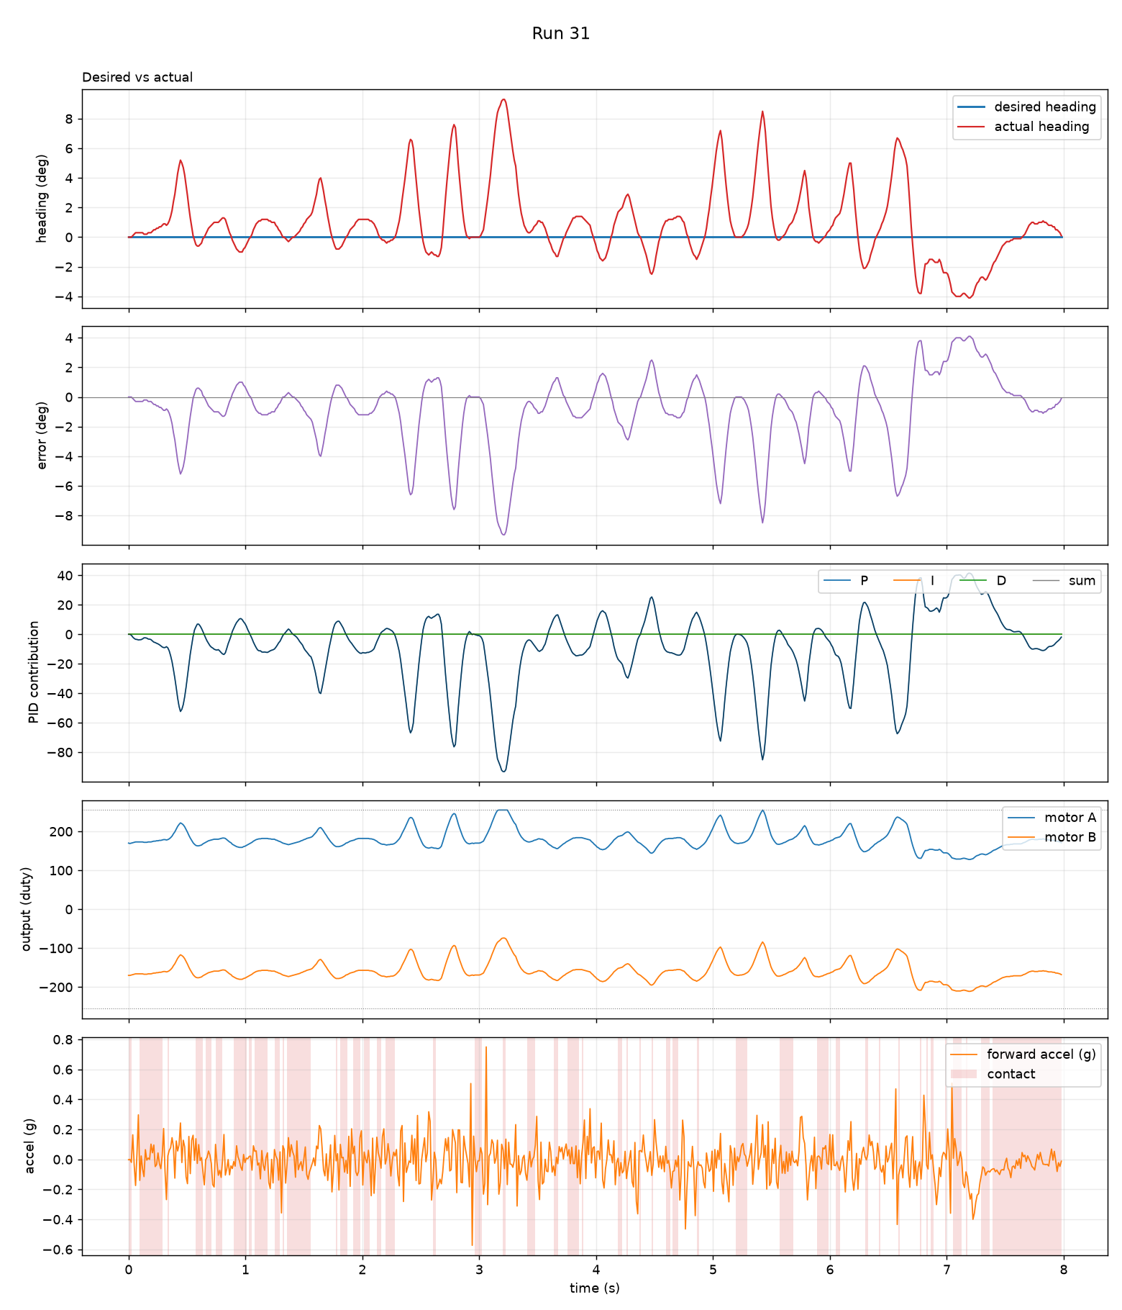
Tests/PID tests/run4.png
