chanelleblan/SumobotSkripsie/Tests/PID tests/run5.png

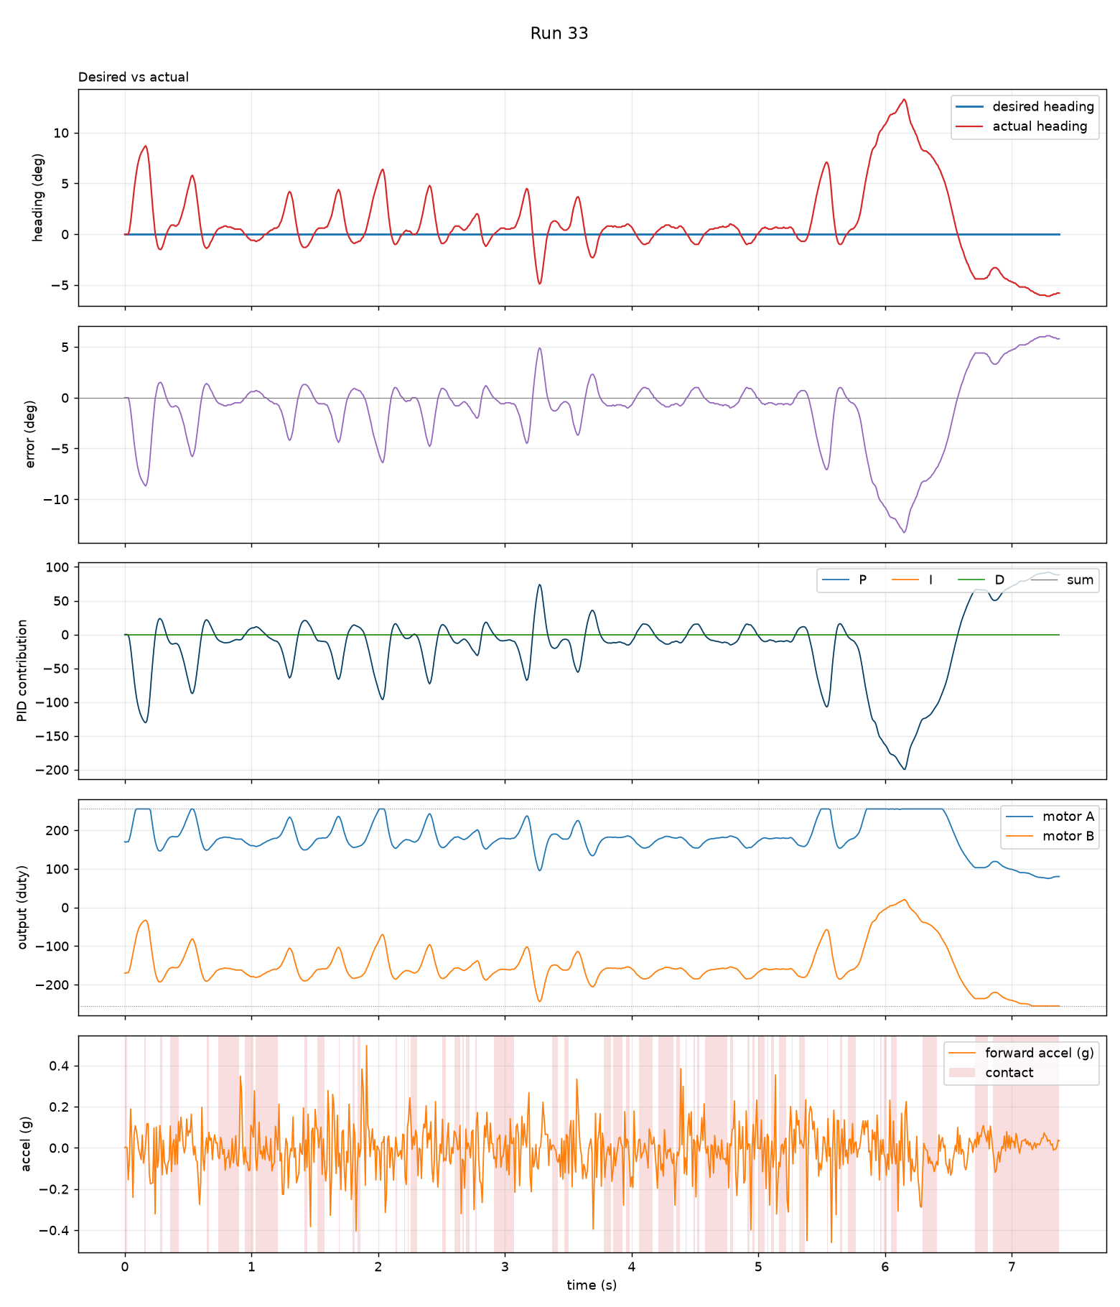
Tests/PID tests/run5.png
