chanelleblan/SumobotSkripsie/Tests/PID tests/run7.png

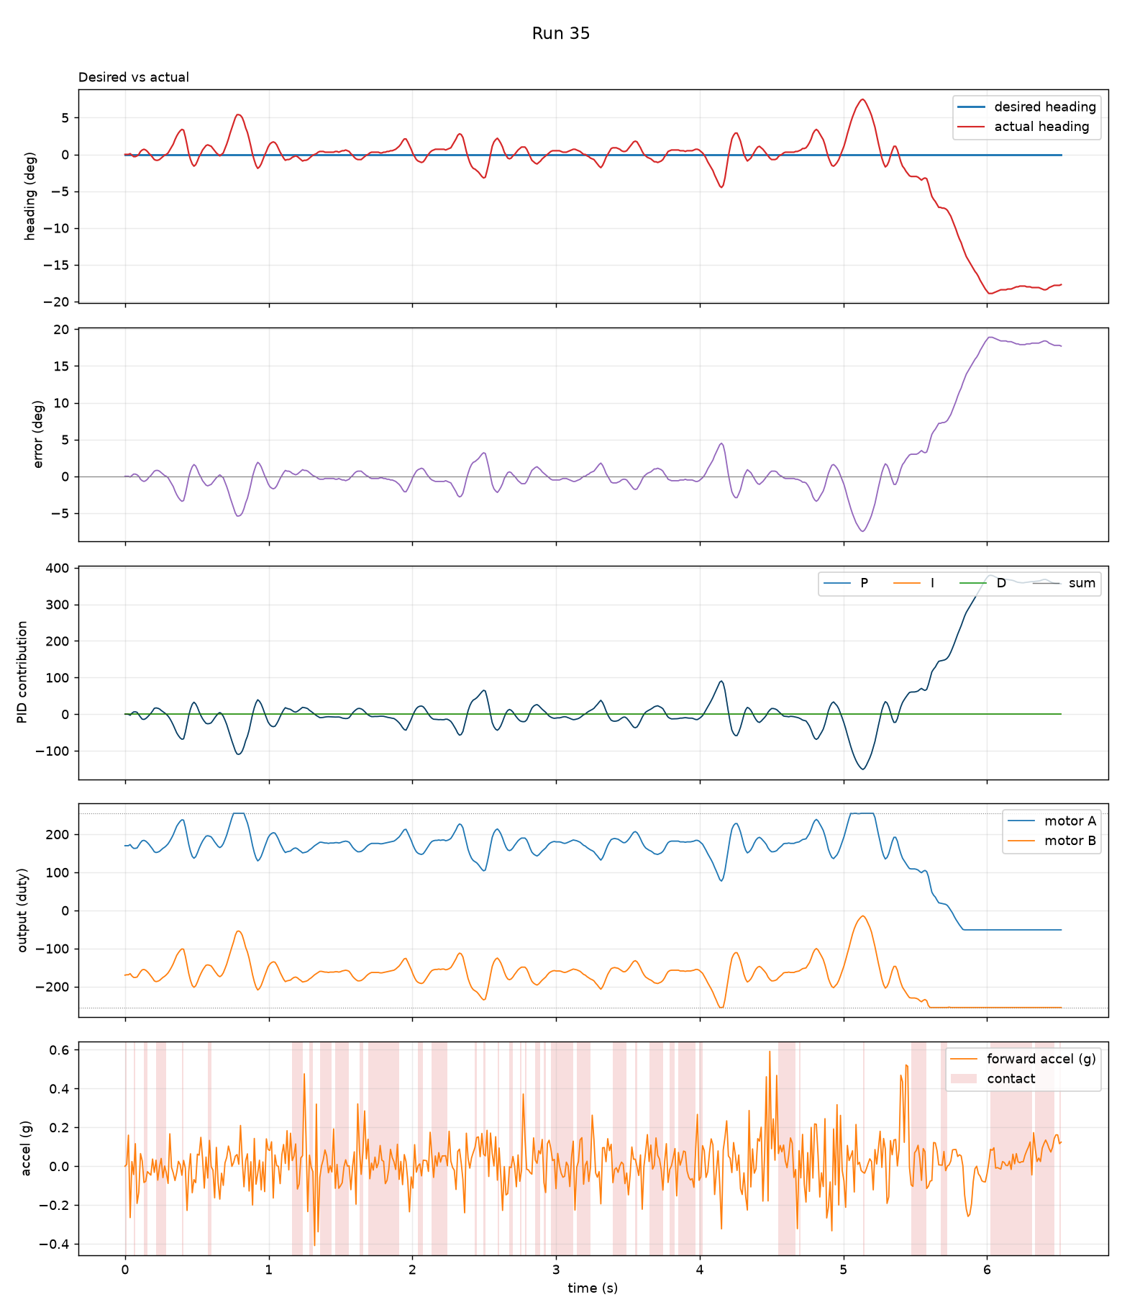
Tests/PID tests/run7.png
