chanelleblan/SumobotSkripsie/Tests/PID tests/run8.png

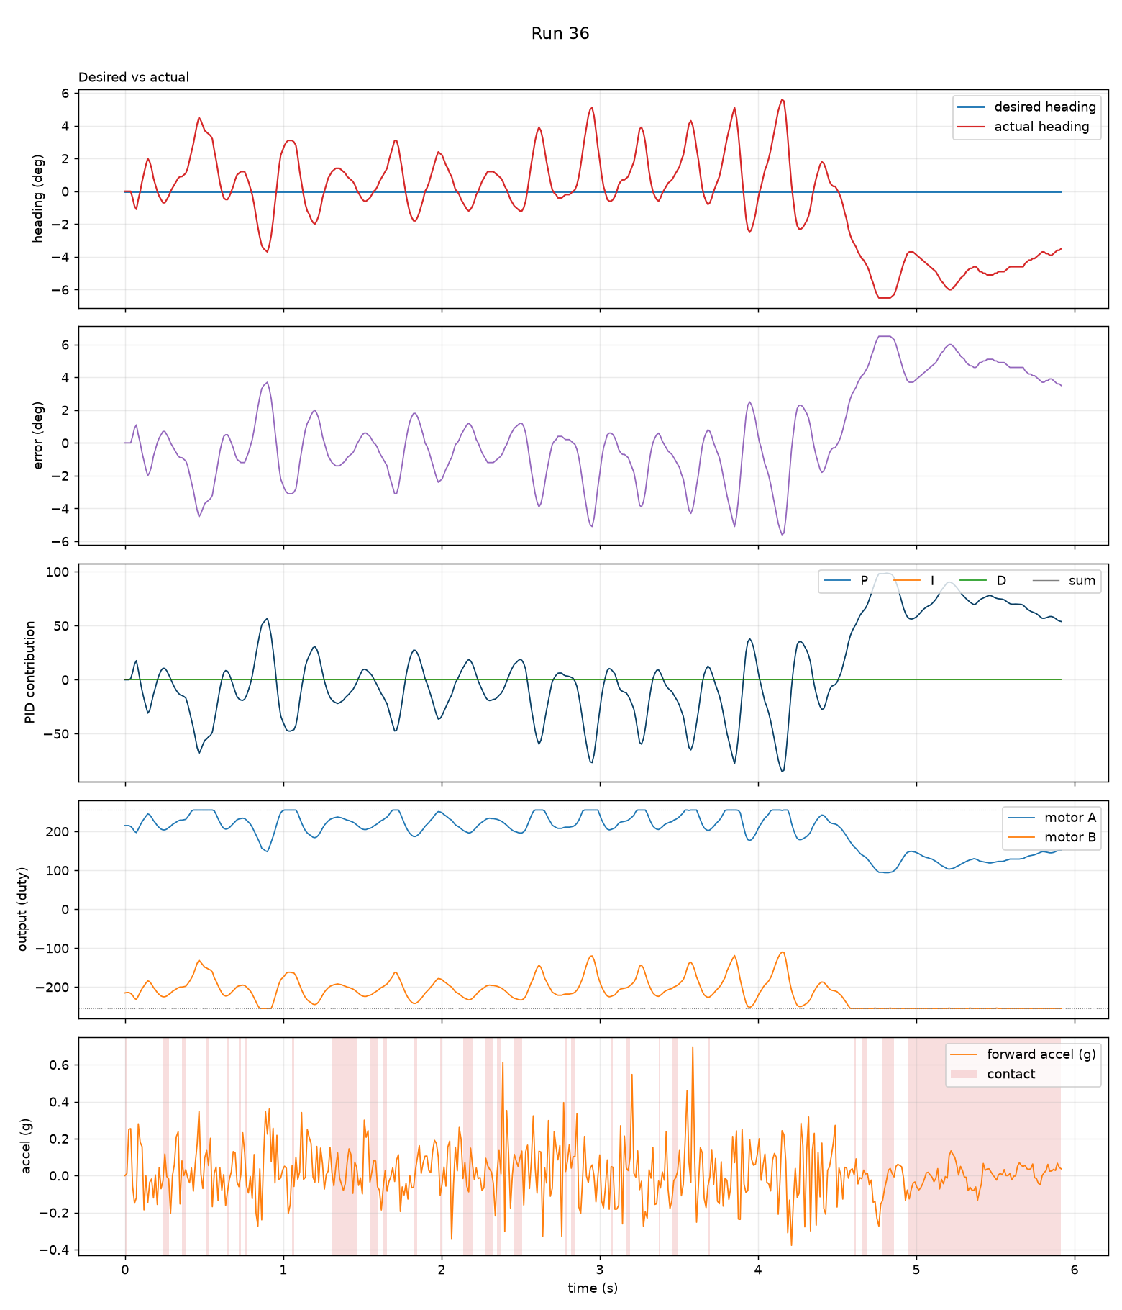
Tests/PID tests/run8.png
