chanelleblan/SumobotSkripsie/Tests/PID tests/run9.png

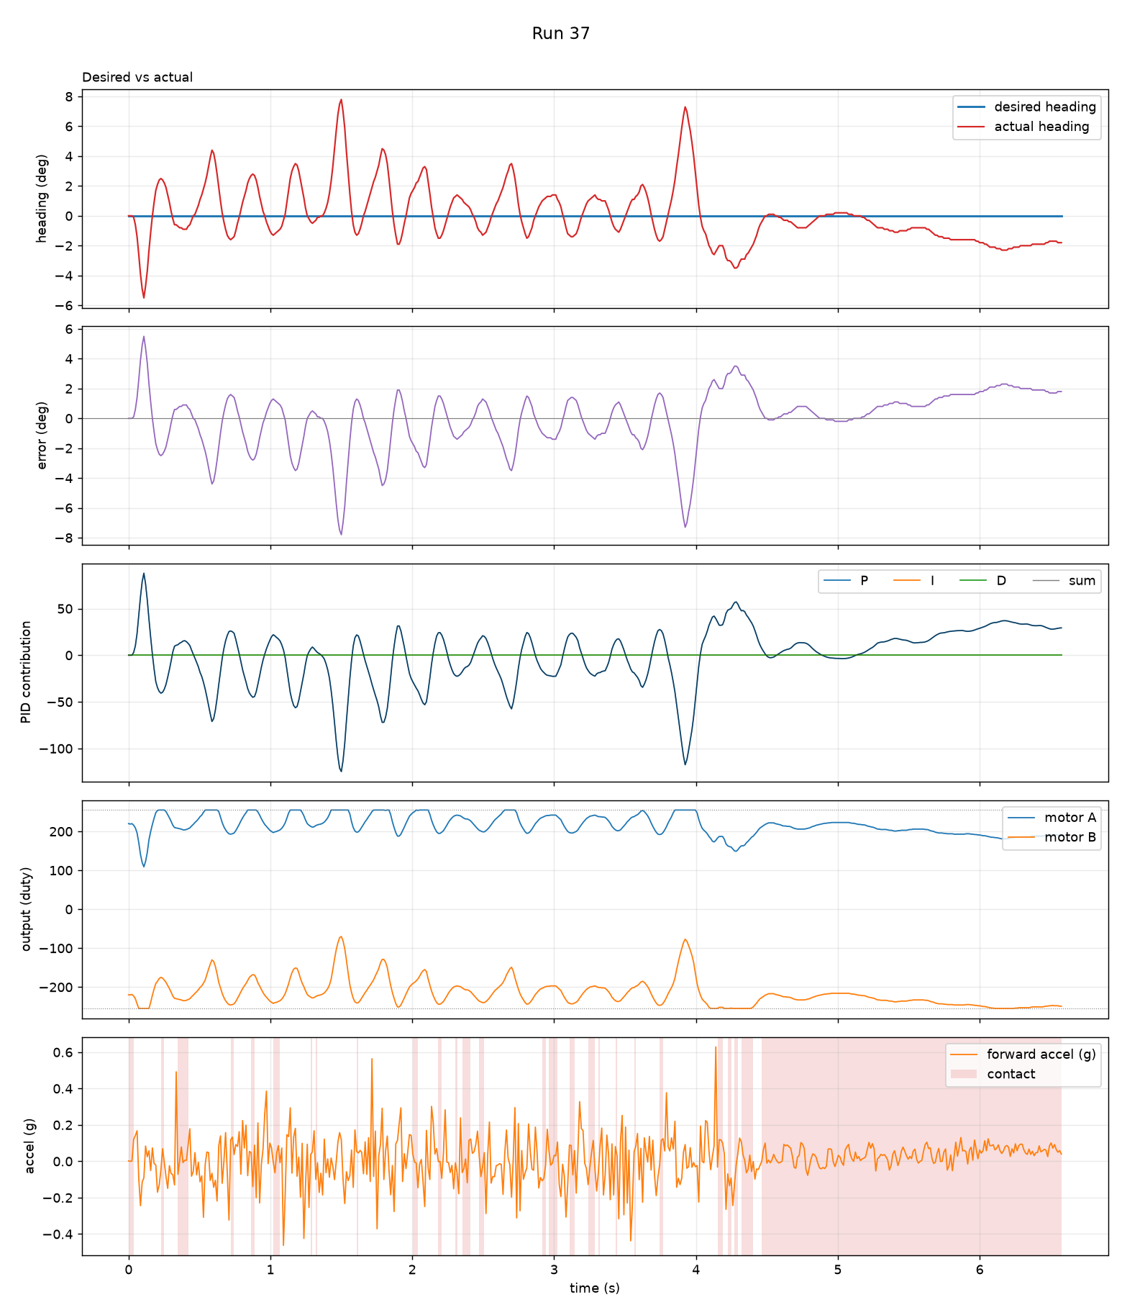
Tests/PID tests/run9.png
