chanelleblan/SumobotSkripsie/Tests/PID tests/run10.png

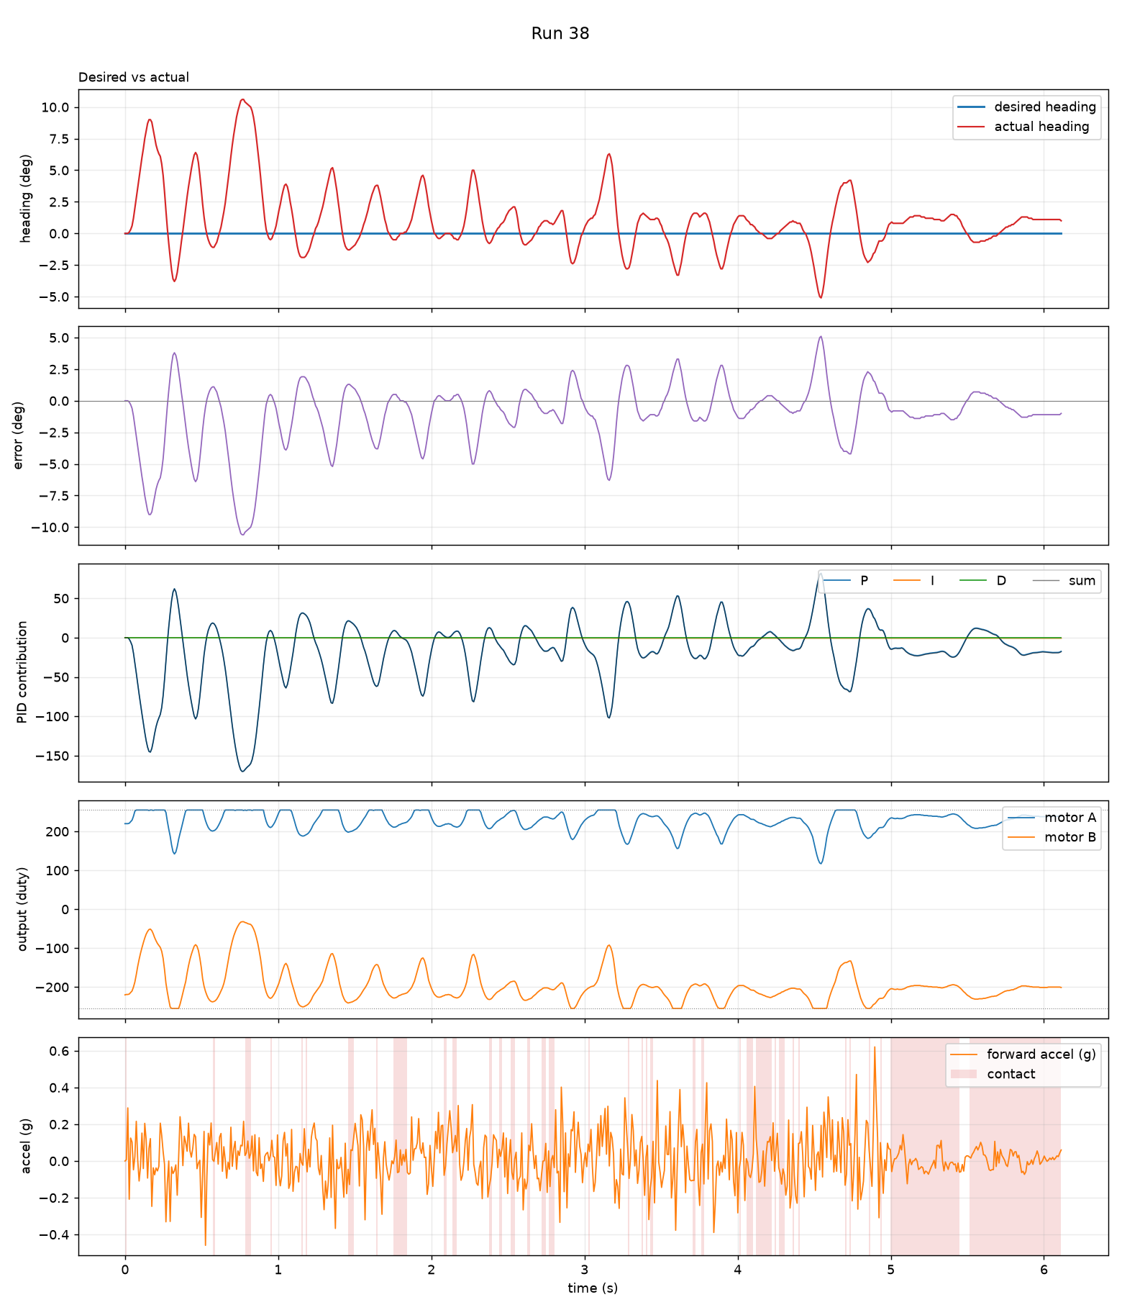
Tests/PID tests/run10.png
