chanelleblan/SumobotSkripsie/Tests/PID tests/run11.png

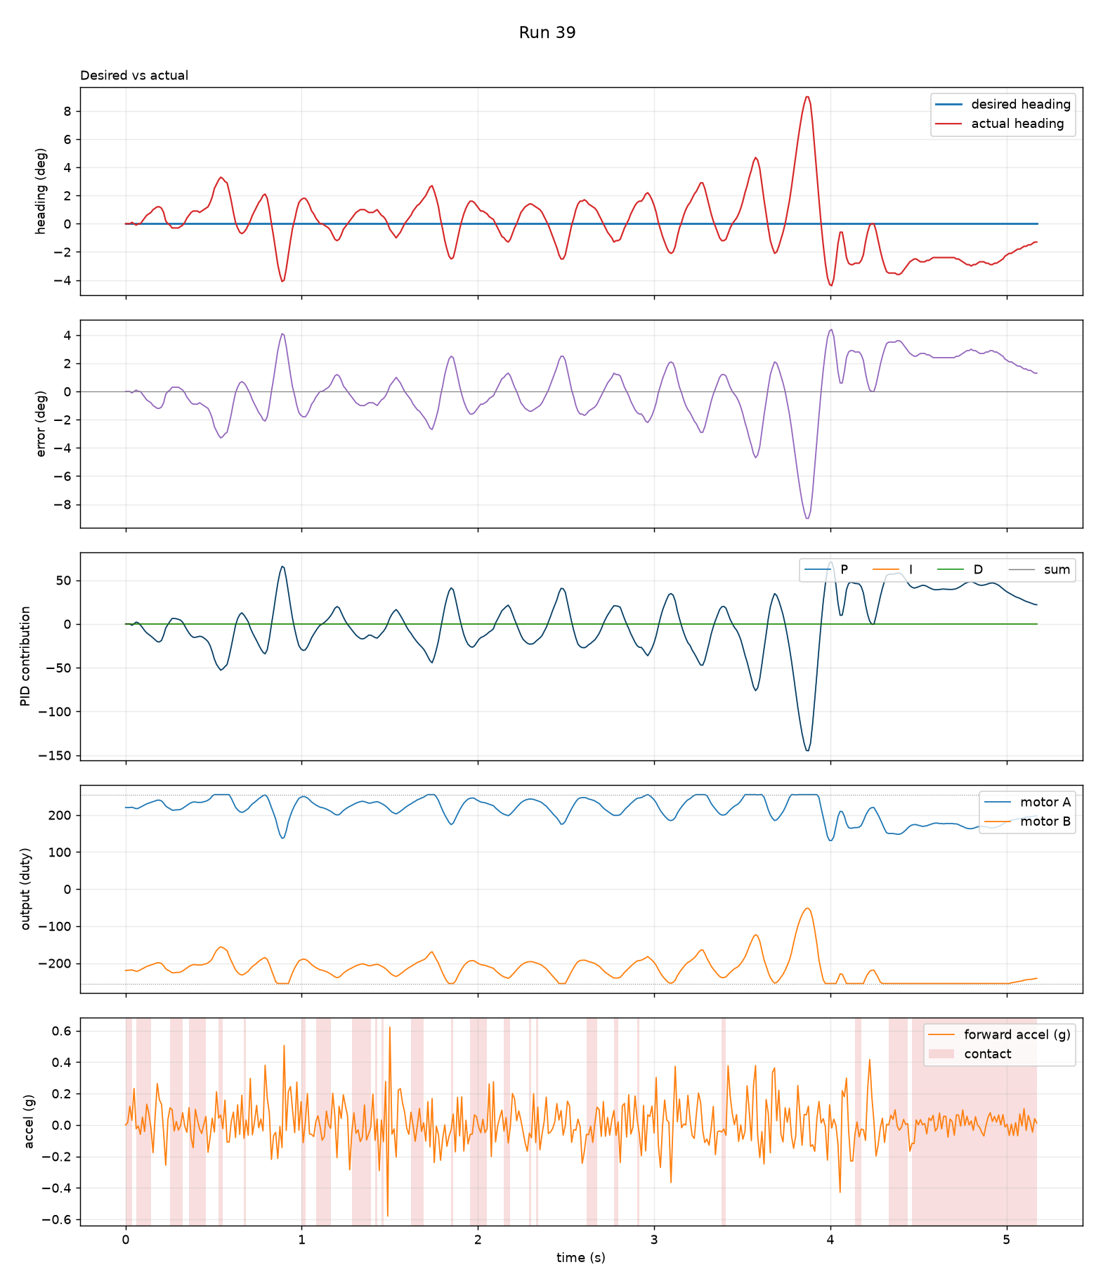
Tests/PID tests/run11.png
