chanelleblan/SumobotSkripsie/Tests/PID tests/run13.png

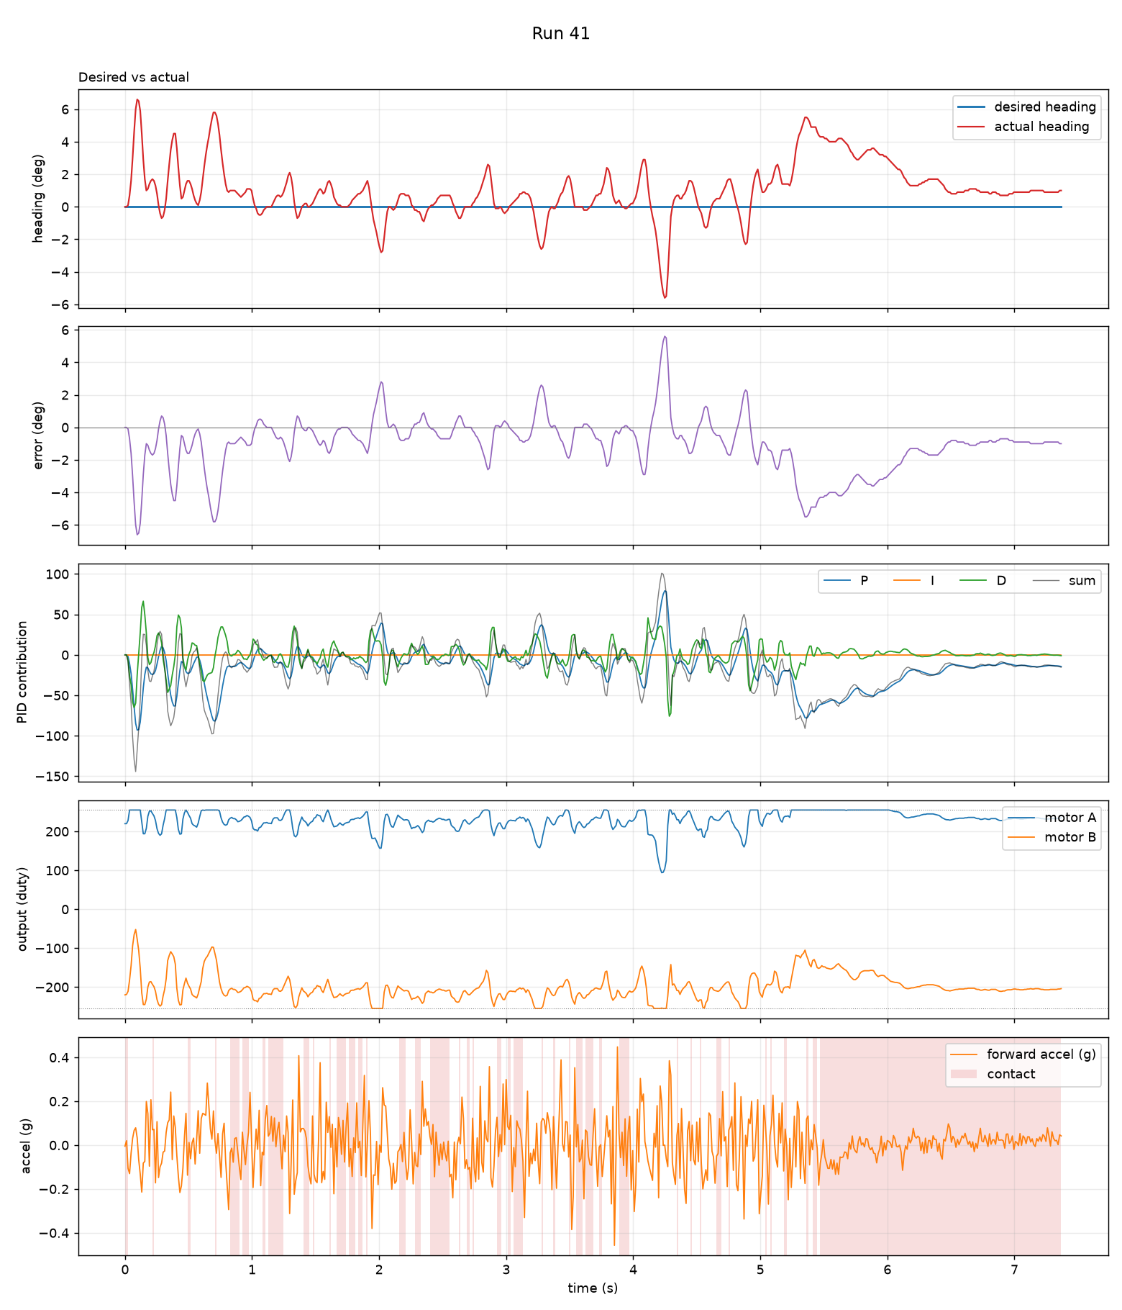
Tests/PID tests/run13.png
