chanelleblan/SumobotSkripsie/Tests/PID tests/run14.png

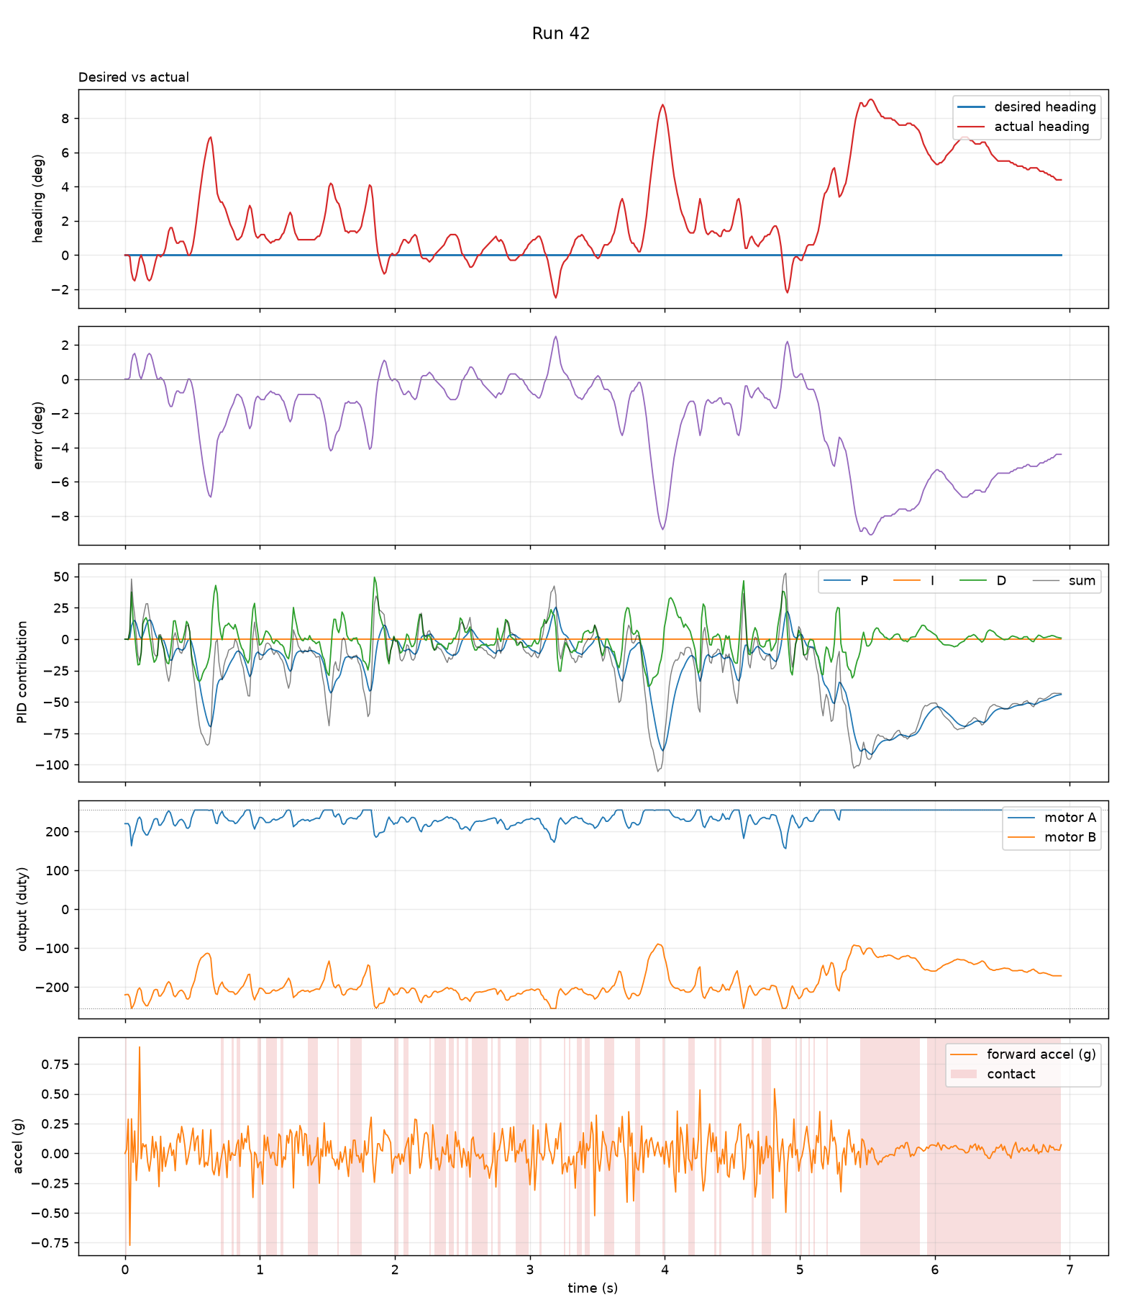
Tests/PID tests/run14.png
