chanelleblan/SumobotSkripsie/Tests/PID turning test/turn-response-1.png

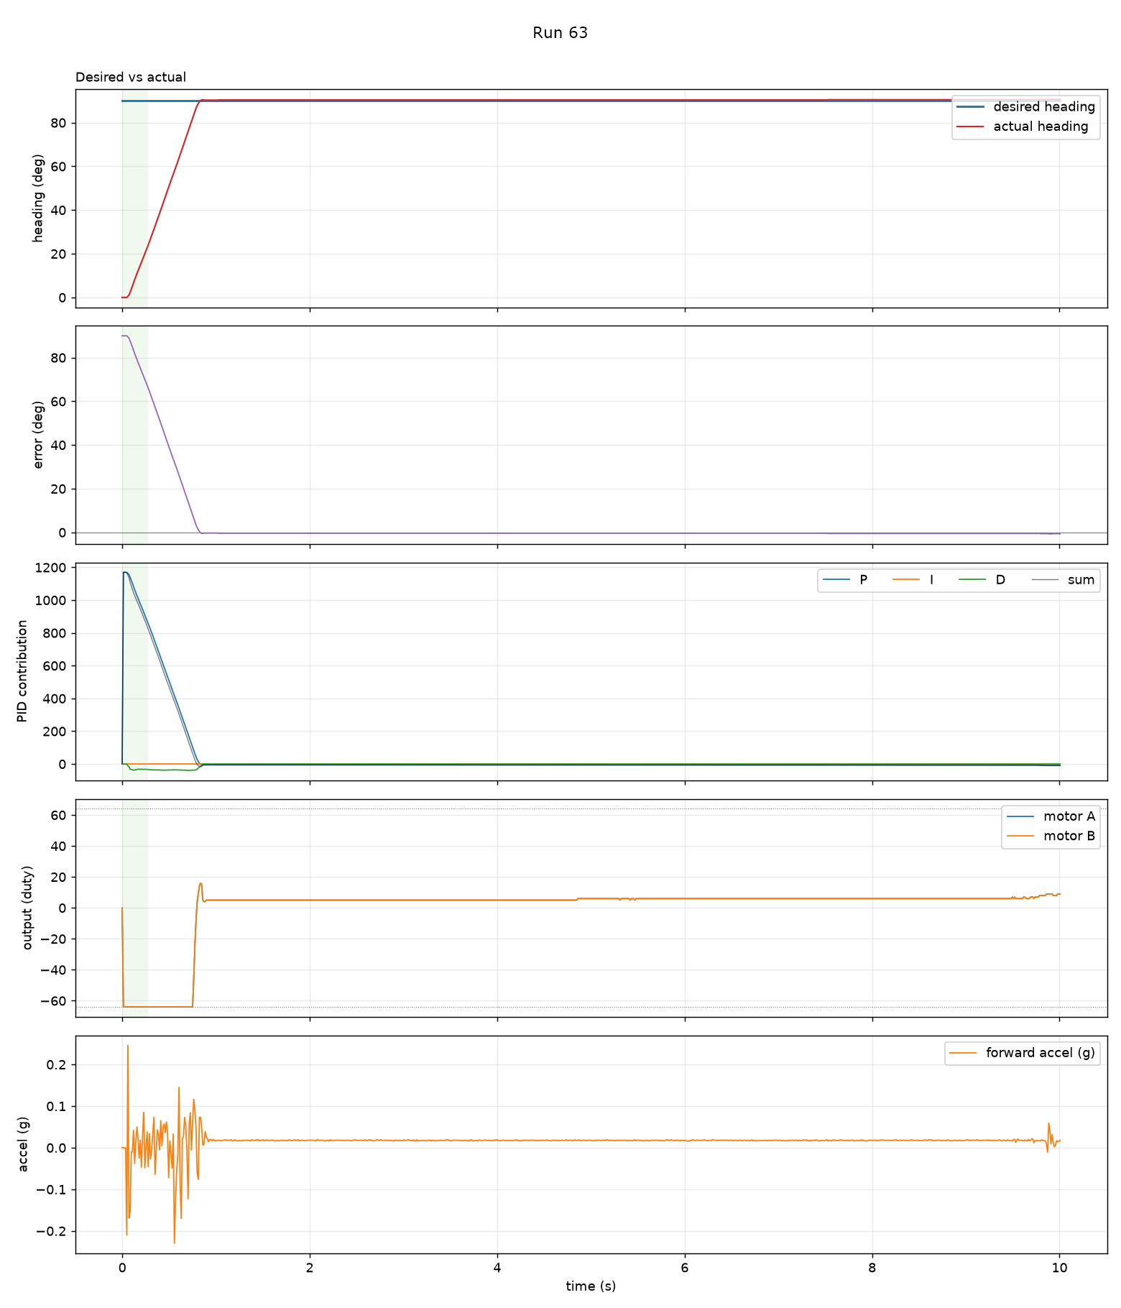
Tests/PID turning test/turn-response-1.png
