chanelleblan/SumobotSkripsie/Tests/PID turning test/turn-response-2.png

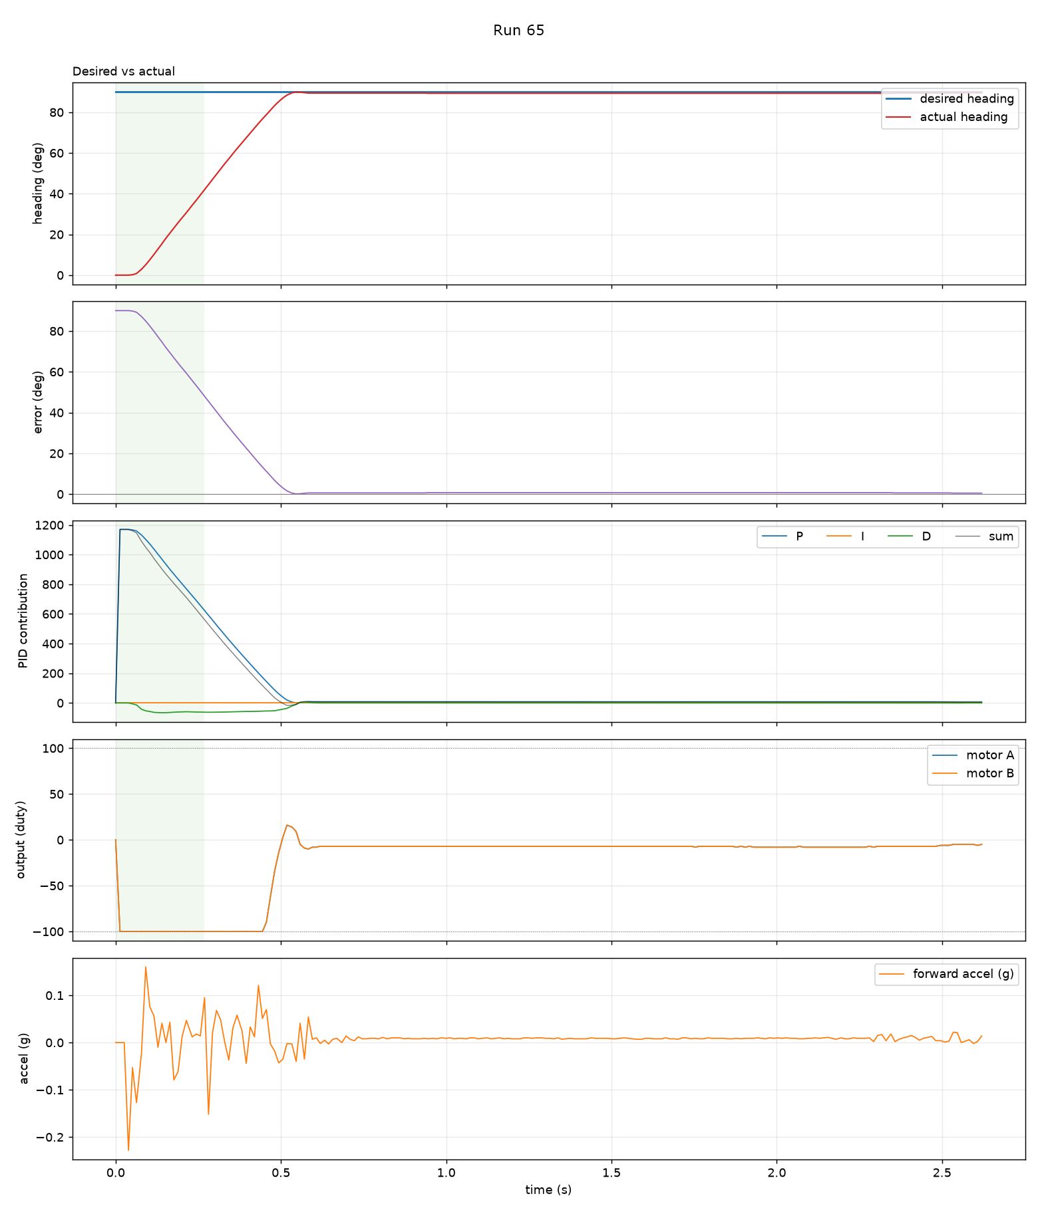
Tests/PID turning test/turn-response-2.png
