chanelleblan/SumobotSkripsie/Tests/PID turning test/turn-response-60.png

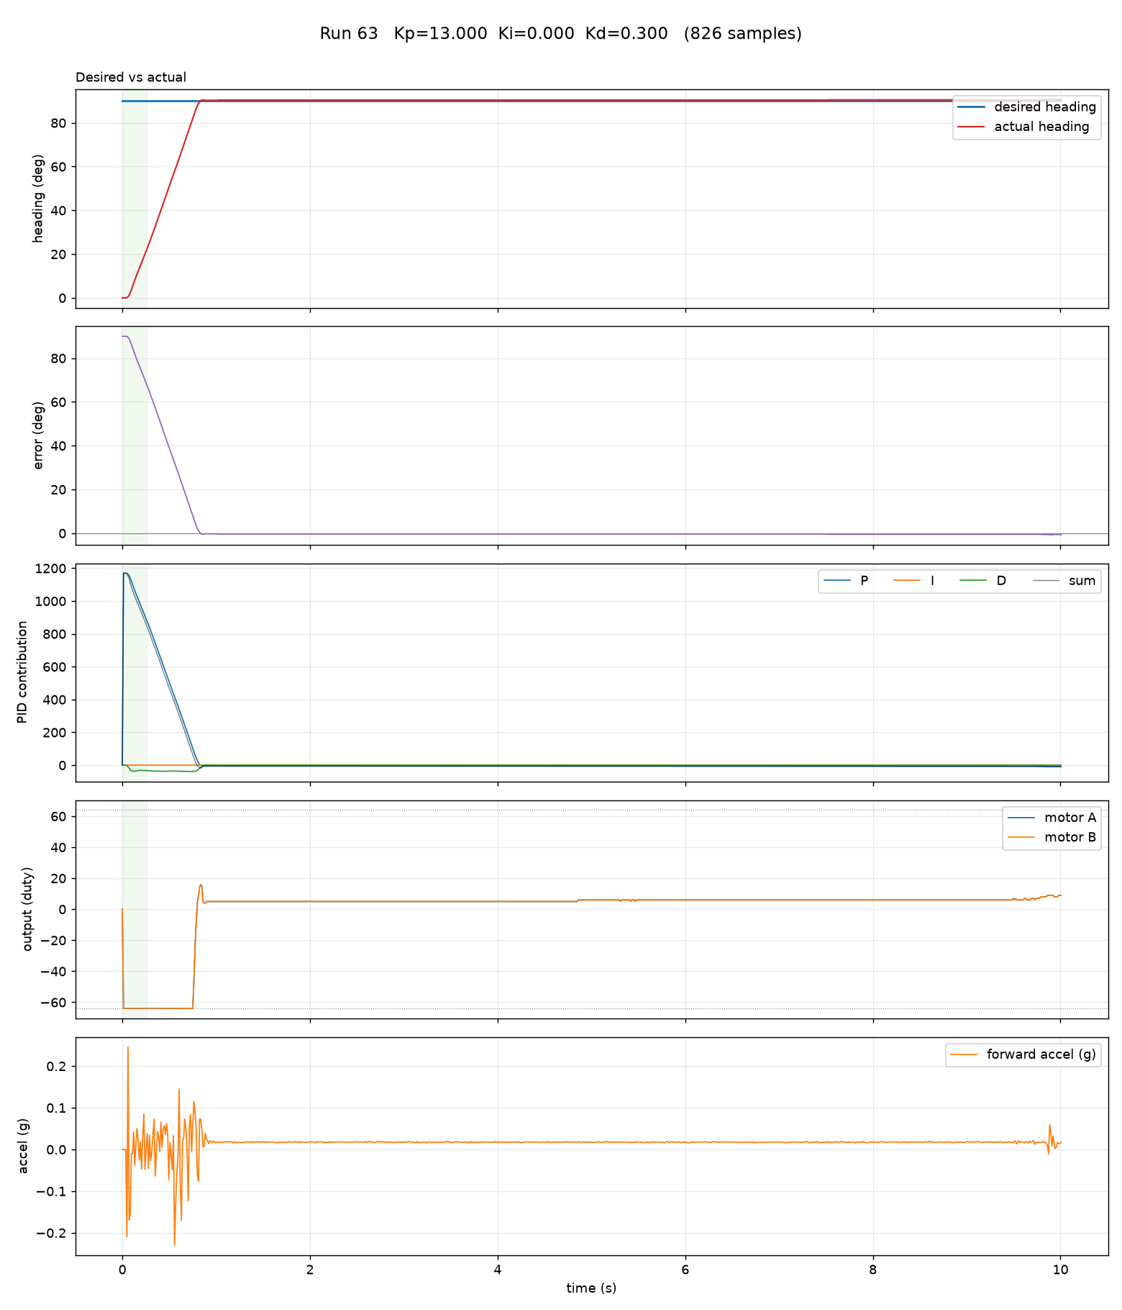
Tests/PID turning test/turn-response-60.png
