chanelleblan/SumobotSkripsie/Tests/PID turning test/turn-response-100.png

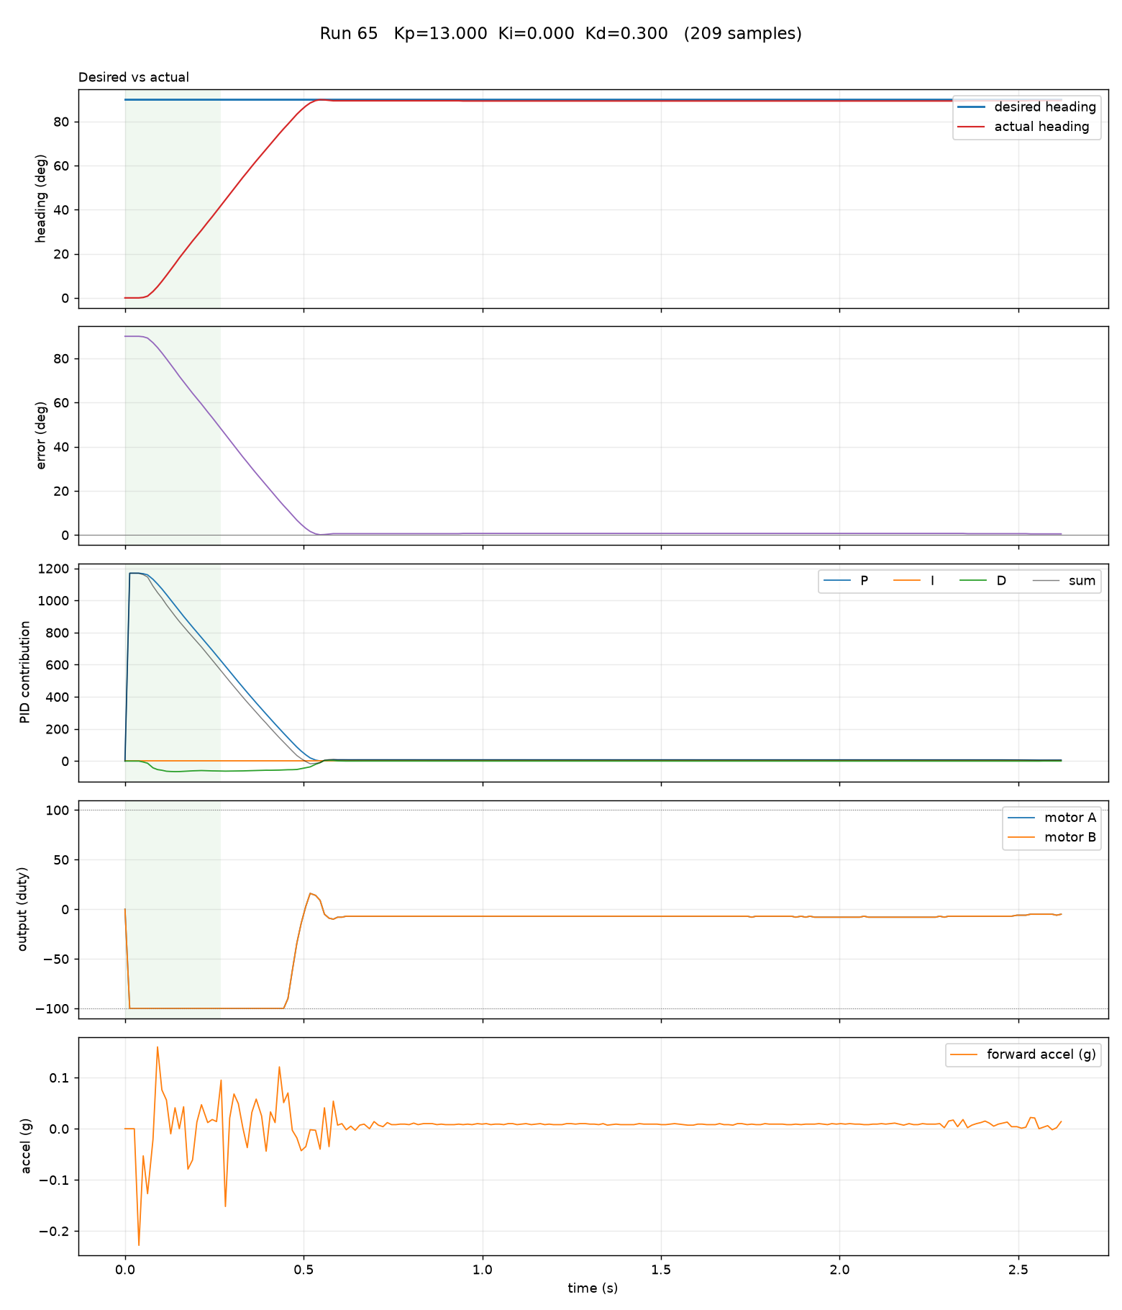
Tests/PID turning test/turn-response-100.png
