chanelleblan/SumobotSkripsie/Tests/PID turning test/turn-response-150.png

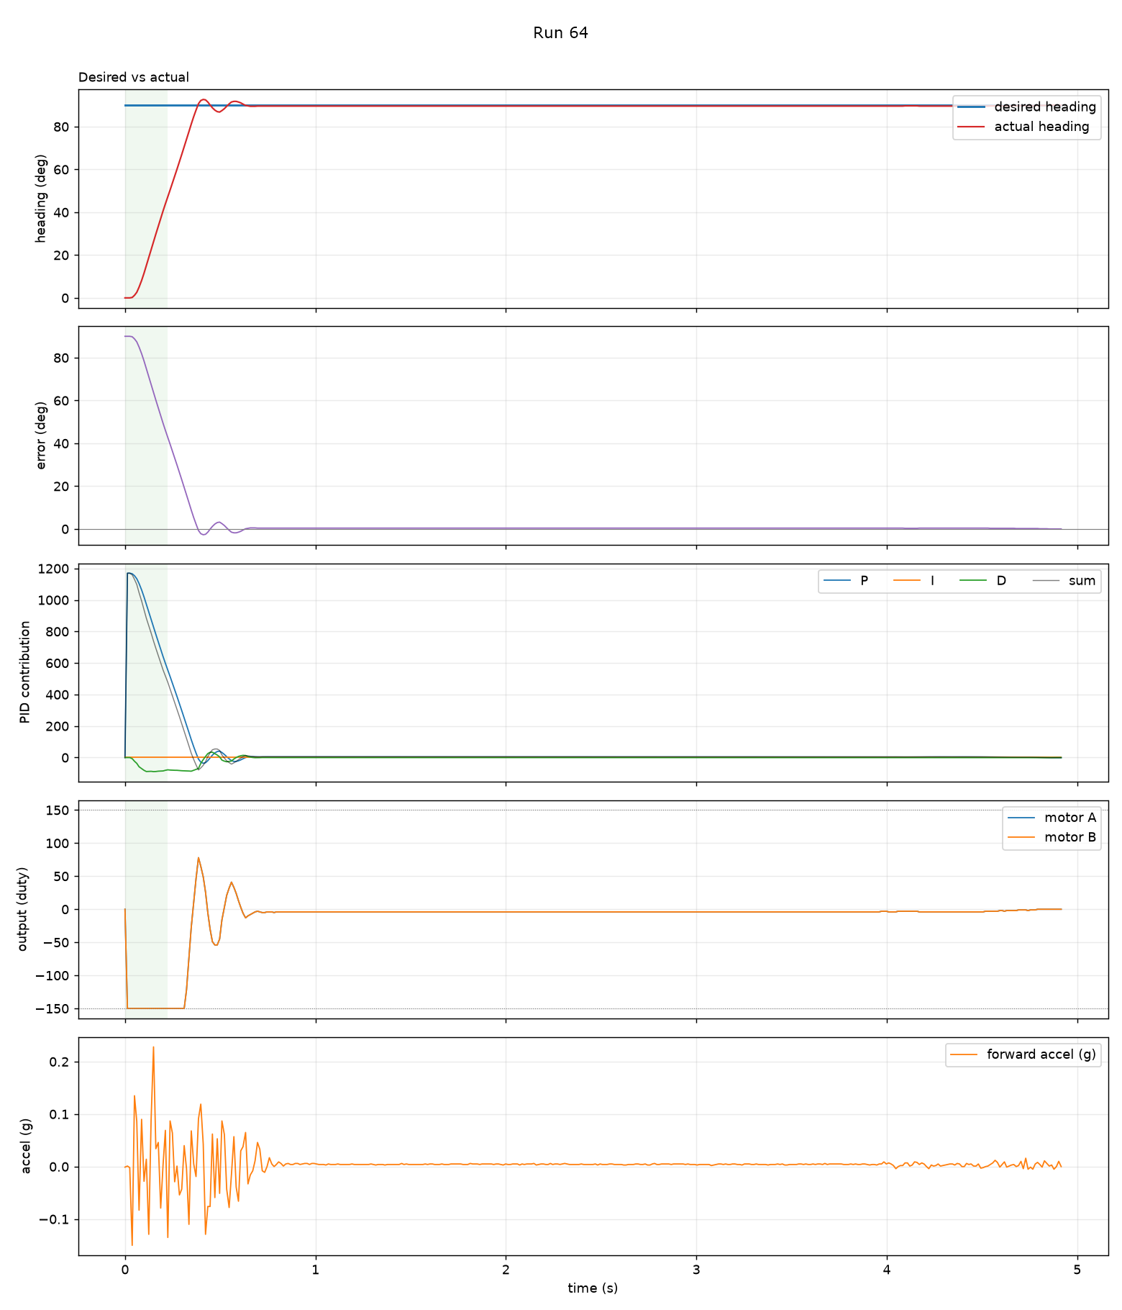
Tests/PID turning test/turn-response-150.png
