chanelleblan/SumobotSkripsie/Tests/PID turning test/turn-response-200.png

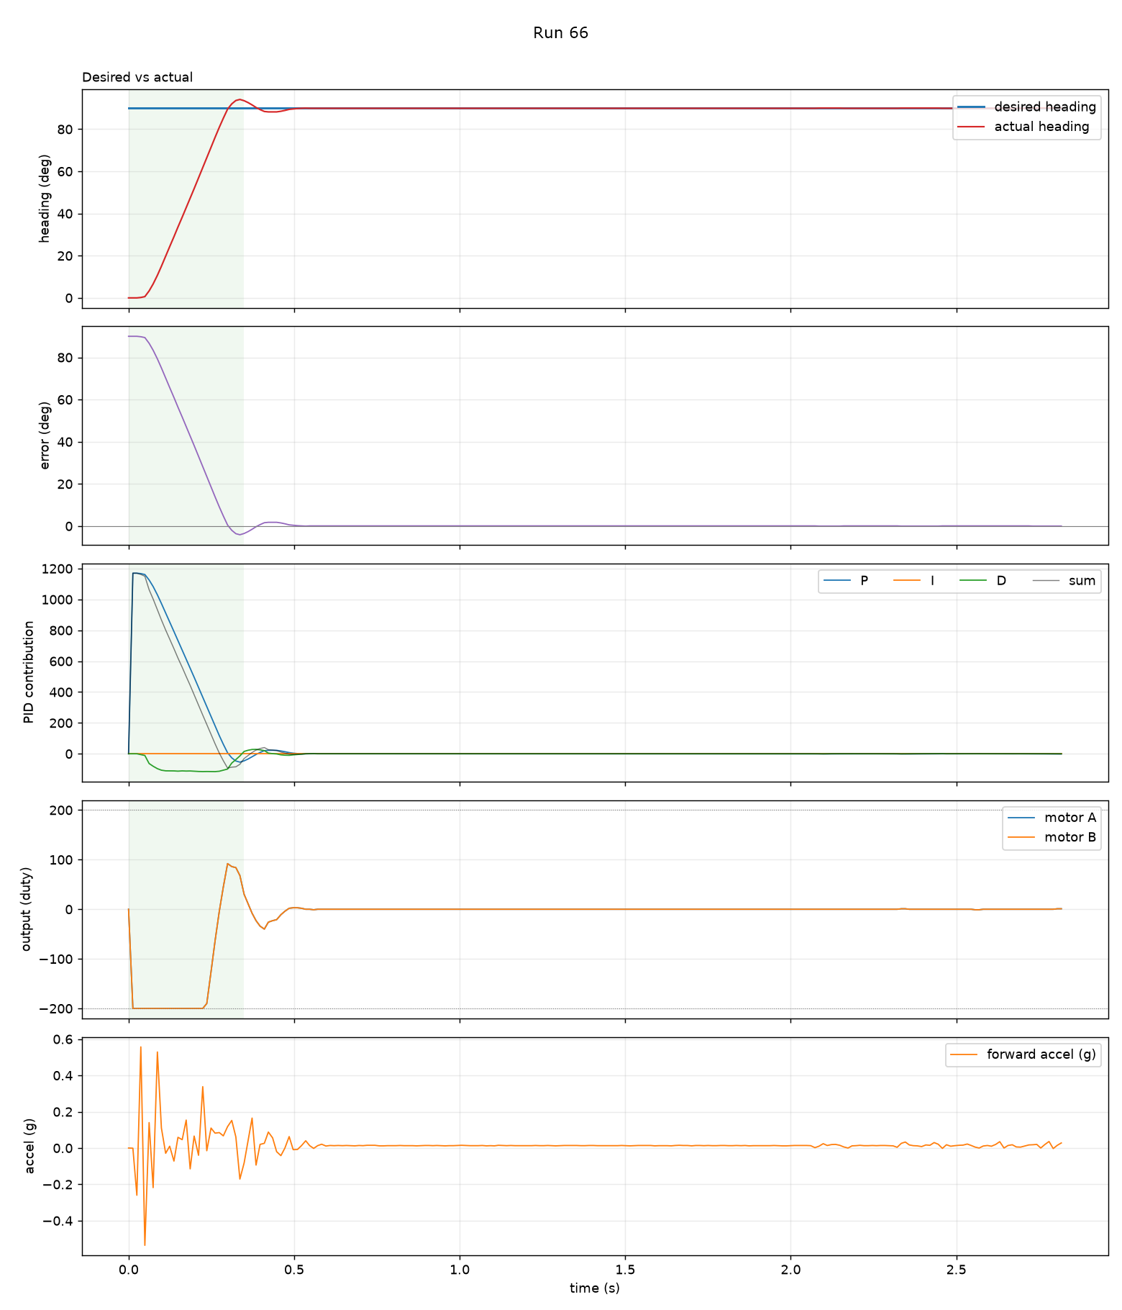
Tests/PID turning test/turn-response-200.png
