chanelleblan/SumobotSkripsie/Tests/PID turning test/WhatsApp Image 2026-11-06 at 16.53.19.jpeg

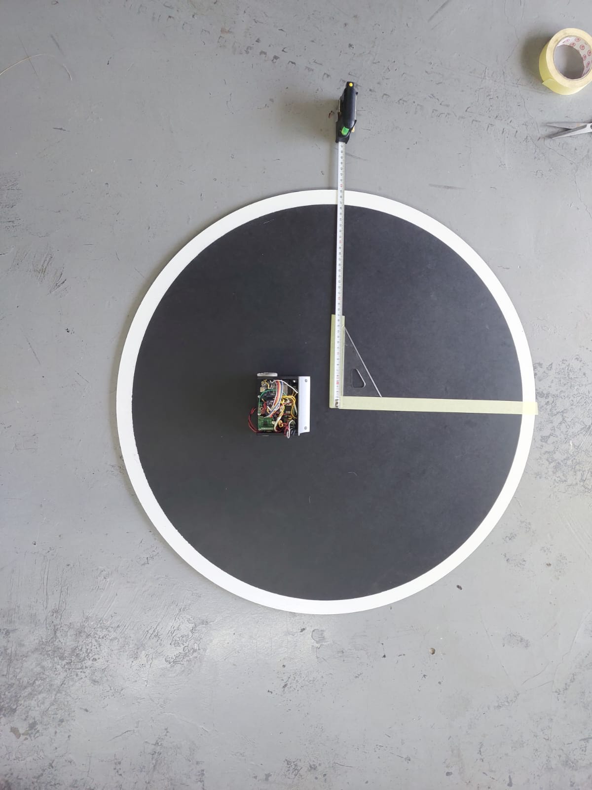
Tests/PID turning test/WhatsApp Image 2026-11-06 at 16.53.19.jpeg
