chanelleblan/SumobotSkripsie/Tests/Power supply test/WhatsApp Image 2026-11-06 at 16.09.14.jpeg

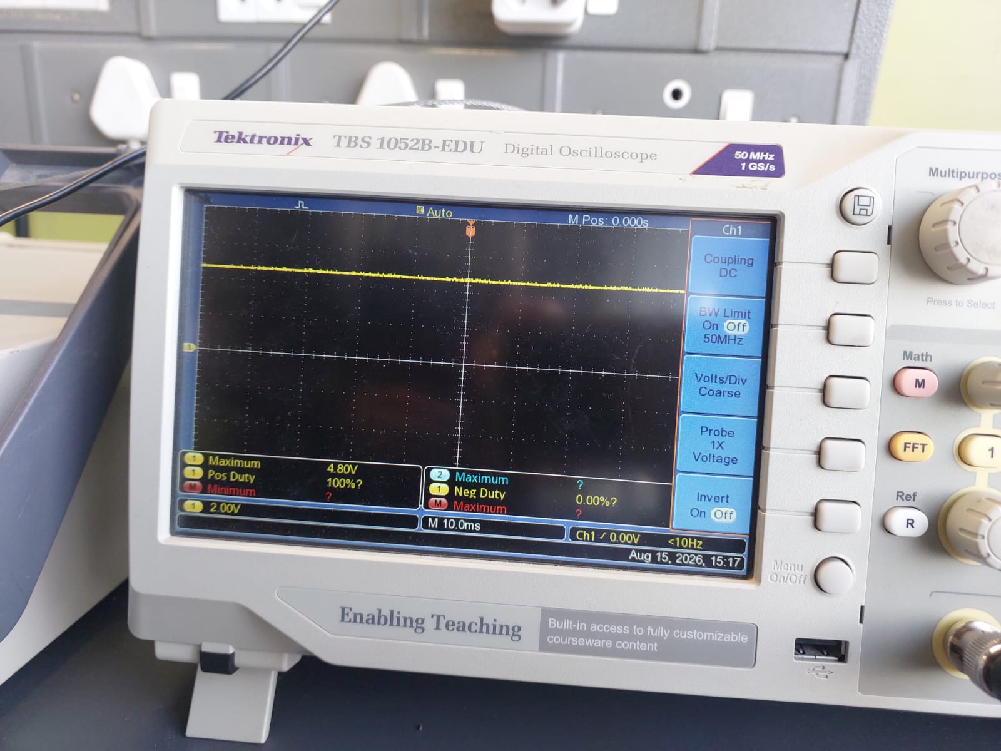
Tests/Power supply test/WhatsApp Image 2026-11-06 at 16.09.14.jpeg
