chanelleblan/SumobotSkripsie/Tests/Power supply test/WhatsApp Image 2026-11-06 at 16.09.16.jpeg

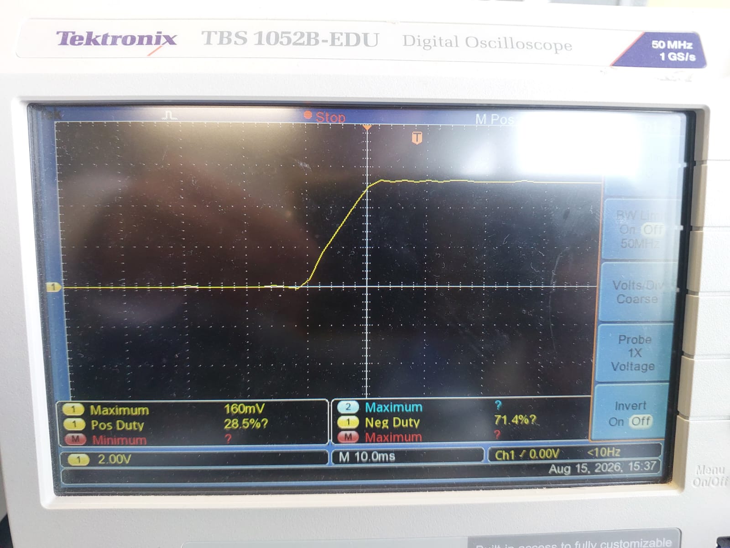
Tests/Power supply test/WhatsApp Image 2026-11-06 at 16.09.16.jpeg
