chanelleblan/SumobotSkripsie/Tests/Speed and startup test/WhatsApp Image 2026-11-06 at 16.53.20.jpeg

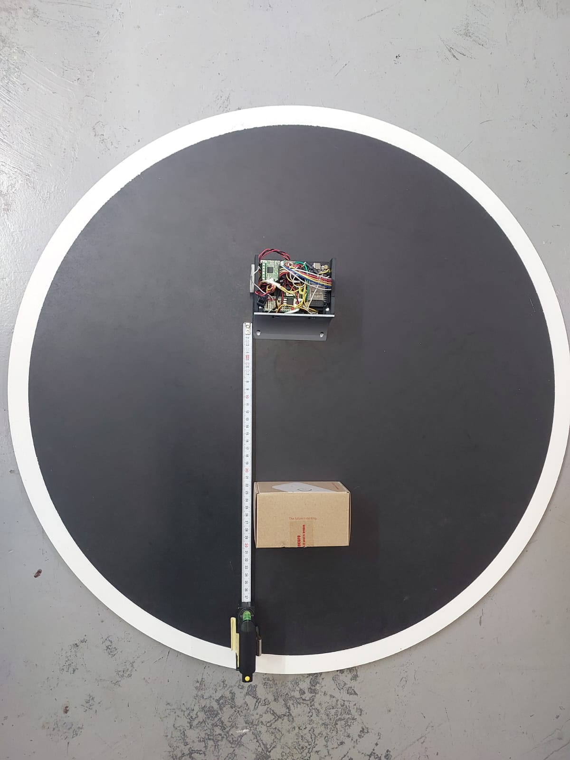
Tests/Speed and startup test/WhatsApp Image 2026-11-06 at 16.53.20.jpeg
