chanelleblan/SumobotSkripsie/Tests/VL53L0x Sensor test/Screenshot 2026-07-27 110443.png

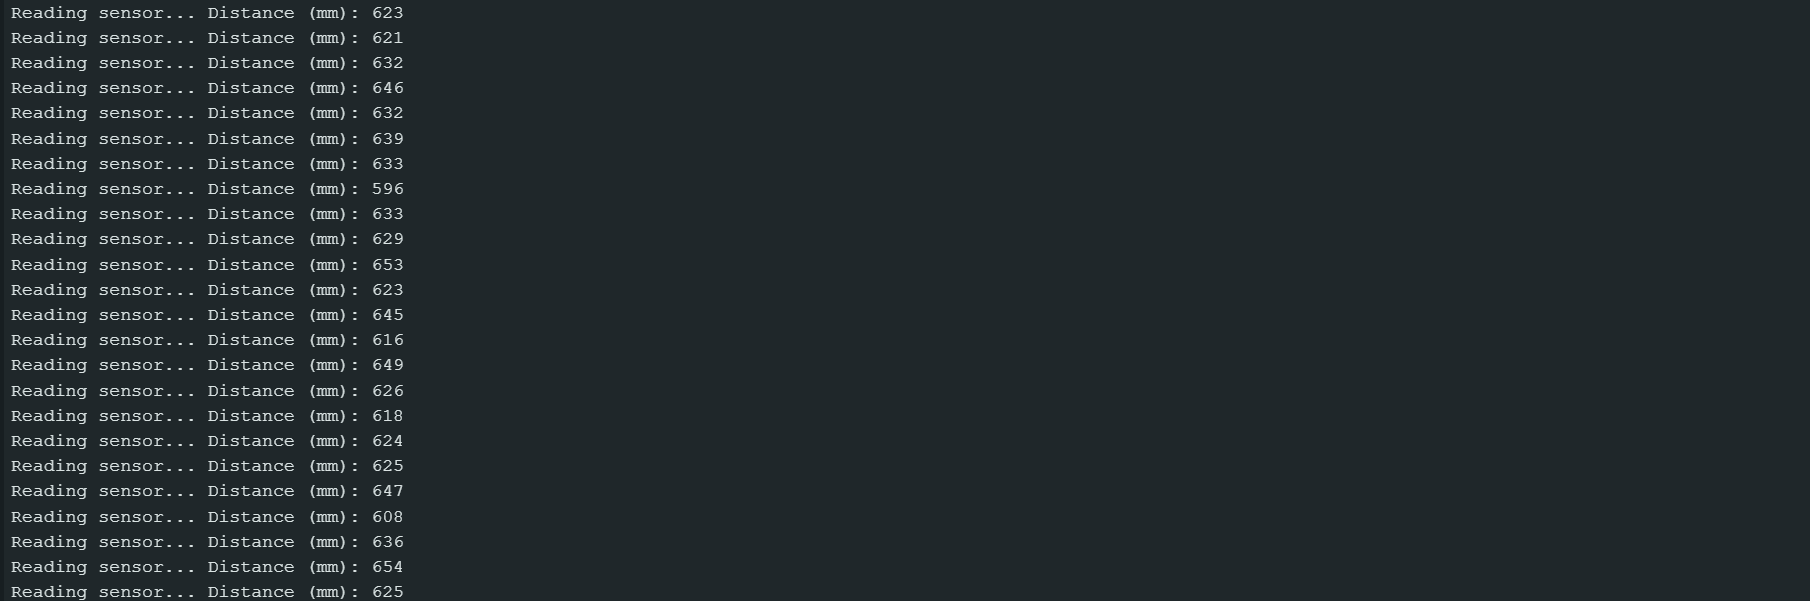
Tests/VL53L0x Sensor test/Screenshot 2026-07-27 110443.png
