chanelleblan/SumobotSkripsie/Tests/VL53L0x Sensor test/Screenshot 2026-07-27 110553.png

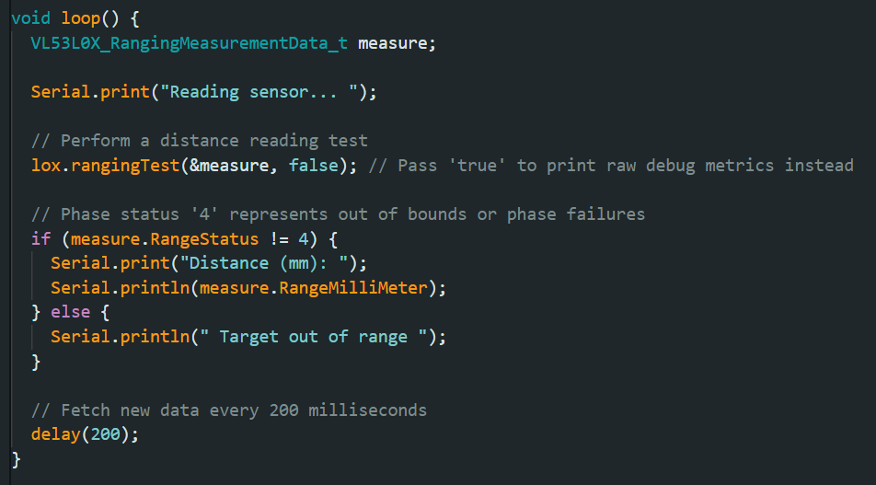
Tests/VL53L0x Sensor test/Screenshot 2026-07-27 110553.png
