chanelleblan/SumobotSkripsie/Tests/VL53L0x Sensor test/WhatsApp Image 2026-11-06 at 16.09.10.jpeg

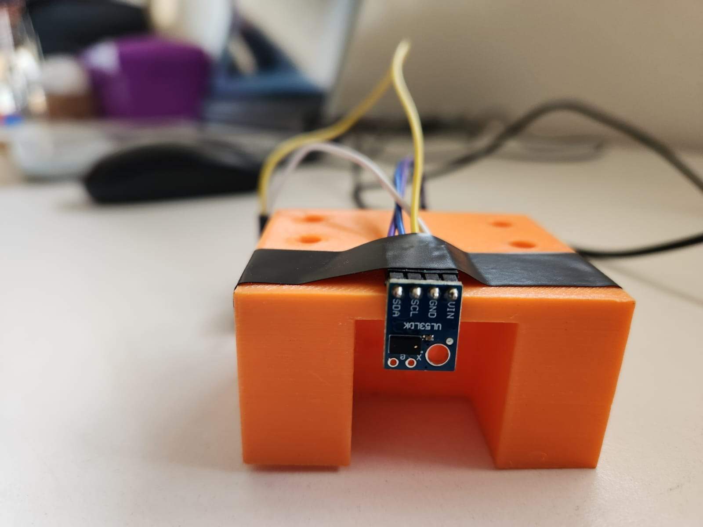
Tests/VL53L0x Sensor test/WhatsApp Image 2026-11-06 at 16.09.10.jpeg
