chanelleblan/SumobotSkripsie/KiCAD/sumobot.pdf

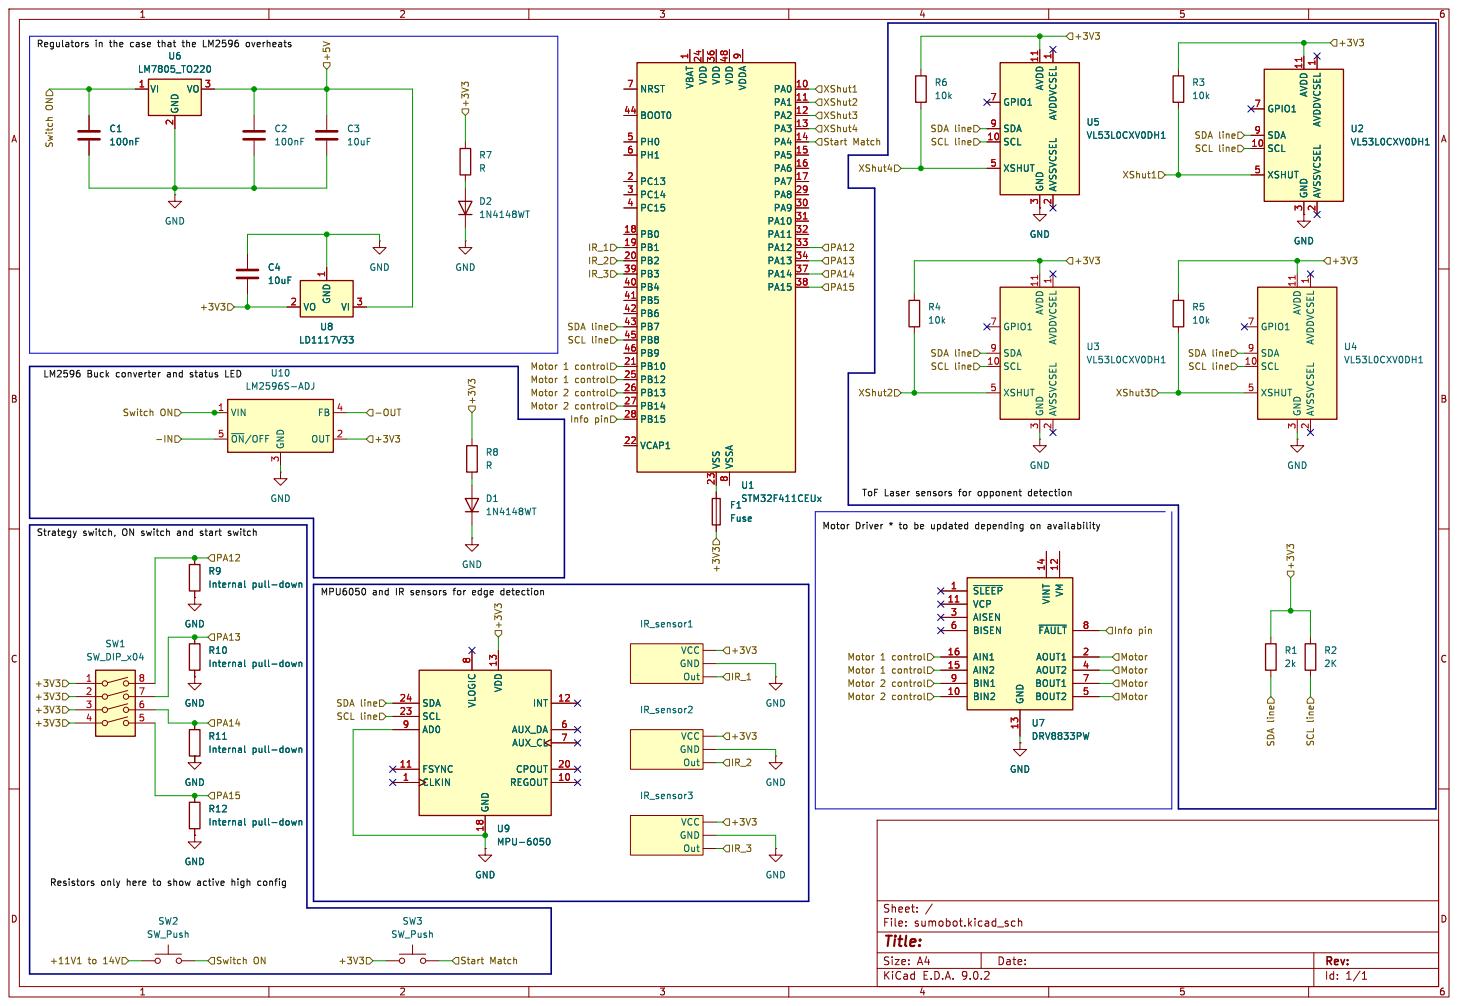
[picture p231: page 1]

9 PA0 10 PA1 11 PA2 12 PA3 13 PA4 14 PA5 15 PA6 16 PA7 17 PA8 29 PA9 30 PA10 31 PA11 32 PA12 33 PA13 34 PA14 37 PA15 38 U1 D1 STM32F411CEUx 1N4148WT R8 R GND GND Out GND

1 VDD 24 VDD 36 VSS 23 VDD 48 VSSA

2 U5VL53L0CXV0DH1 GPIO1 7 SDA 9 SCL 10 XSHUT 5 AVDD 11 GND

2 U2VL53L0CXV0DH1 GPIO1 7 SDA 9 SCL 10 XSHUT 5 AVDD 11 GND

SDA line Motor 1 control IR_2

1 VO 2 U9 MPU-6050 SDA 24 SCL 23 AD0 9 FSYNC 11 CLKIN 1 VLOGIC

SDA line SCL line

Id: 1/1 Title: File: sumobot.kicad_sch Sheet: / R12
