chanelleblan/SumobotSkripsie/Drawing Pack/Drawing_Pack_25929291.pdf

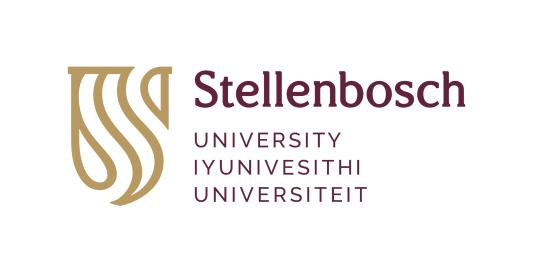
[picture p232: figure]

Copyright © 2026 University of Stellenbosch All rights reserved

Department of Mechanical and Mechatronic Engineering Departement Meganiese en Megatroniese Ingenieurswese Private Bag X1, Privaat Sak X1, Matieland, 7602
Tel: +27 21 808 4204 | www.eng.sun.ac.za

# Sumo Robot

# Drawing Pack

Chanelle Blanche

25929291

October 2026

DRAWING TREE

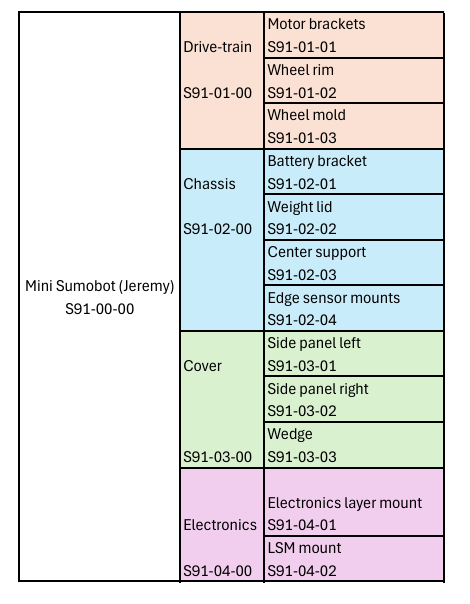
[picture p233: figure]
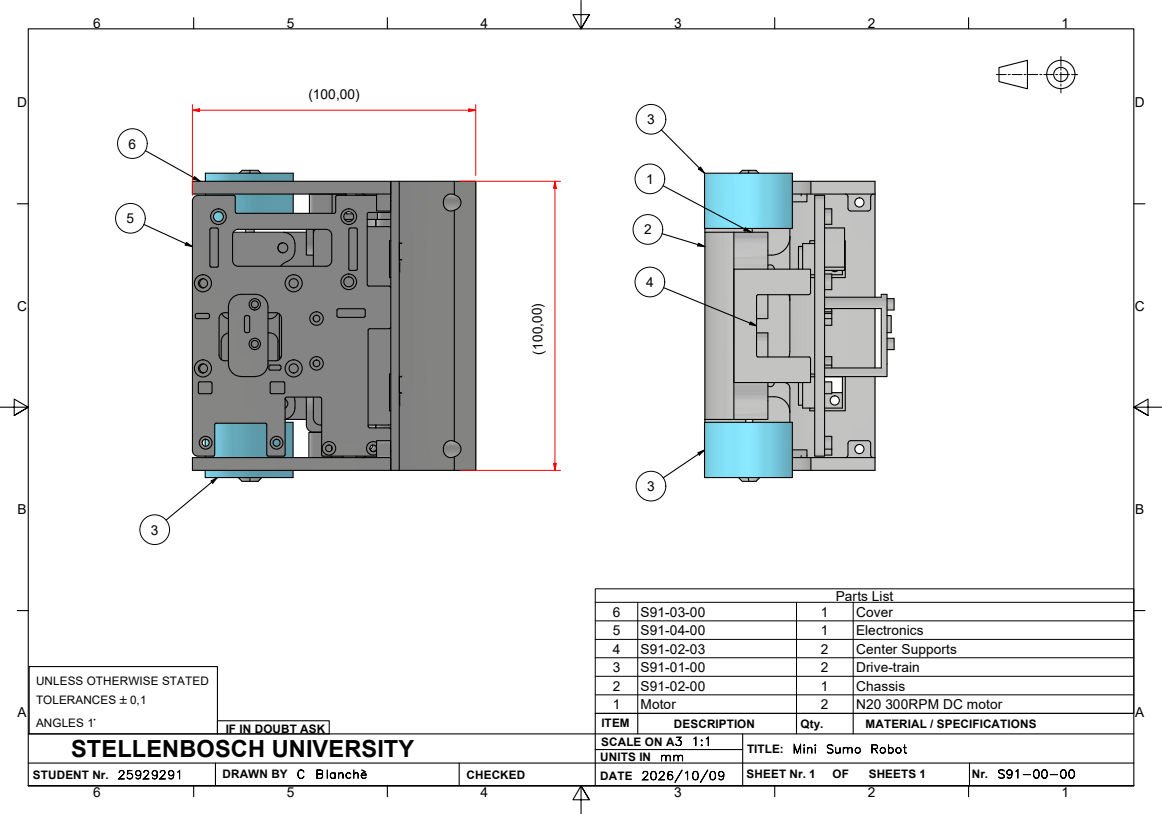
[picture p234: page 3]
Parts List; Motor; N20 300RPM DC motor; STUDENT Nr. 25929291; DRAWN BY C Blanchè; CHECKED; ITEM; DESCRIPTION; Qty.; MATERIAL / SPECIFICATIONS; SHEET Nr. 1; SHEETS 1

6 | S91-03-00 | 1 | Cover
5 | S91-04-00 | 1 | Electronics
4 | S91-02-03 | 2 | Center Supports
3 | S91-01-00 | 2 | Drive-train
2 | S91-02-00 | 1 | Chassis

UNLESS OTHERWISE STATED
TOLERANCES `0,1
ANGLES 1~
STELLENBOSCH UNIVERSITY

SCALE ON A3 1:1
UNITS IN mm
DATE 2026/10/09

IF IN DOUBT ASK

TITLE: Mini Sumo Robot

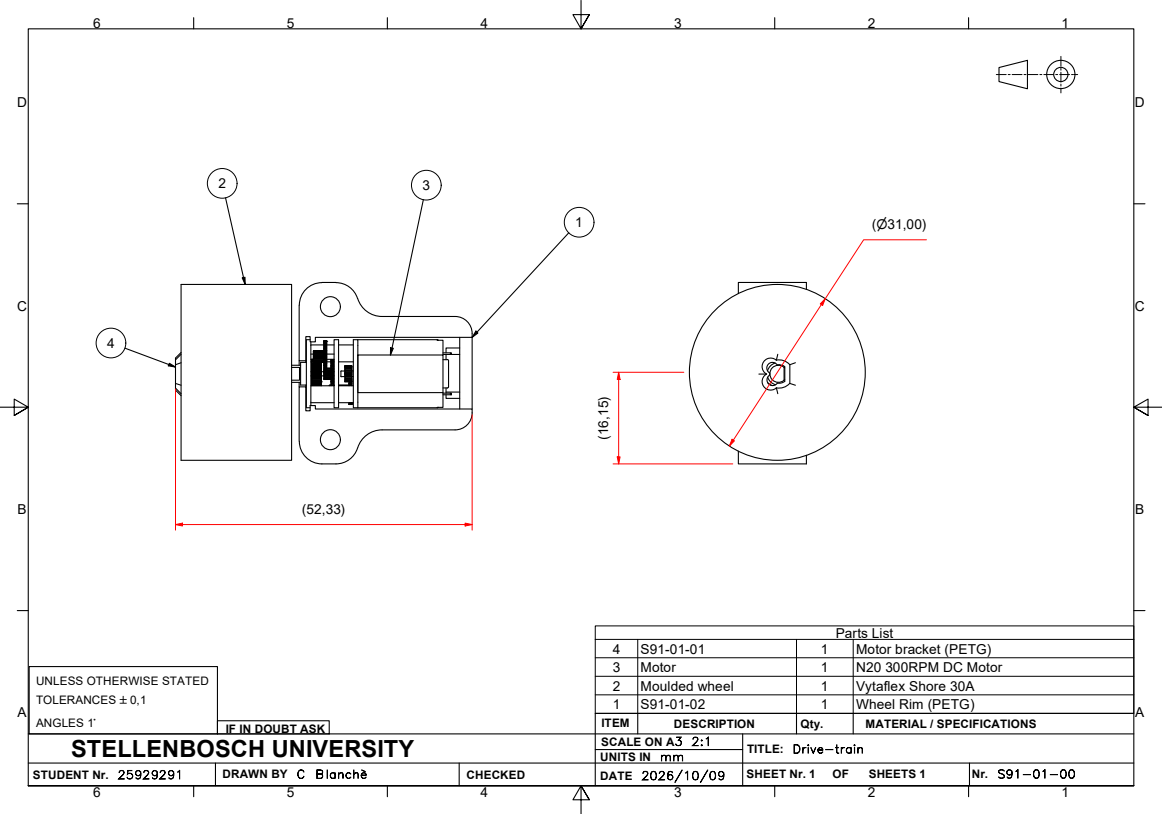
[picture p235: page 4]
Parts List; Wheel Rim (PETG); ITEM; DESCRIPTION; Qty.; MATERIAL / SPECIFICATIONS; SCALE ON A3 2:1; SHEET Nr. 1; SHEETS 1

4 | S91-01-01 | 1 | Motor bracket (PETG)
3 | Motor | 1 | N20 300RPM DC Motor
2 | Moulded wheel | 1 | Vytaflex Shore 30A

UNLESS OTHERWISE STATED
TOLERANCES `0,1
ANGLES 1~
STELLENBOSCH UNIVERSITY

IF IN DOUBT ASK

TITLE: Drive-train

A ( 3 : 1 )

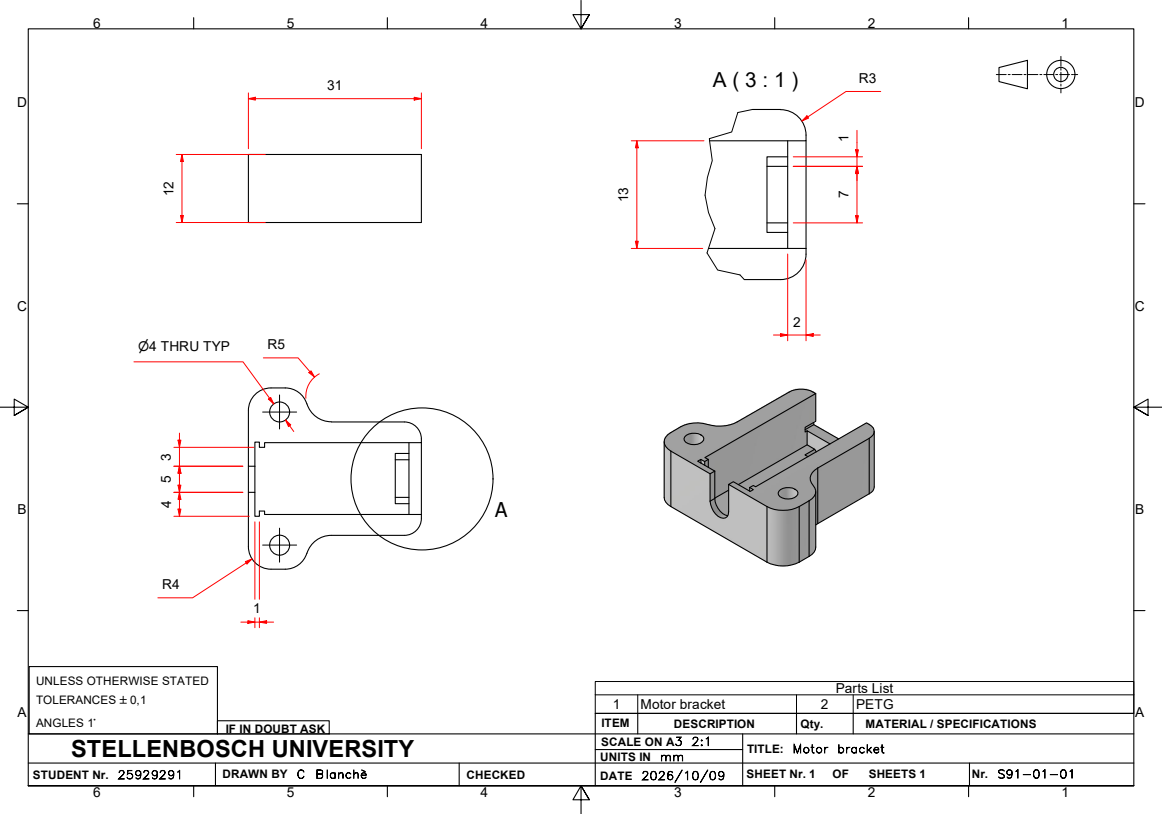
[picture p236: page 5]
Parts List; Motor bracket; PETG; ITEM; DESCRIPTION; Qty.; MATERIAL / SPECIFICATIONS; SCALE ON A3 2:1; SHEET Nr. 1; SHEETS 1; n4 THRU TYP

UNLESS OTHERWISE STATED
TOLERANCES `0,1
ANGLES 1~
STELLENBOSCH UNIVERSITY

IF IN DOUBT ASK

TITLE: Motor bracket

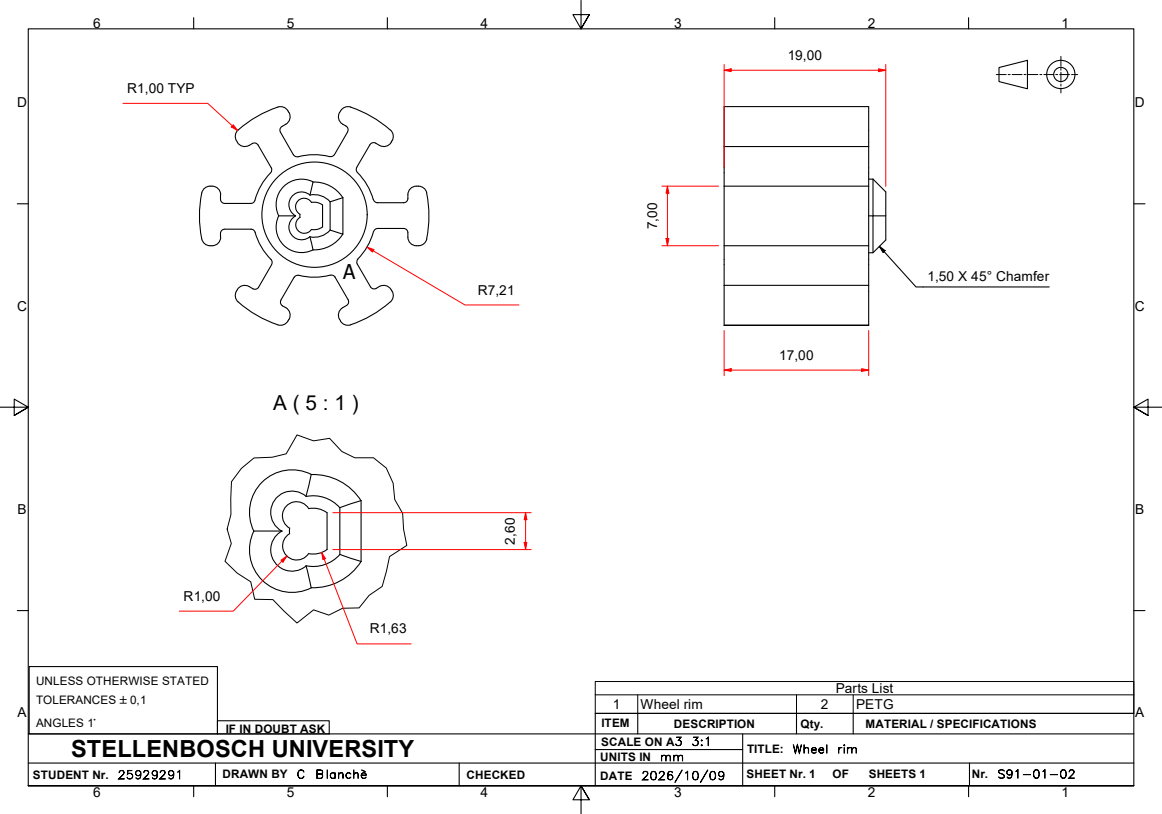
[picture p237: page 6]
Parts List; Wheel rim; PETG; ITEM; DESCRIPTION; Qty.; MATERIAL / SPECIFICATIONS; SCALE ON A3 3:1; SHEET Nr. 1; SHEETS 1; R1,00 TYP; 1,50 X 45° Chamfer

UNLESS OTHERWISE STATED
TOLERANCES `0,1
ANGLES 1~
STELLENBOSCH UNIVERSITY

IF IN DOUBT ASK

TITLE: Wheel rim

A-A ( 2 : 1 )

B ( 3 : 1 )

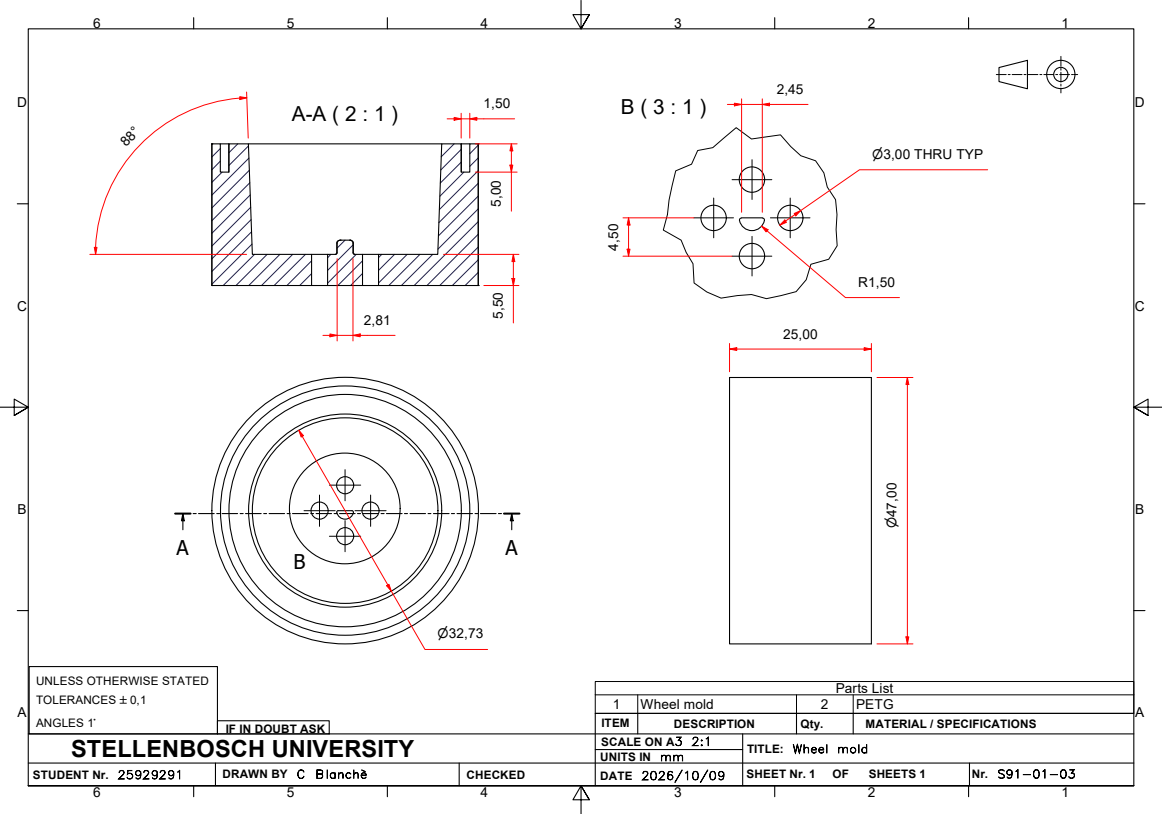
[picture p238: page 7]
Parts List; Wheel mold; PETG; ITEM; DESCRIPTION; Qty.; MATERIAL / SPECIFICATIONS; SCALE ON A3 2:1; SHEET Nr. 1; SHEETS 1; n3,00 THRU TYP

UNLESS OTHERWISE STATED
TOLERANCES `0,1
ANGLES 1~
STELLENBOSCH UNIVERSITY

IF IN DOUBT ASK

TITLE: Wheel mold

( )

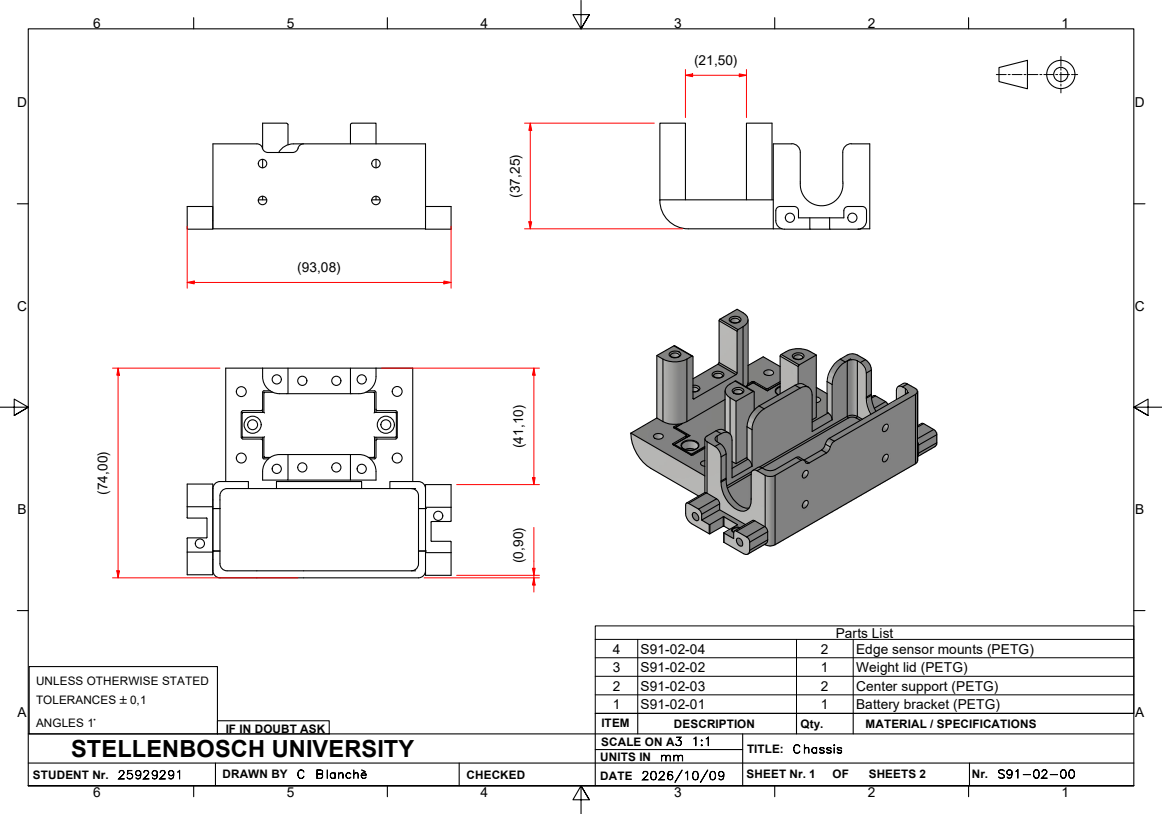
[picture p239: page 8]
Parts List; Battery bracket (PETG); ITEM; DESCRIPTION; Qty.; MATERIAL / SPECIFICATIONS; SCALE ON A3 1:1; SHEET Nr. 1; SHEETS 2; TITLE: Chassis

4 | S91-02-04 | 2 | Edge sensor mounts (PETG)
3 | S91-02-02 | 1 | Weight lid (PETG)
2 | S91-02-03 | 2 | Center support (PETG)

UNLESS OTHERWISE STATED
TOLERANCES `0,1
ANGLES 1~
STELLENBOSCH UNIVERSITY

IF IN DOUBT ASK

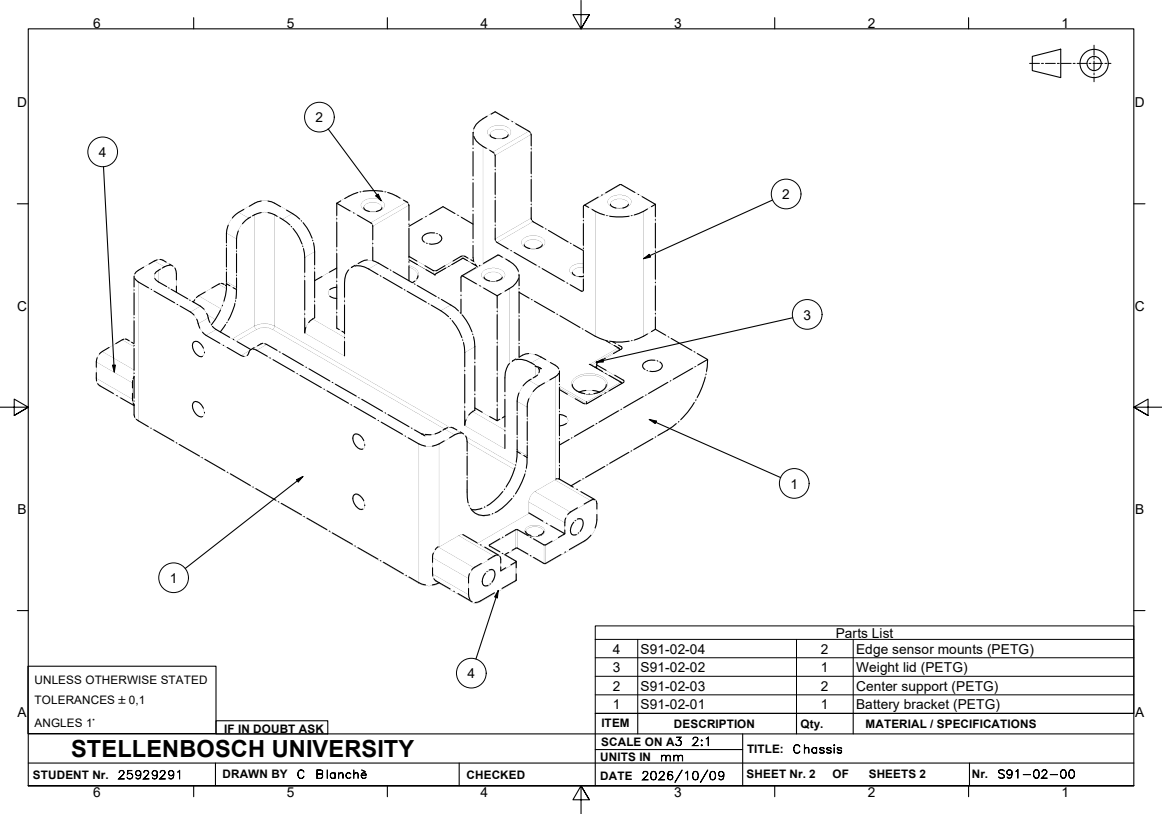
[picture p240: page 9]
Parts List; Battery bracket (PETG); ITEM; DESCRIPTION; Qty.; MATERIAL / SPECIFICATIONS; SCALE ON A3 2:1; SHEET Nr. 2; SHEETS 2; TITLE: Chassis

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

UNLESS OTHERWISE STATED
TOLERANCES `0,1
ANGLES 1~
STELLENBOSCH UNIVERSITY

IF IN DOUBT ASK

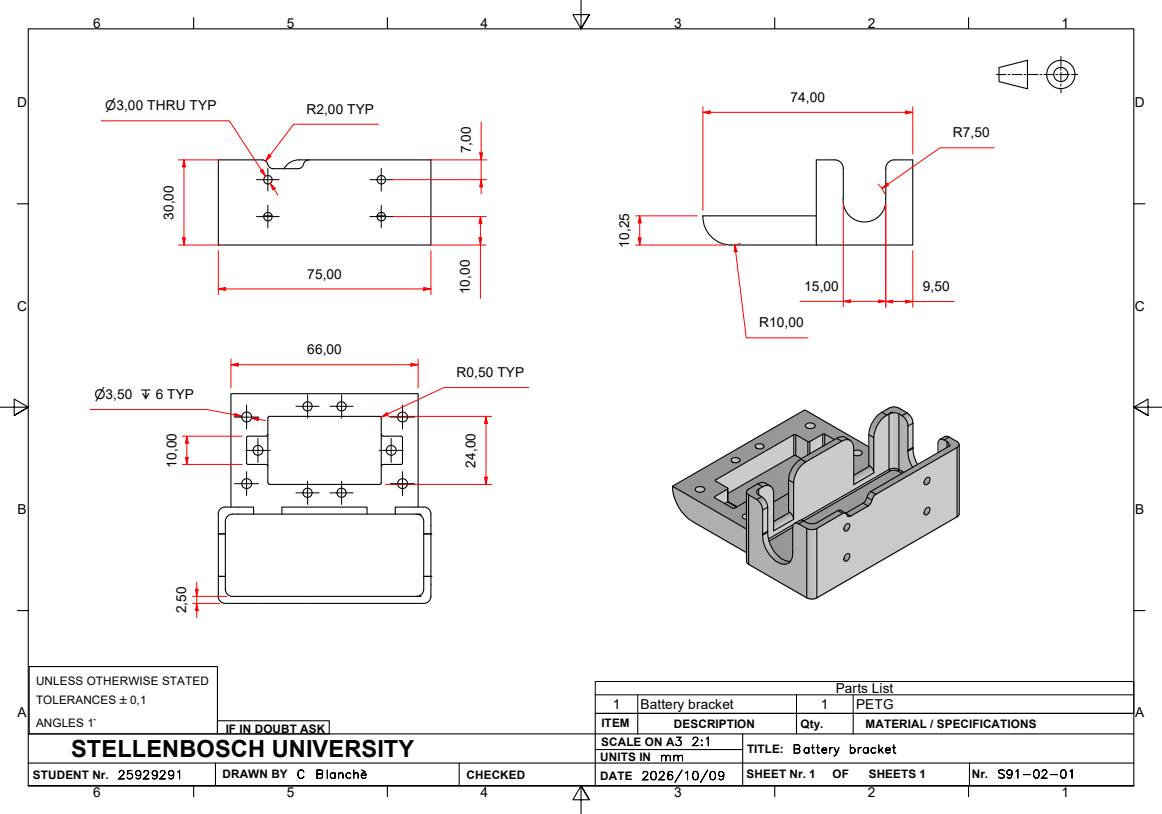
[picture p241: page 10]
Parts List; Battery bracket; PETG; ITEM; DESCRIPTION; Qty.; MATERIAL / SPECIFICATIONS; SCALE ON A3 2:1; SHEET Nr. 1; SHEETS 1; n3,00 THRU TYP; R2,00 TYP; n3,50 x 6 TYP; R0,50 TYP

UNLESS OTHERWISE STATED
TOLERANCES `0,1
ANGLES 1~
STELLENBOSCH UNIVERSITY

IF IN DOUBT ASK

TITLE: Battery bracket

A | A

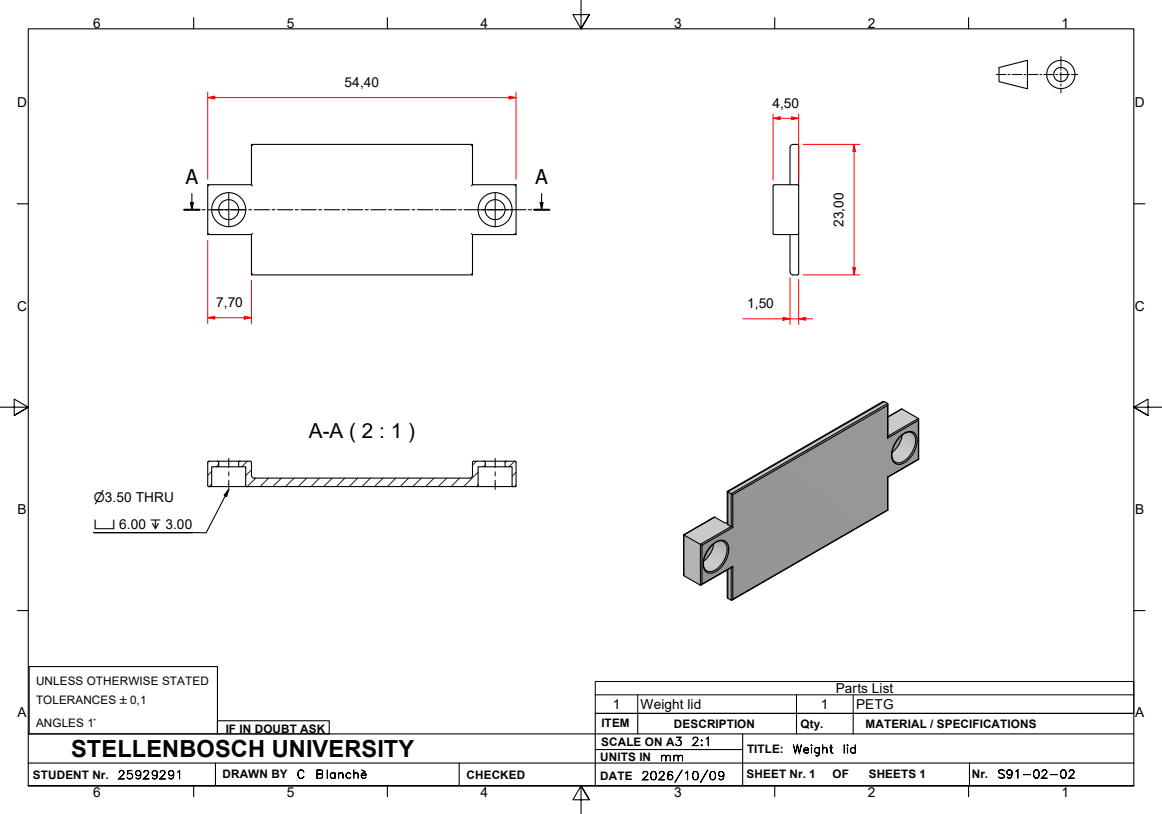
[picture p242: page 11]
Parts List; Weight lid; PETG; ITEM; DESCRIPTION; Qty.; MATERIAL / SPECIFICATIONS; SCALE ON A3 2:1; SHEET Nr. 1; SHEETS 1; n3.50 THRU

UNLESS OTHERWISE STATED
TOLERANCES `0,1
ANGLES 1~
STELLENBOSCH UNIVERSITY

IF IN DOUBT ASK

TITLE: Weight lid

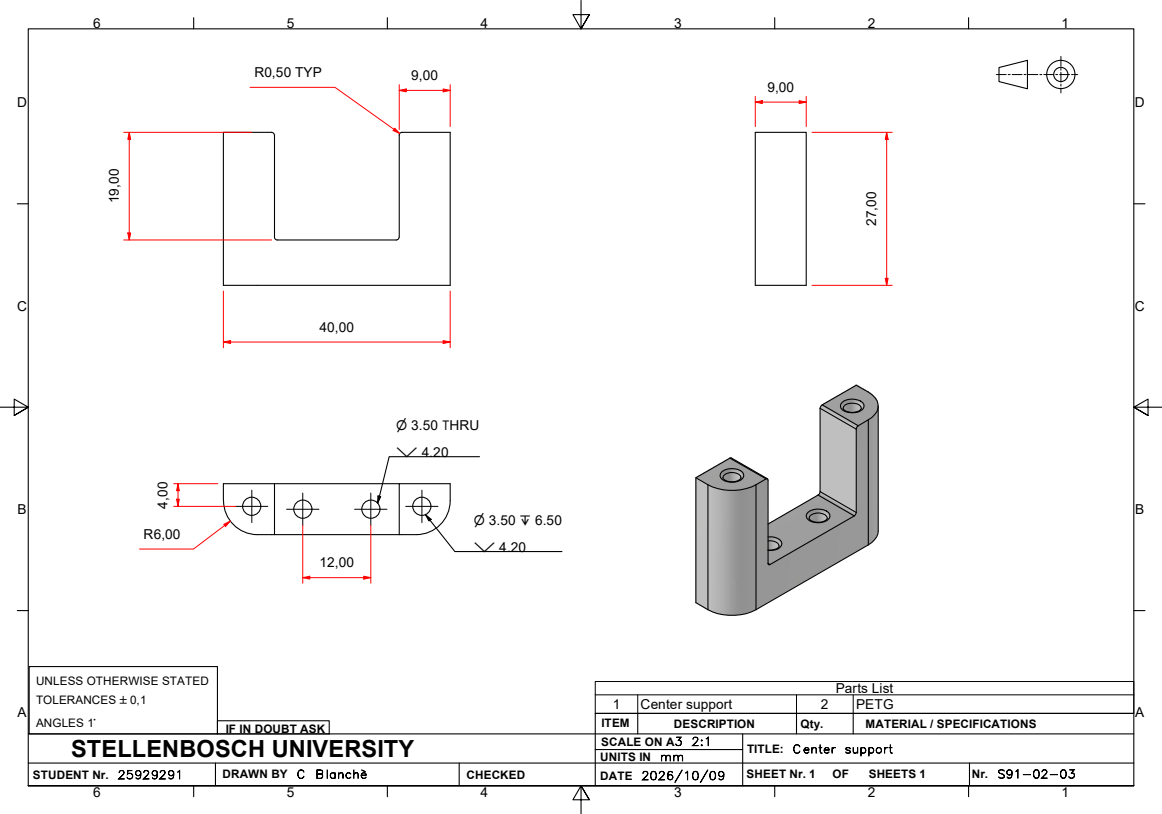
[picture p243: page 12]
Parts List; Center support; PETG; ITEM; DESCRIPTION; Qty.; MATERIAL / SPECIFICATIONS; SCALE ON A3 2:1; SHEET Nr. 1; SHEETS 1; R0,50 TYP; n 3.50 THRU

UNLESS OTHERWISE STATED
TOLERANCES `0,1
ANGLES 1~
STELLENBOSCH UNIVERSITY

IF IN DOUBT ASK

TITLE: Center support

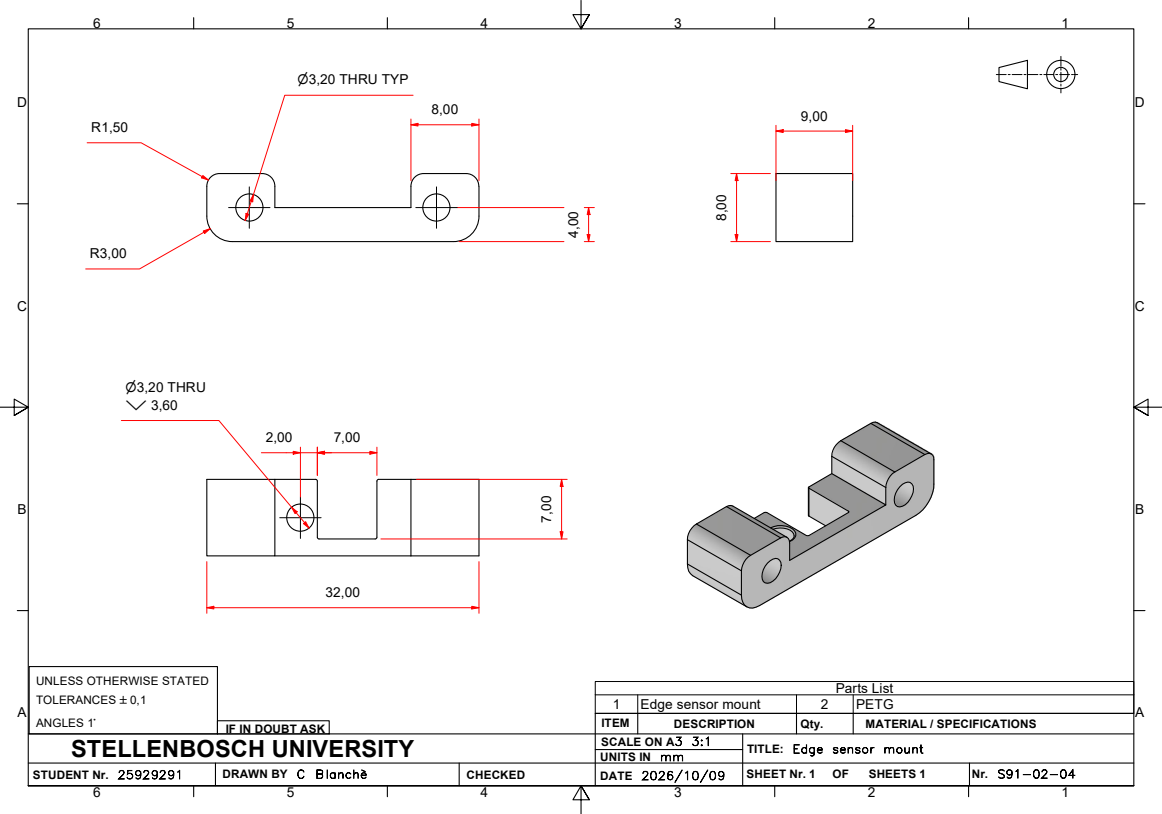
[picture p244: page 13]
Parts List; Edge sensor mount; PETG; ITEM; DESCRIPTION; Qty.; MATERIAL / SPECIFICATIONS; SCALE ON A3 3:1; SHEET Nr. 1; SHEETS 1; n3,20 THRU TYP; n3,20 THRU w 3,60

UNLESS OTHERWISE STATED
TOLERANCES `0,1
ANGLES 1~
STELLENBOSCH UNIVERSITY

IF IN DOUBT ASK

TITLE: Edge sensor mount

A-A ( 1 : 1 )
A

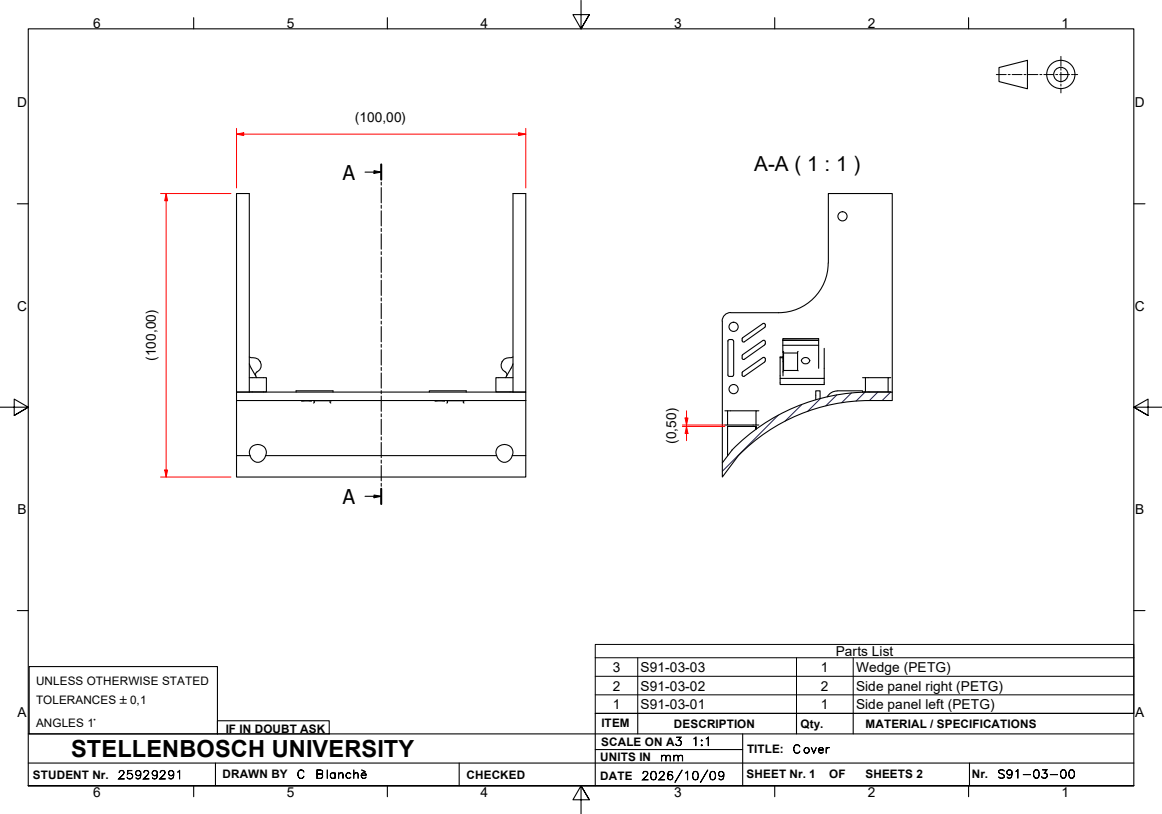
[picture p245: page 14]
Parts List; Side panel left (PETG); ITEM; DESCRIPTION; Qty.; MATERIAL / SPECIFICATIONS; SCALE ON A3 1:1; SHEET Nr. 1; SHEETS 2; TITLE: Cover

3 | S91-03-03 | 1 | Wedge (PETG)
2 | S91-03-02 | 2 | Side panel right (PETG)

UNLESS OTHERWISE STATED
TOLERANCES `0,1
ANGLES 1~
STELLENBOSCH UNIVERSITY

IF IN DOUBT ASK

A ( 2 : 1 )

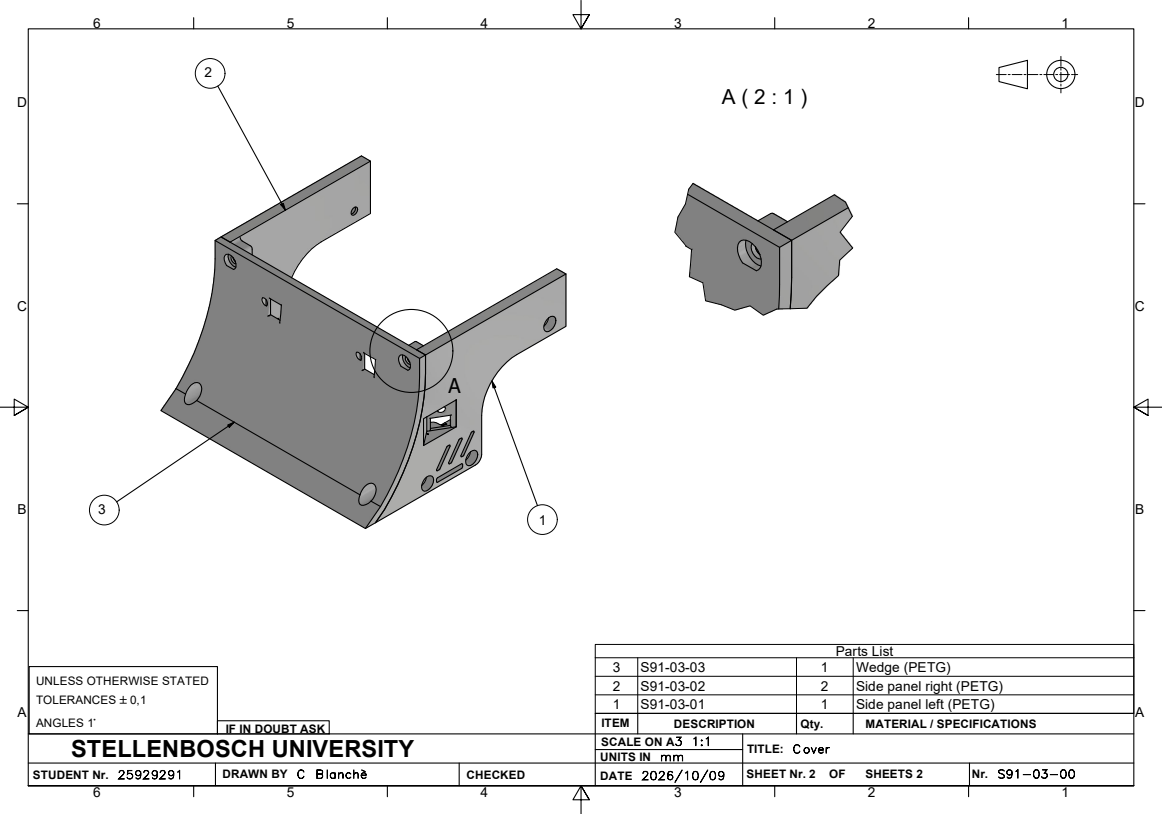
[picture p246: page 15]
Parts List; Side panel left (PETG); ITEM; DESCRIPTION; Qty.; MATERIAL / SPECIFICATIONS; SCALE ON A3 1:1; SHEET Nr. 2; SHEETS 2; TITLE: Cover

3 | S91-03-03 | 1 | Wedge (PETG)
2 | S91-03-02 | 2 | Side panel right (PETG)

UNLESS OTHERWISE STATED
TOLERANCES `0,1
ANGLES 1~
STELLENBOSCH UNIVERSITY

IF IN DOUBT ASK

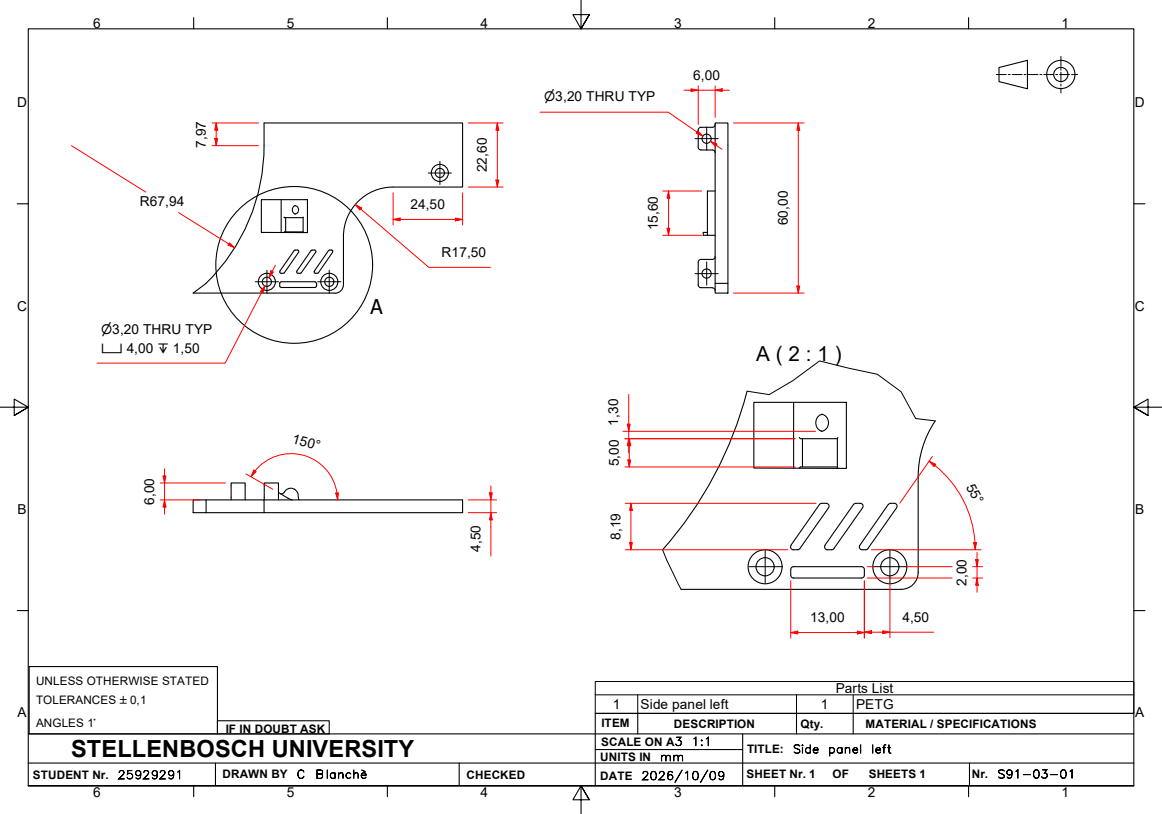
[picture p247: page 16]
Parts List; Side panel left; PETG; ITEM; DESCRIPTION; Qty.; MATERIAL / SPECIFICATIONS; SCALE ON A3 1:1; SHEET Nr. 1; SHEETS 1; n3,20 THRU TYP v 4,00 x 1,50; n3,20 THRU TYP

UNLESS OTHERWISE STATED
TOLERANCES `0,1
ANGLES 1~
STELLENBOSCH UNIVERSITY

IF IN DOUBT ASK

TITLE: Side panel left

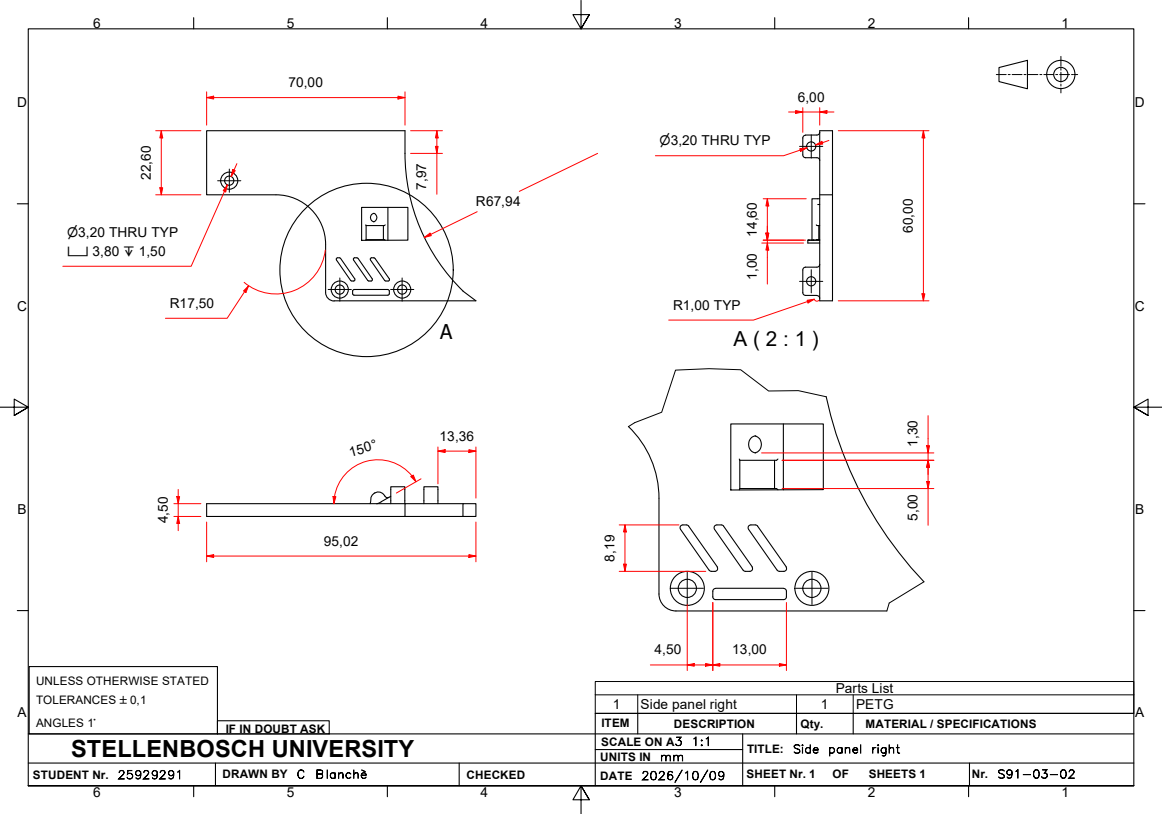
[picture p248: page 17]
Parts List; Side panel right; PETG; ITEM; DESCRIPTION; Qty.; MATERIAL / SPECIFICATIONS; SCALE ON A3 1:1; SHEET Nr. 1; SHEETS 1; n3,20 THRU TYP; R1,00 TYP; n3,20 THRU TYP v 3,80 x 1,50

UNLESS OTHERWISE STATED
TOLERANCES `0,1
ANGLES 1~
STELLENBOSCH UNIVERSITY

IF IN DOUBT ASK

TITLE: Side panel right

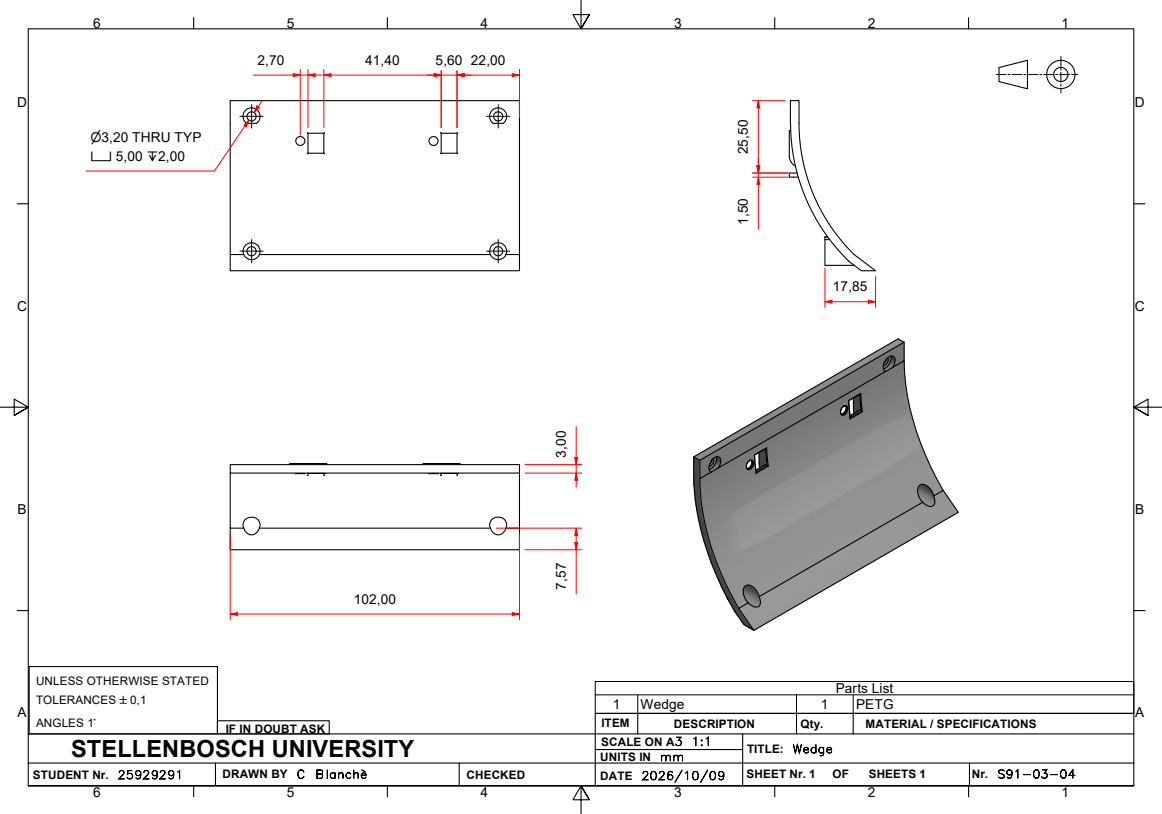
[picture p249: page 18]
Parts List; Wedge; PETG; ITEM; DESCRIPTION; Qty.; MATERIAL / SPECIFICATIONS; SCALE ON A3 1:1; SHEET Nr. 1; SHEETS 1; TITLE: Wedge; n3,20 THRU TYP v 5,00 x2,00

UNLESS OTHERWISE STATED
TOLERANCES `0,1
ANGLES 1~
STELLENBOSCH UNIVERSITY

IF IN DOUBT ASK

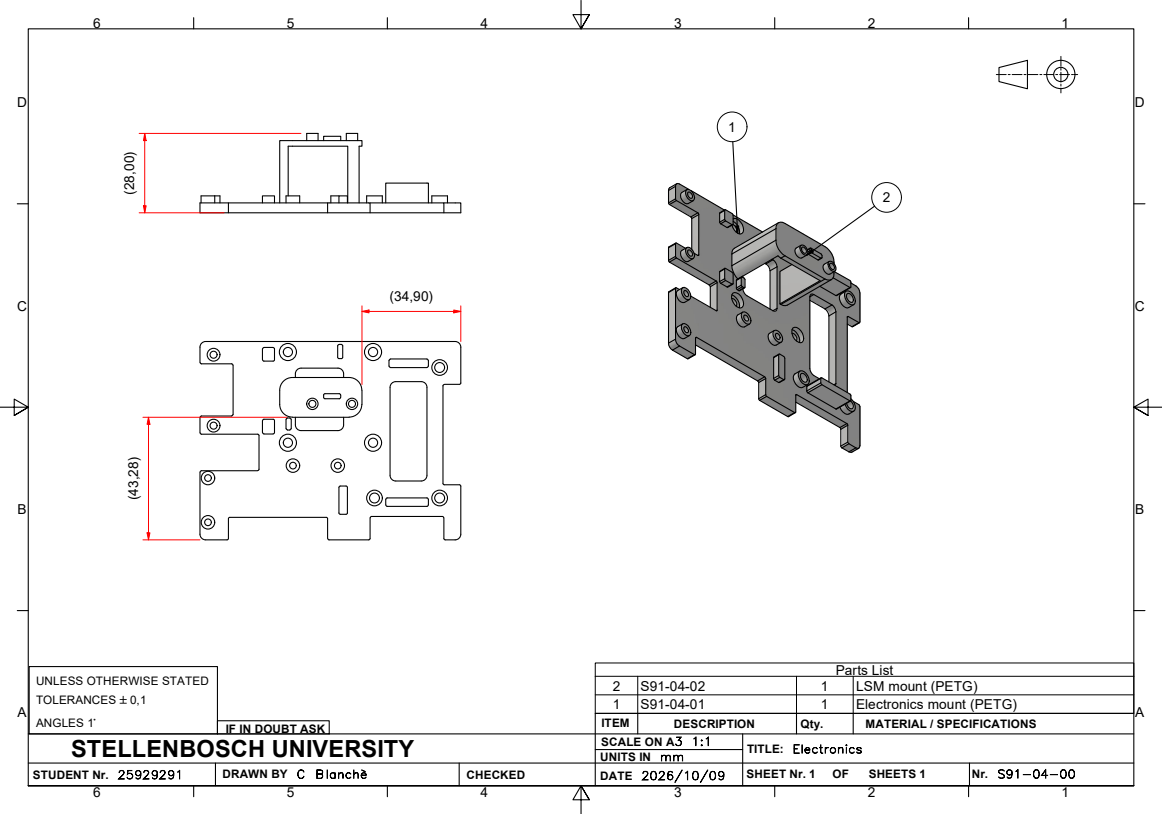
[picture p250: page 19]
Parts List; LSM mount (PETG); Electronics mount (PETG); ITEM; DESCRIPTION; Qty.; MATERIAL / SPECIFICATIONS; SCALE ON A3 1:1; SHEET Nr. 1; SHEETS 1; TITLE: Electronics

UNLESS OTHERWISE STATED
TOLERANCES `0,1
ANGLES 1~
STELLENBOSCH UNIVERSITY

IF IN DOUBT ASK

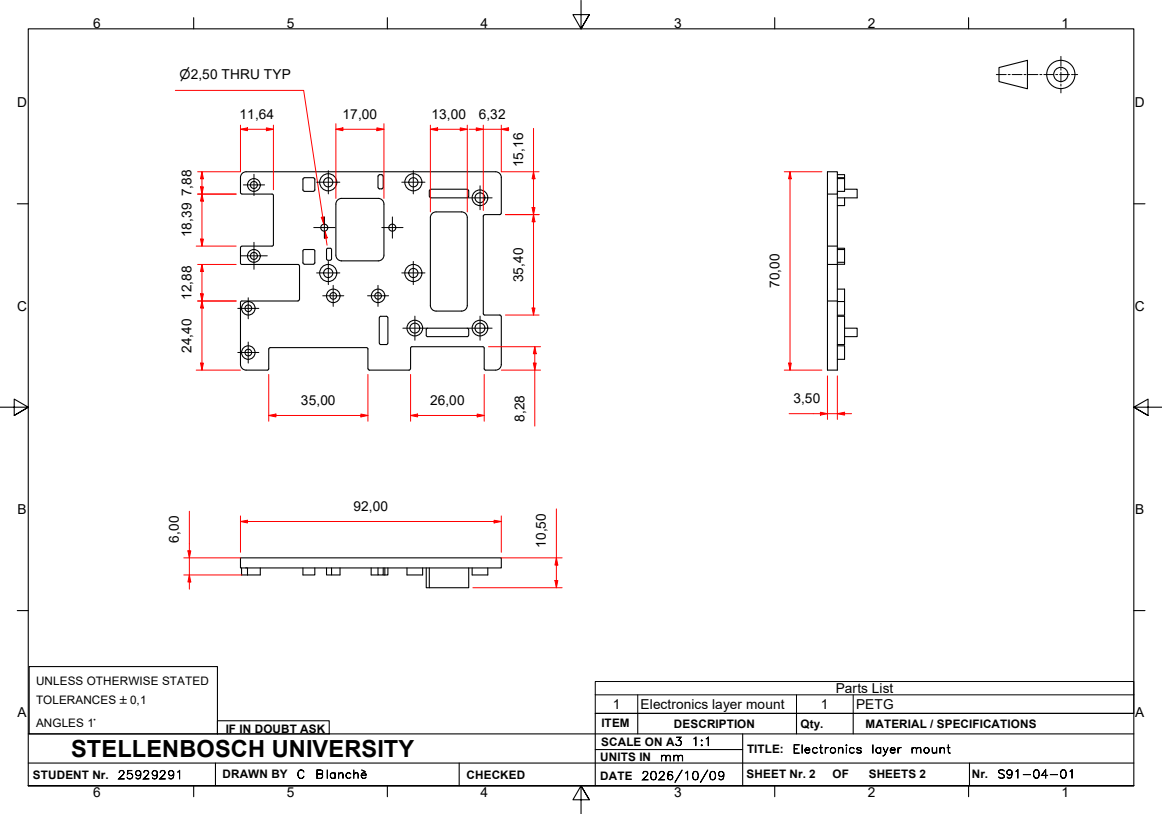
[picture p251: page 20]
Parts List; Electronics layer mount; PETG; ITEM; DESCRIPTION; Qty.; MATERIAL / SPECIFICATIONS; SCALE ON A3 1:1; SHEET Nr. 2; SHEETS 2; n2,50 THRU TYP

UNLESS OTHERWISE STATED
TOLERANCES `0,1
ANGLES 1~
STELLENBOSCH UNIVERSITY

IF IN DOUBT ASK

TITLE: Electronics layer mount

A ( 2 : 1 )

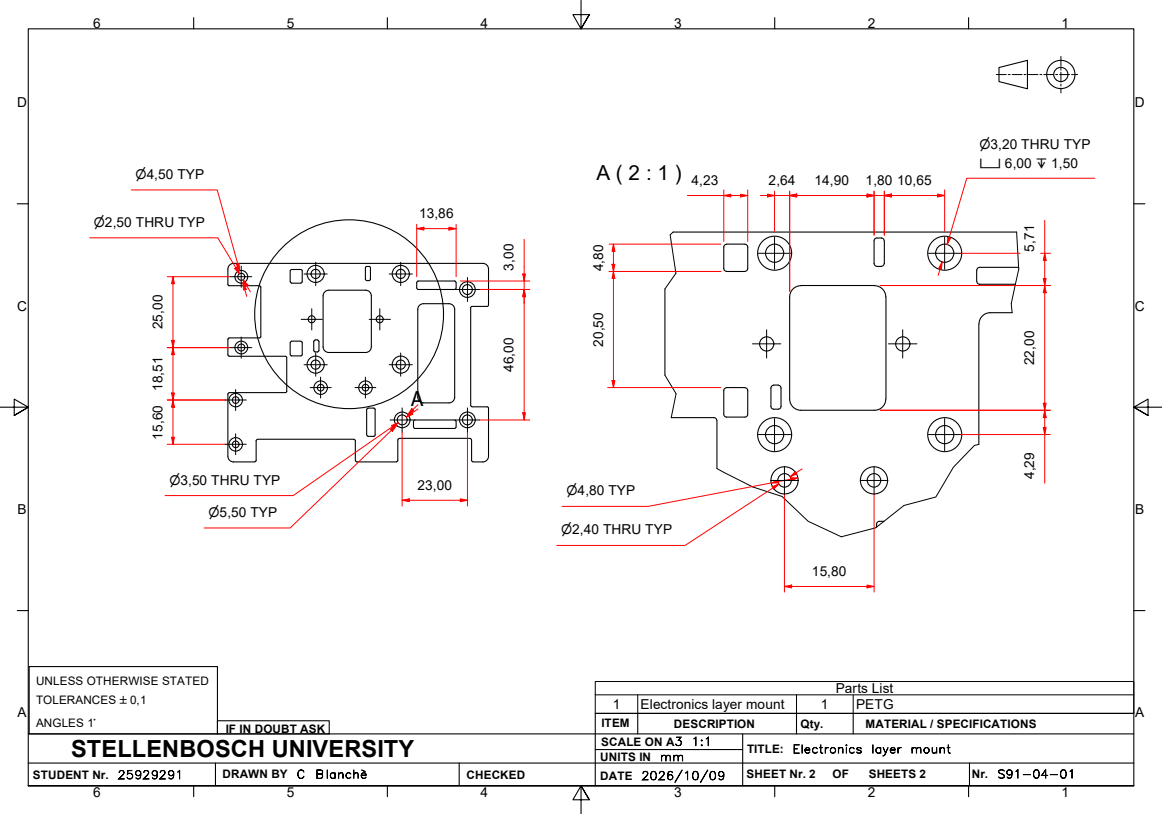
[picture p252: page 21]
Parts List; Electronics layer mount; PETG; ITEM; DESCRIPTION; Qty.; MATERIAL / SPECIFICATIONS; SCALE ON A3 1:1; SHEET Nr. 2; SHEETS 2; n2,50 THRU TYP; n4,50 TYP; n3,50 THRU TYP; n5,50 TYP; n2,40 THRU TYP; n4,80 TYP; n3,20 THRU TYP v 6,00 x 1,50

UNLESS OTHERWISE STATED
TOLERANCES `0,1
ANGLES 1~
STELLENBOSCH UNIVERSITY

IF IN DOUBT ASK

TITLE: Electronics layer mount

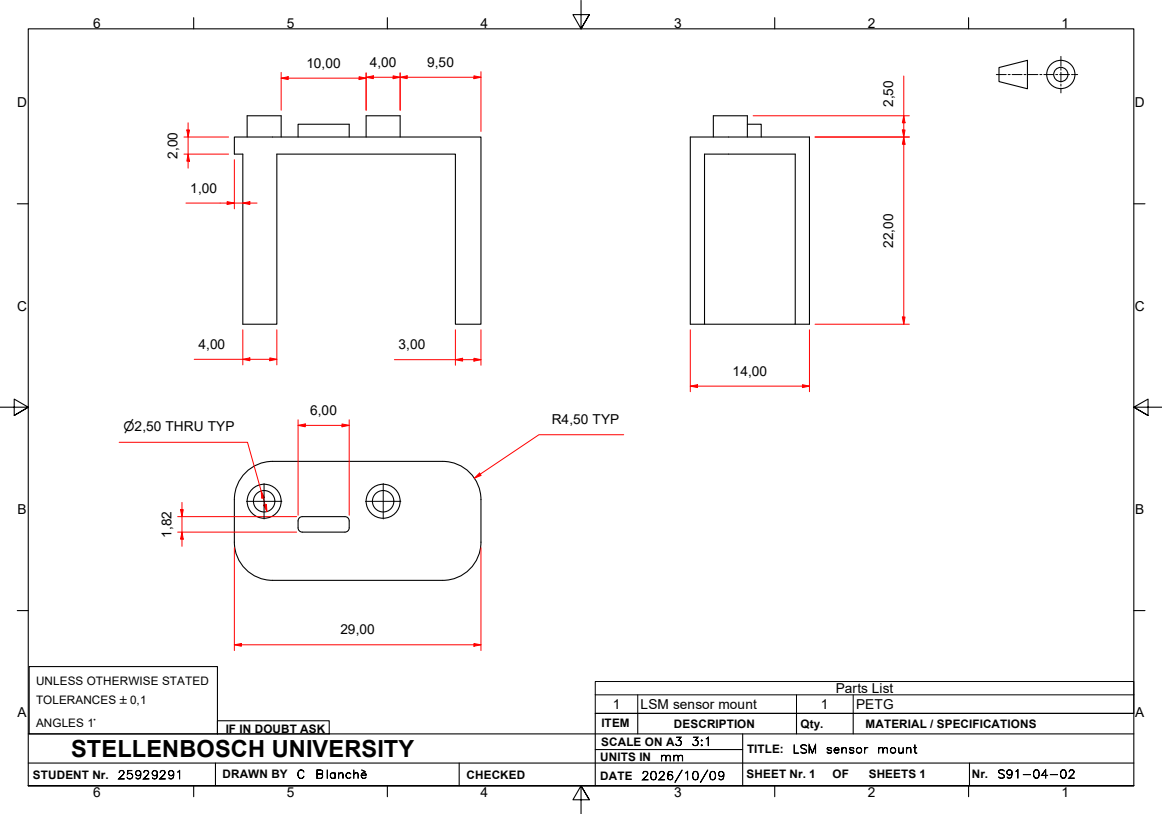
[picture p253: page 22]
Parts List; LSM sensor mount; PETG; ITEM; DESCRIPTION; Qty.; MATERIAL / SPECIFICATIONS; SCALE ON A3 3:1; SHEET Nr. 1; SHEETS 1; R4,50 TYP; n2,50 THRU TYP

UNLESS OTHERWISE STATED
TOLERANCES `0,1
ANGLES 1~
STELLENBOSCH UNIVERSITY

IF IN DOUBT ASK

TITLE: LSM sensor mount
