chanelleblan/SumobotSkripsie/KiCAD/Schematic_V6.pdf

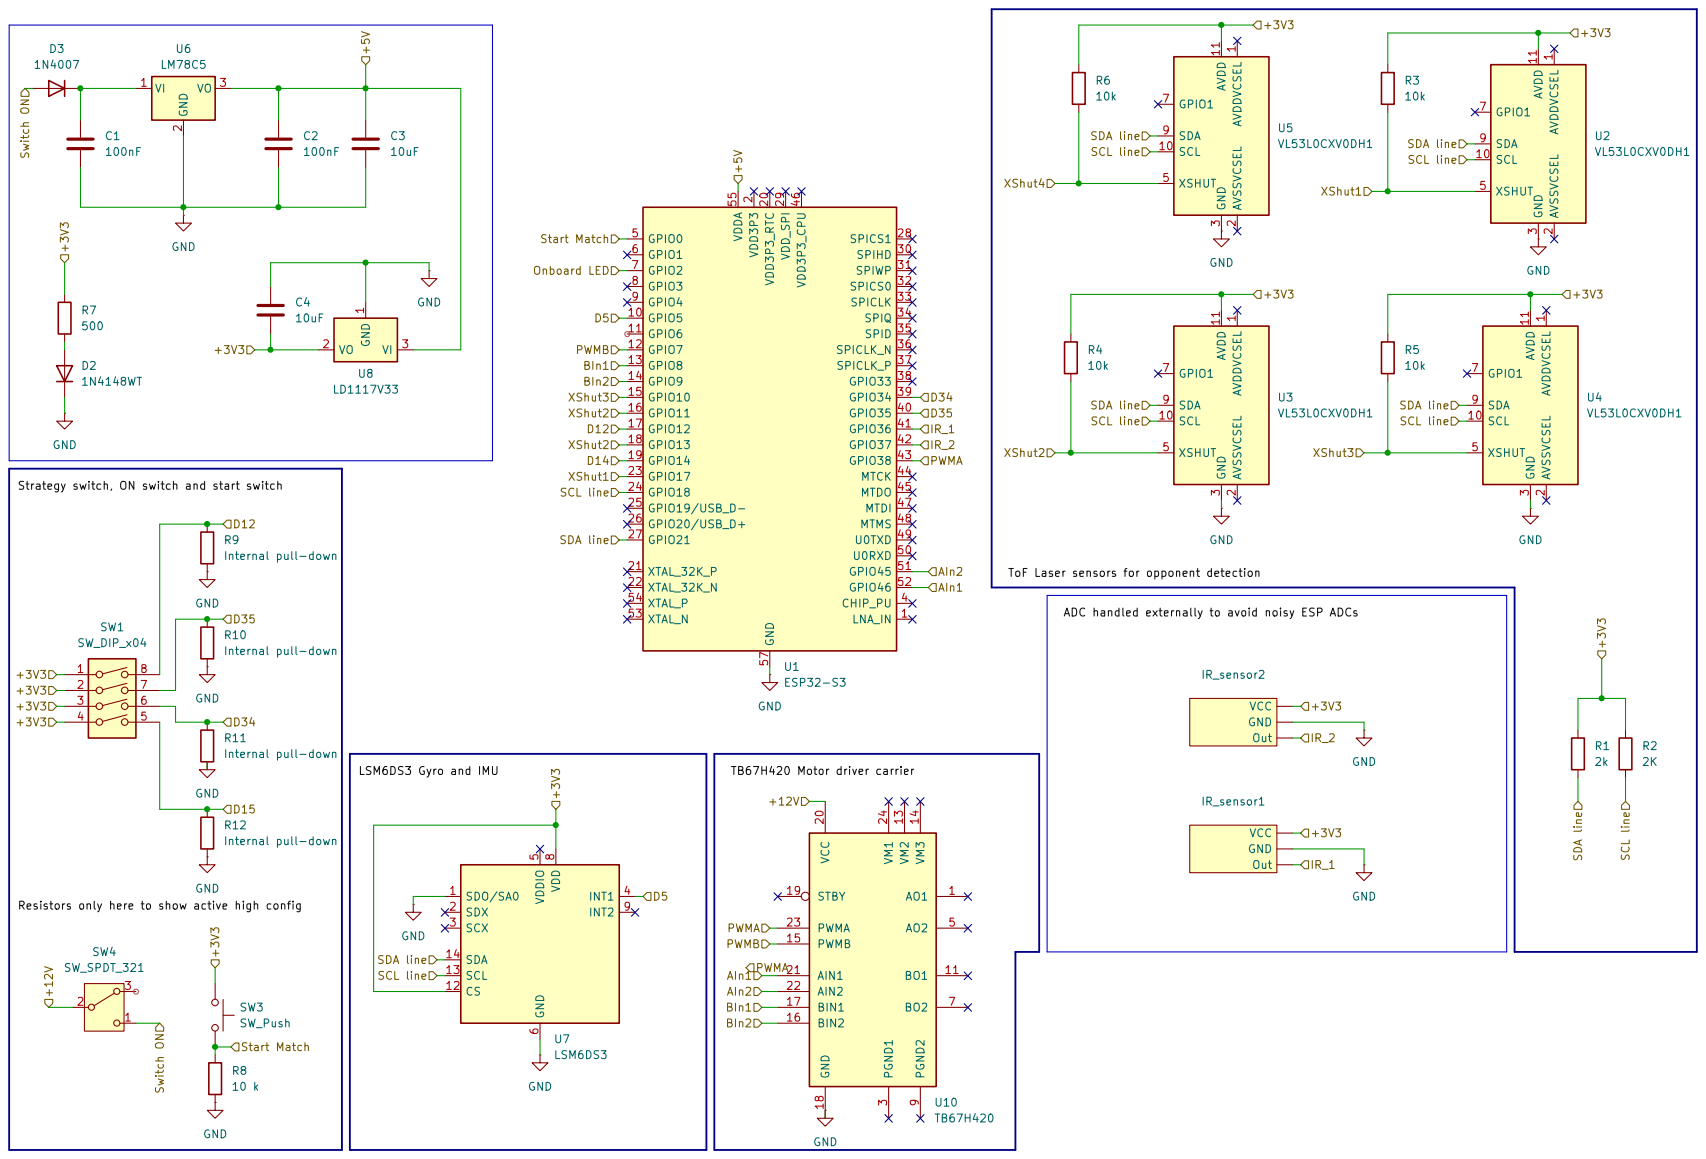
[picture p254: page 1]
