chanelleblan/SumobotSkripsie/KiCAD/V3.pdf

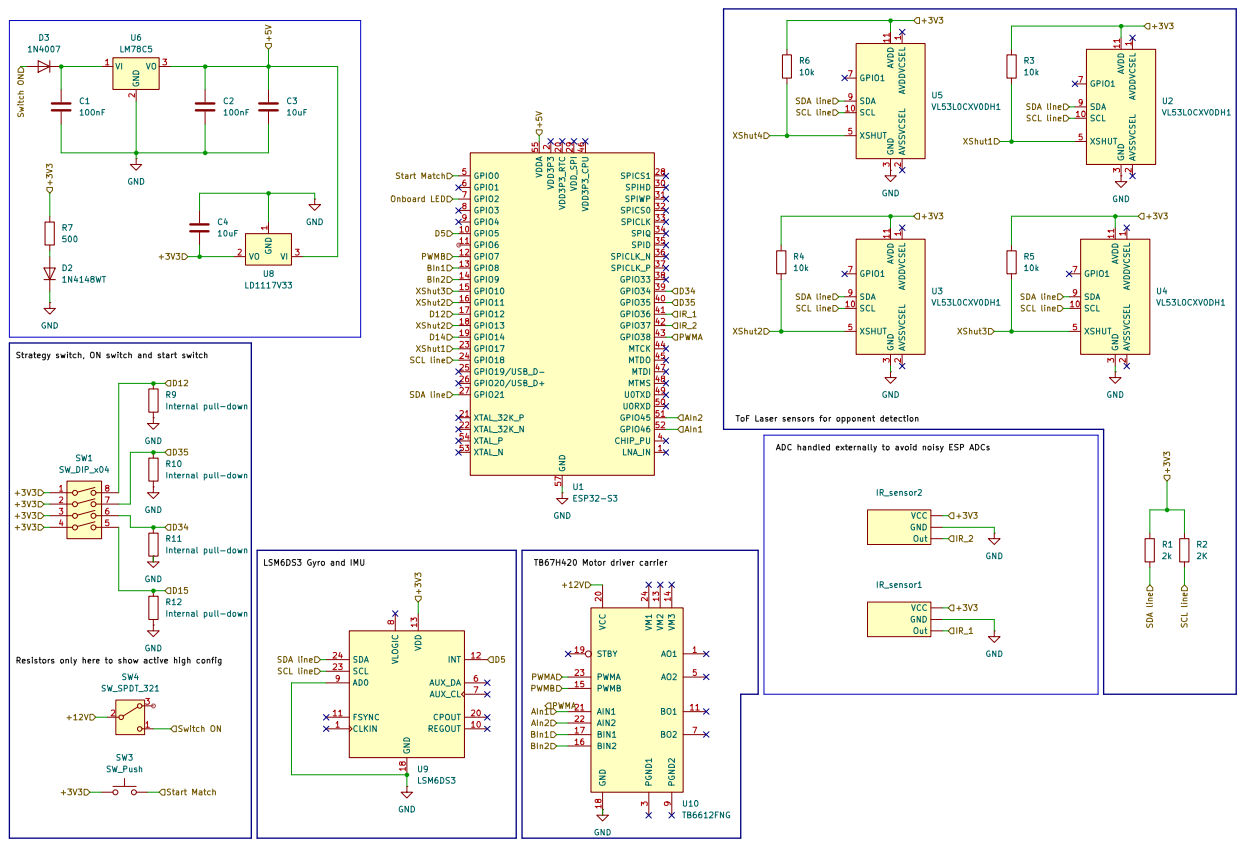
[picture p255: page 1]
