chanelleblan/SumobotSkripsie/KiCAD/Schematic_v1.pdf

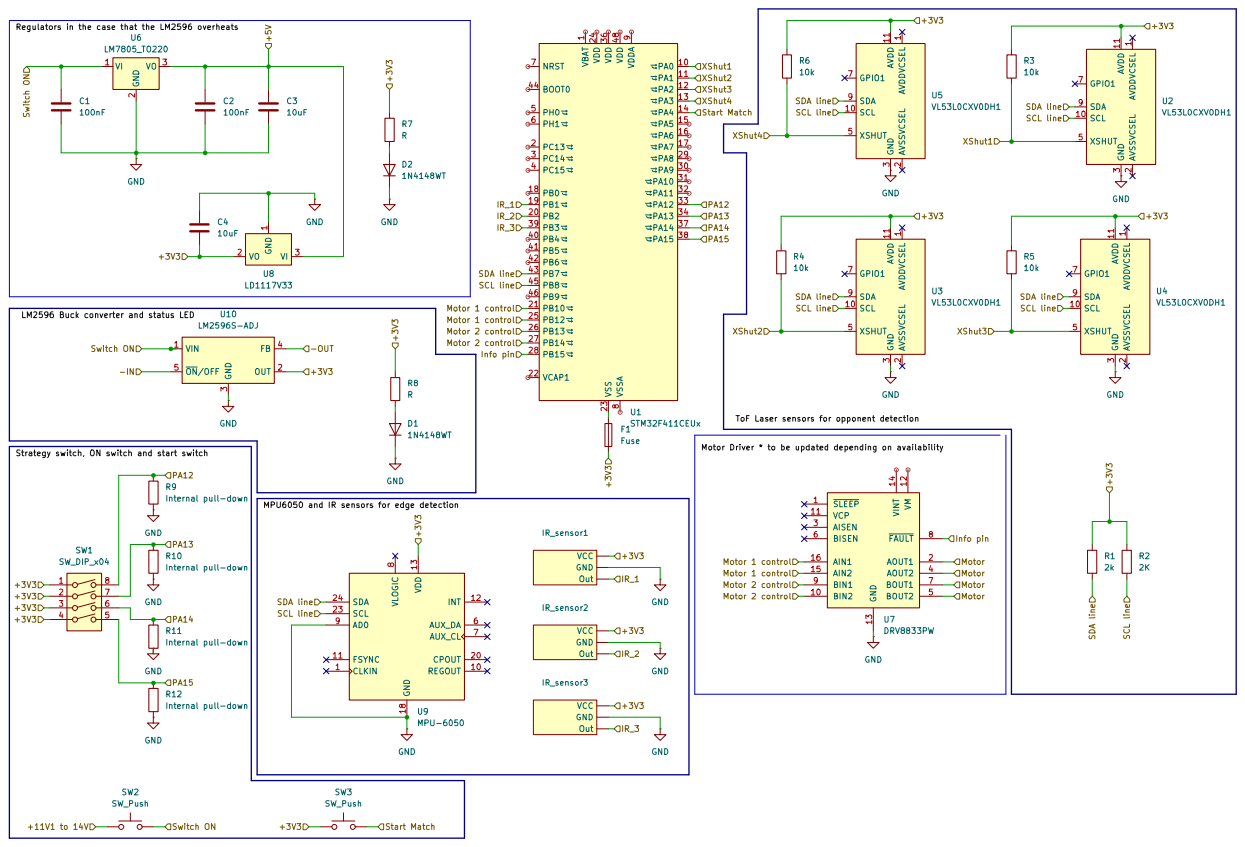
[picture p256: page 1]
