chanelleblan/SumobotSkripsie/KiCAD/schematic_v2.pdf

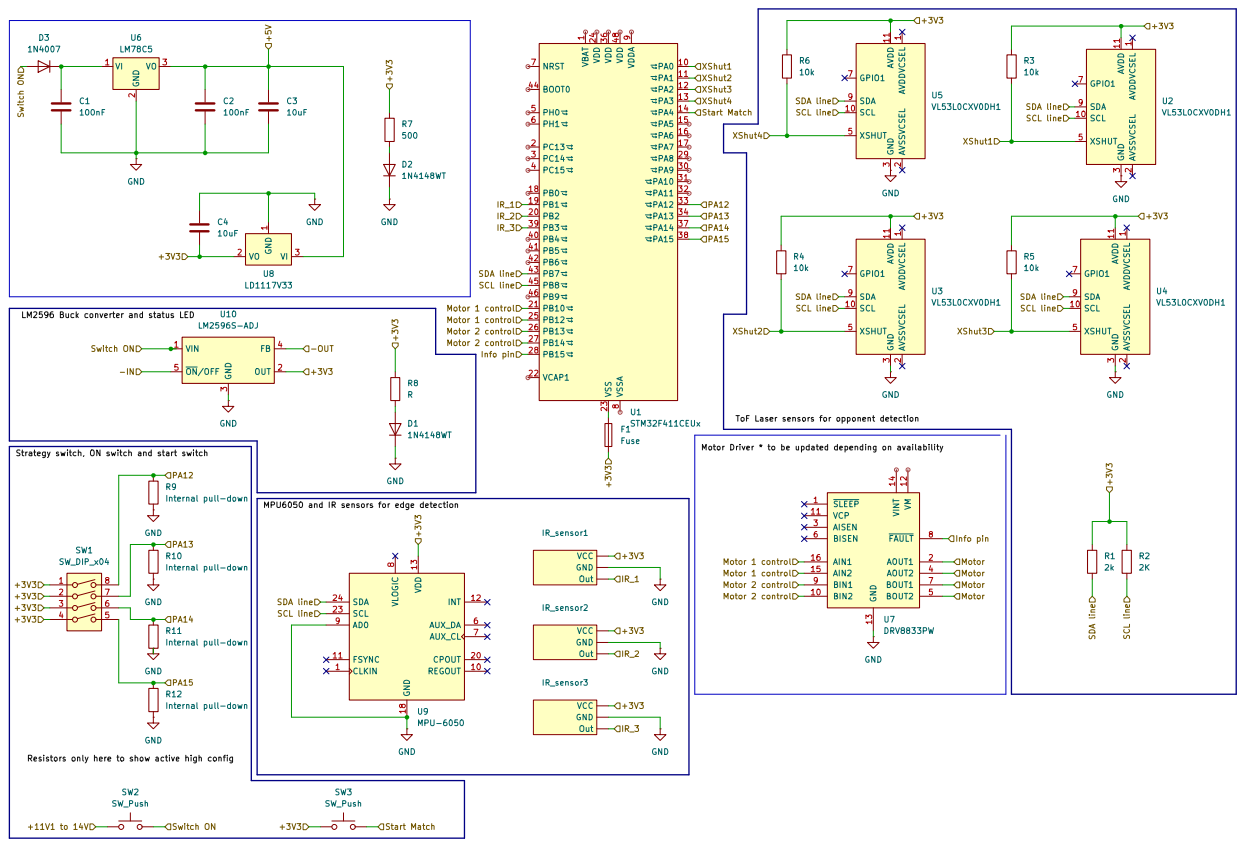
[picture p257: page 1]
