chanelleblan/SumobotSkripsie/KiCAD/Schematic_v4.pdf

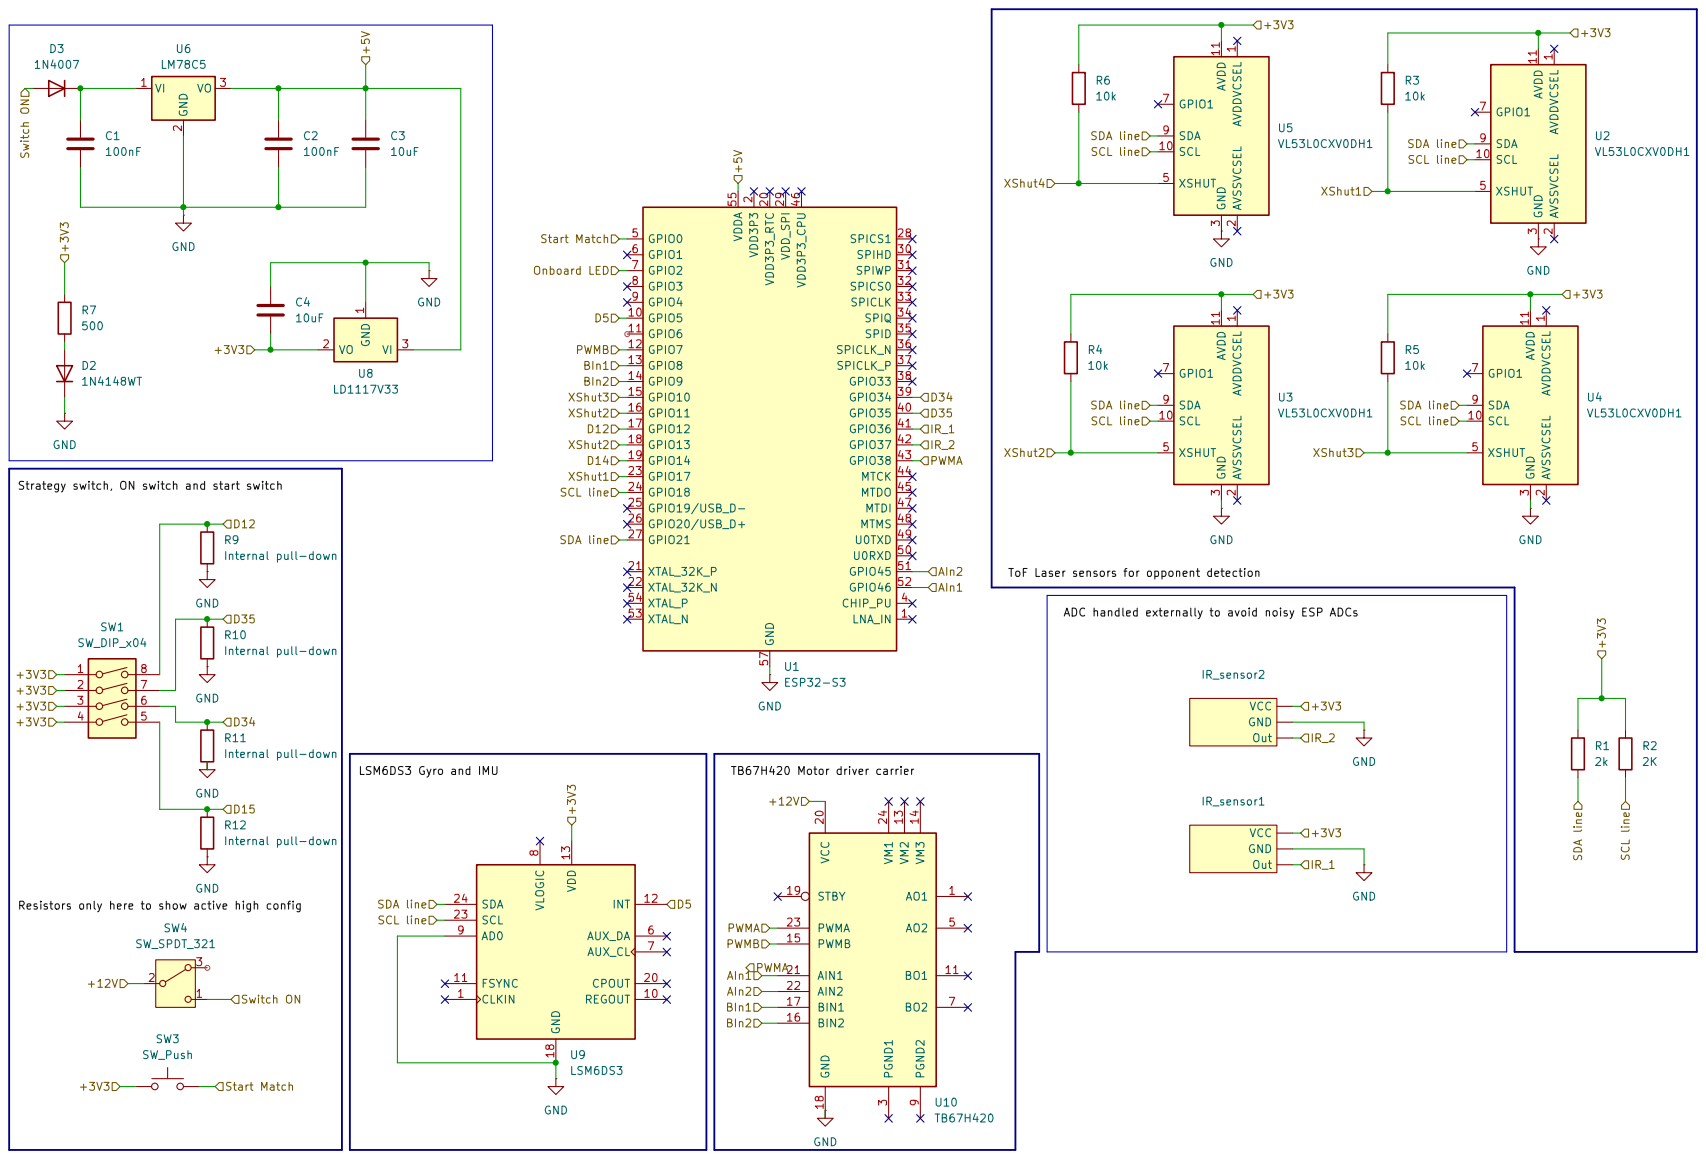
[picture p258: page 1]
