chanelleblan/SumobotSkripsie/KiCAD/Schematic_V5.pdf

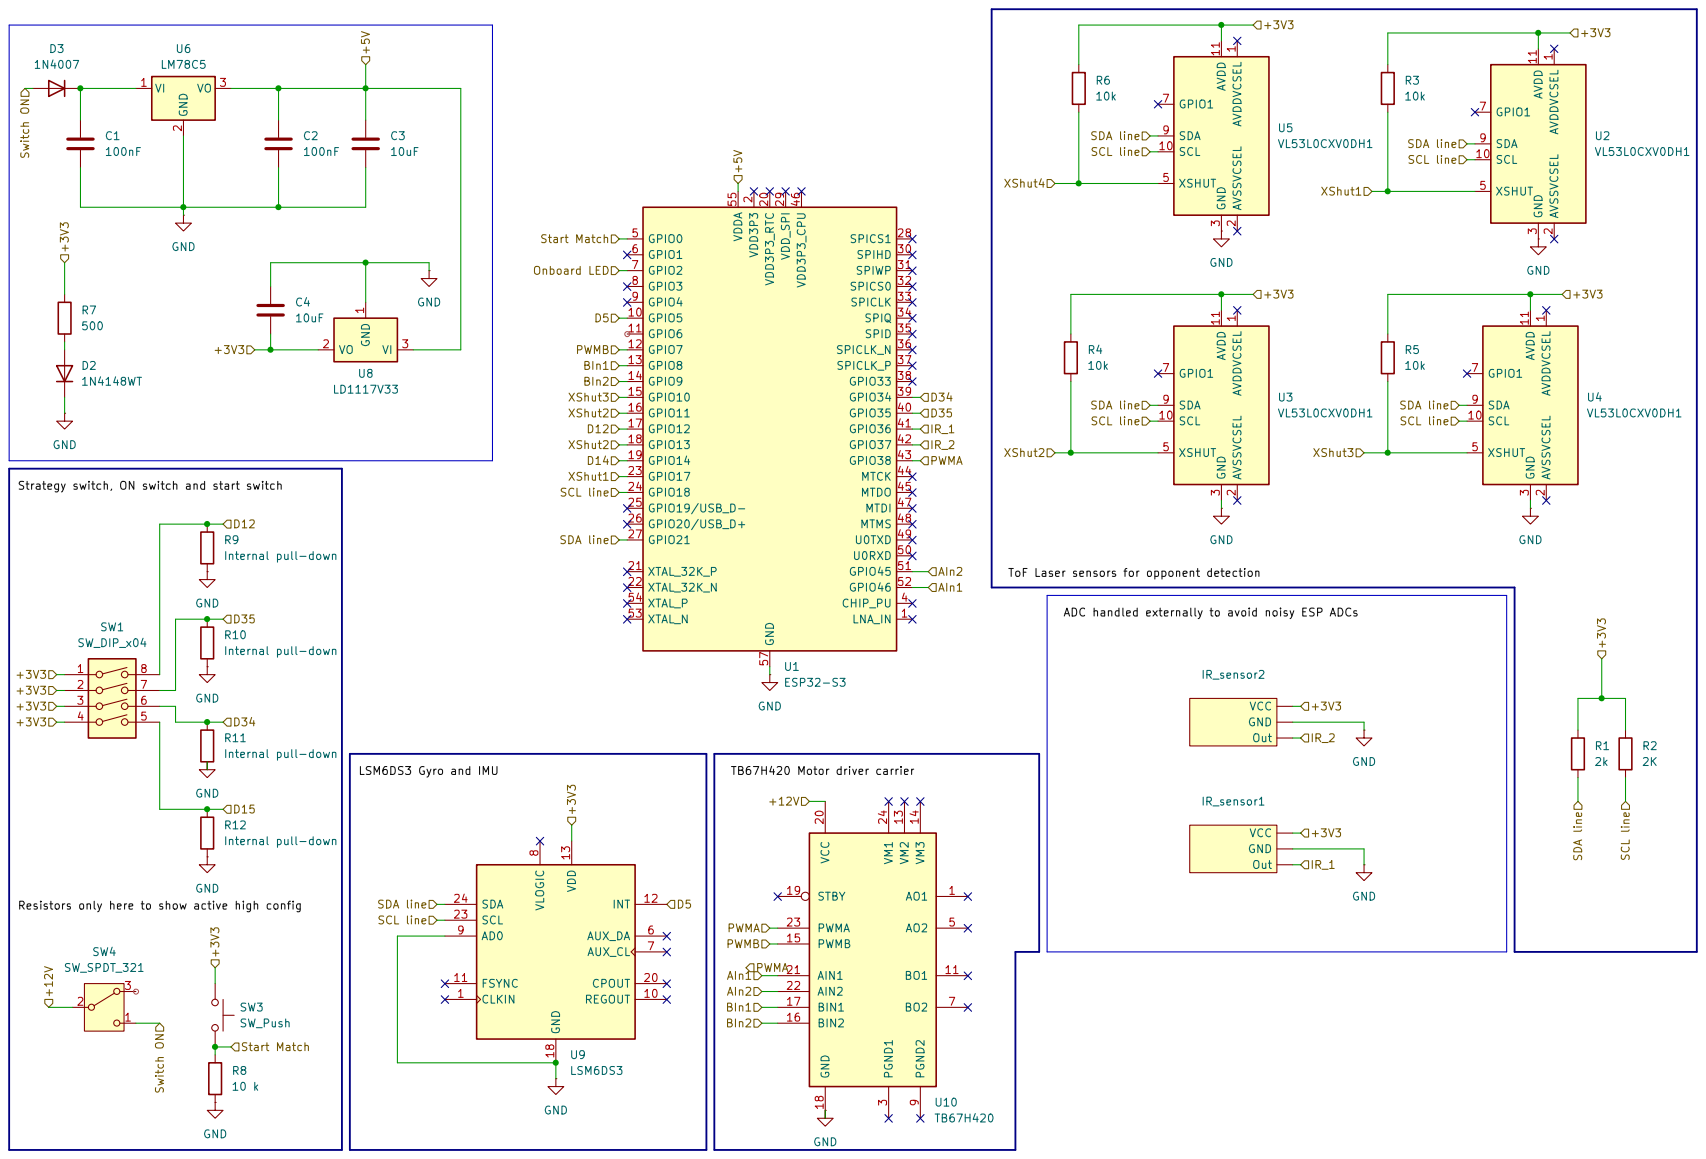
[picture p259: page 1]
