chanelleblan/SumobotSkripsie/KiCAD/sumobot.kicad_pcb

## KiCad design KiCAD/sumobot.kicad_pcb (2026-11-08)

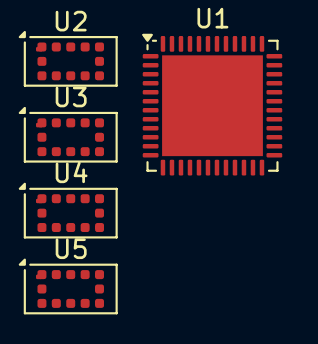
[picture p260: board sumobot.kicad_pcb from above]

Board: 2 copper layers, 5 parts (0 on the bottom side), 5 nets, no tracks yet.

Parts:
U1: STM32F411CEUx; QFN-48-1EP_7x7mm_P0.5mm_EP5.6x5.6mm
U2, U3, U4, U5: VL53L0CXV0DH1; ST_VL53L1x

Connections:
unnamed: U1.23 (VSS), U1.35 (VSS), U1.47 (VSS), U1.49 (VSS)
unnamed: U2.3 (GND), U2.4 (GND), U2.6 (GND), U2.12 (GND)
unnamed: U3.3 (GND), U3.4 (GND), U3.6 (GND), U3.12 (GND)
unnamed: U4.3 (GND), U4.4 (GND), U4.6 (GND), U4.12 (GND)
unnamed: U5.3 (GND), U5.4 (GND), U5.6 (GND), U5.12 (GND)
