chanelleblan/SumobotSkripsie/(commit log)

2026-11-08 Organized and renamed PID stuff
2026-11-08 PID step response data sorted and split off from heading data
2026-11-08 KiCAD stuff added
